RileyCornelius/PD240W/3D_models/case/fit_pcb_isometric.png

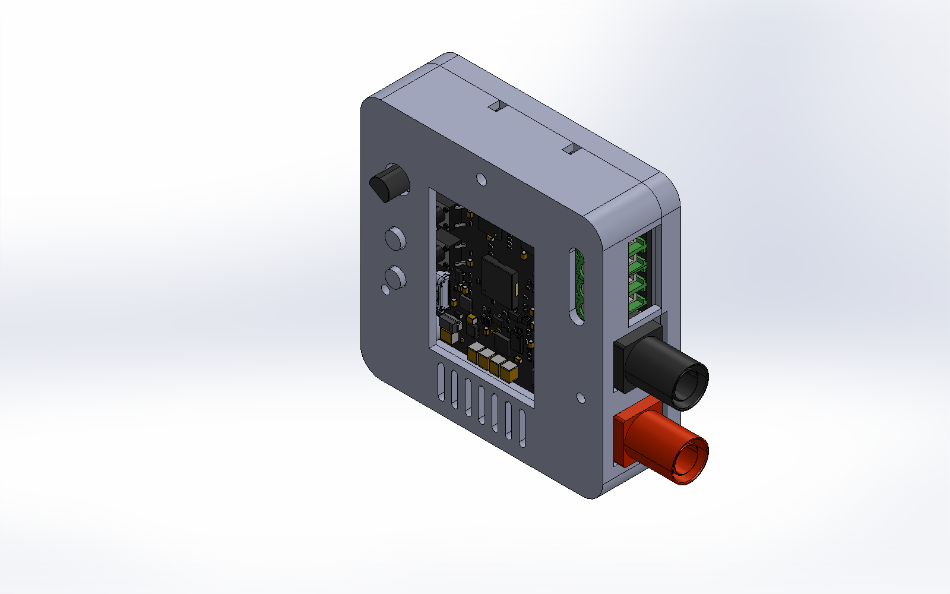
3D_models/case/fit_pcb_isometric.png
