RileyCornelius/PD240W/hardware/Images/PD240W_kicad-bottom.png

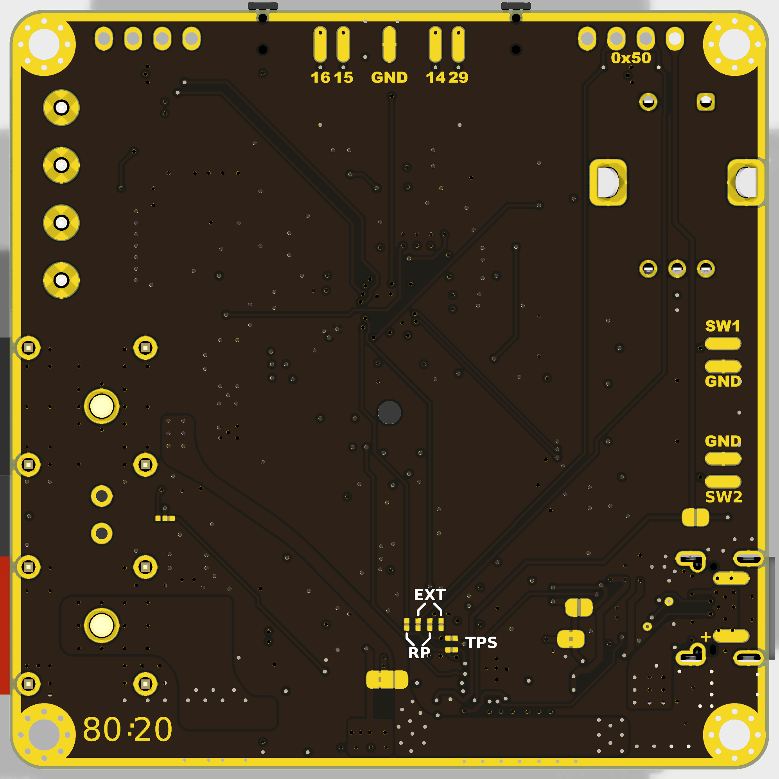
hardware/Images/PD240W_kicad-bottom.png
