RileyCornelius/PD240W/hardware/Images/PD240W_kicad-top.png

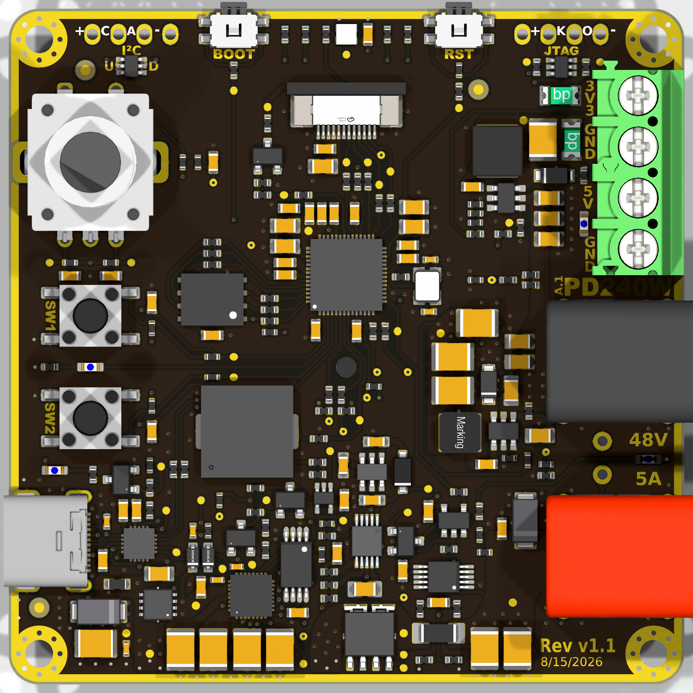
hardware/Images/PD240W_kicad-top.png
