RileyCornelius/PD240W/hardware/Manufacturing/Assembly/PD240W_kicad-bom.html

 | Bill of Materials
 | Schematic: PD240W_kicad Variant: RELEASED Revision: 1.1.0 Date: 2026-02-27 KiCad Version: 10.0.5-unknown-202607221313~667fa36054~ubuntu25.10.1 | Component Groups: 57 Component Count: 211 (per PCB) Fitted Components: 209 (per PCB) Number of PCBs: 1 Total Components: 209 (for 1 PCBs)
Row | Quantity Per PCB | References | Value | Datasheet | Footprint | Description | Manufacturer | MFR Part | Supplier Part Number
1 | 2 | C32 C33 | 15p COG 50V | https://jlcpcb.com/api/file/downloadByFileSystemAccessId/8579707286171729920 | capc_1005_06_n | Capacitor, 15pF, 5%, C0G, 50V, 1005, 0402 | FH (Guangdong Fenghua Advanced Tech)
2 | 2 | C11 C13 | 220p X7R 50V | https://jlcpcb.com/api/file/downloadByFileSystemAccessId/8588946226129604609 | capc_1005_06_l | Capacitor, 220pF, 10%, X7R, 50V, 1005, 0402 | Samsung Electro-Mechanics
3 | 3 | C1 C3 C7 | 10n X7R 100V | https://jlcpcb.com/api/file/downloadByFileSystemAccessId/8588949628376502272 | capc_1005_06_n | Capacitor, 10nF, 10%, X7R, 100V, 1005, 0402 | Yageo
4 | 32 | C4 C6 C8 C10 C16 C20 C21 C23 C24 C25 C26 C27 C30 C31 C38 C39 C40 C41 C42 C43 C44 C45 C46 C47 C48 C49 C50 C51 C52 C54 C62 C63 | 100n X7R 100V | https://jlcpcb.com/api/file/downloadByFileSystemAccessId/8586178586332446721 | capc_1608_09_l | Capacitor, 100nF, 10%, X7R, 100V, 1608, 0603 | Samsung Electro-Mechanics
5 | 13 | C2 C34 C35 C36 C37 C53 C55 C56 C57 C58 C59 C60 C61 | 1u X7R 100V | https://jlcpcb.com/api/file/downloadByFileSystemAccessId/8590904853830971392 | capc_2012_14_n | Capacitor, 1uF, 10%, X7R, 100V, 2012, 0805 | Yageo
6 | 1 | C22 | 2.2u X7R 100V | https://jlcpcb.com/api/file/downloadByFileSystemAccessId/8590916664114966528 | capc_2012_14_m | Capacitor, 2.2nF, 10%, X7R, 100V, 2012, 0805 | Chinocera
7 | 3 | C17 C18 C19 | 3.3u X5R 25V | https://jlcpcb.com/api/file/downloadByFileSystemAccessId/8590902687791857664 | capc_1608_09_n | Capacitor, 3.3uF, 20%, X5R, 25V, 1608, 0603 | CCTC
8 | 1 | C5 | 4.7u | https://jlcpcb.com/api/file/downloadByFileSystemAccessId/8588955064752869376 | capc_3225_22_n | Capacitor, 4.7 uF, 10%, X7S, 100V, 3225, 1210 | Murata Electronics
9 | 9 | C9 C12 C14 C15 C28 C29 C65 C66 C67 | 10u X7R 63V | https://jlcpcb.com/api/file/downloadByFileSystemAccessId/8589835732941770752 | capc_3225_27_n | Capacitor, 10uF, 10%, X7R, 63V, 3225, 1210 | Murata Electronics
10 | 1 | C64 | 22u X7R 25V | https://jlcpcb.com/api/file/downloadByFileSystemAccessId/8589835732941770752 | capc_3225_27_n | Capacitor, 22uF, 10%, X7R, 25V, 1210 | Samsung Electro-Mechanics
11 | 4 | D4 D7 D10 D14 | APTD1608LQBC/D | https://jlcpcb.com/api/file/downloadByFileSystemAccessId/8589837755585884160 | kingbright_0603_blue | Standard LEDs - SMD Chip LED, Package= 0603, Color = Blue | Kingbright
12 | 1 | D6 | B0520LW-7-F | https://jlcpcb.com/api/file/downloadByFileSystemAccessId/8560080535511982080 | sod-123_270x155135_n | Schottky Diodes & Rectifiers 20V 410mW, SMD, SOD123 | Diodes Incorporated
13 | 2 | D2 D3 | BZT52C18SQ | https://jlcpcb.com/api/file/downloadByFileSystemAccessId/8590197770775654400 | sod-323_230p_170x125x100_n | Zener Diode 18V 200mW 5% Surface Mount SOD-323 | JSMSEMI
14 | 2 | D5 D9 | D3V3F4U6S-7 | https://jlcpcb.com/api/file/downloadByFileSystemAccessId/8589951277003141120 | sot363_sc88_65p_200x125x110_n | 4-Ch 3.3V Low Cap TVS Array 0.85pF 3.5A 350mW | Diodes Incorporated
15 | 2 | D12 D13 | MBR1H100SFT3G | https://jlcpcb.com/api/file/downloadByFileSystemAccessId/8588886768716288000 | sod-123fl_305p_260x160x90_n | Rectifier Diode, Schottky, 1 Phase, 1A, 100V | onsemi
16 | 1 | D11 | SK6812-EC20 | https://jlcpcb.com/api/file/downloadByFileSystemAccessId/8589835384537849856 | SK6812-EC20 | RGB LED with integrated controller | OPSCO Optoelectronics
17 | 2 | D1 D8 | SMAJ48A | https://jlcpcb.com/api/file/downloadByFileSystemAccessId/8564879166429958145 | do-214ac_440p_430x250x230_n_p | Diode, TVS, Single, Unidirectional, Vrwm max 48V, Vbr min 53.3V, Vcl max 77.4V, Irm 1uA, peak puls power 400W, C 80pF @50V, IEC61000-4-2 ESD, IEC61000-4-4 EFT, IEC61000-4-5 Surge, DO-214AC, 2.9x4.6x2.65mm, -55°C ~ 150°C | hongjiacheng
18 | 1 | DSP1 | HS20HS072RX | https://jlcpcb.com/api/file/downloadByFileSystemAccessId/8590902731202768896 | generic_display_518x362x2_10mm_standoff | 240x320 (2.4") TFT-LCD panel Integrated driver (ST7789T3) and FPC | HS
19 | 2 | F1 F2 | FSMD020-1206-R | https://jlcpcb.com/api/file/downloadByFileSystemAccessId/8588906240126279680 | ptc_1206_08_n | PTC, 30V, I_ hold 200mA, I_Trip 400mA, Imax 100A, 1206 | Fuzetec Tech
20 | 1 | FB1 | BLM18SN220TH1D | https://jlcpcb.com/api/file/downloadByFileSystemAccessId/8589838767348477952 | fer_1608_09_n | Ferrite Bead, 120Ohm@100MHz, 25%, DCR 25mOhm, 1608, 0603 | Murata Electronics
21 | 2 | J5 J6 | 1935776 | https://jlcpcb.com/api/file/downloadByFileSystemAccessId/8590286408062967808 | phoenix_1935776 | 2 Position Wire to Board Terminal Block Horizontal with Board 0.197" (5.00mm) Through Hole | Phoenix Contact
22 | 1 | J3 | 24.245.1 | https://jlcpcb.com/api/file/downloadByFileSystemAccessId/8590904437944623104 | fcr7350r | 4MM PANEL SKT S16N-PC RED | Changzhou Amass Elec
23 | 1 | J4 | 24.245.2 | https://jlcpcb.com/api/file/downloadByFileSystemAccessId/8590904438813249536 | fcr7350b | 4MM PANEL SKT S16N-PC BLACK | Changzhou Amass Elec
24 | 1 | J8 | AFC07-S12FCA-00 | https://jlcpcb.com/api/file/downloadByFileSystemAccessId/8588894283646029825 | AFC07-S12FCA-00 | 0.3mm 0.5mm 12P 2mm Bottom Contact Slide Lock Surface Mount, Right Angle SMD,P=0.5mm,Surface Mount，Right Angle FFC, FPC (Flat Flexible) Connector Assemblies ROHS | JUSHUO
25 | 1 | J1 | DX07S024JJ2R1300 | https://4donline.ihs.com/images/VipMasterIC/IC/JAEI/JAEI-S-A0001615074/JAEI-S-A0001615074-1.pdf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 | DX07S024JJ2R1300 | USB Connector USB 3.2 Gen 2 TypeC Receptacle Horizontal SMT Body, Height 3.14 mm, 24 Contacts | JAE Electronics
26 | 1 | L2 | 22uH 1A 0.29Ohm | https://jlcpcb.com/api/file/downloadByFileSystemAccessId/8588893270500261888 | SWPA4030S220MT | FIXED IND 22UH 1A 292 MOHM SMD | Sunlord
27 | 1 | L1 | 33uH 1.3A 244mOhm | https://jlc-prod-smt.oss-eu-central-1.aliyuncs.com/smtDataManualFile/8588934098886791168-C9390.pdf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 | L_APV_ANR5020 | FIXED IND 33UH 1.3A 244 MOHM SMD | SXN
28 | 1 | PZ1 | FUET-9018 | https://jlcpcb.com/api/file/downloadByFileSystemAccessId/8588904050284220416 | buzzer_9x9x2.1mm | -30℃~+70℃ 1V~25V 2.1mm 3V 4kHz 5mA 65dB 9mm 9mm Passive (Externally Driven) Piezoelectric SMD, 9x9mm Buzzers ROHS | FUET
29 | 1 | Q1 | AGM612AP | https://jlcpcb.com/api/file/downloadByFileSystemAccessId/8589950125352120320 | vsonp8_65p_330x330x80_mfg | MOSFET, n-channel, 60V, r_ds_on 11mOhm, 10A @Ta=25°C, 50A @Tc=25°C, Vgs_th 1.6V, SMD PDFN-8 pin, (3.3x3.3x0.8mm), -55°C ~ 155°C (Tj) | AGM-Semi
30 | 5 | Q2 Q3 Q4 Q6 Q7 | AO3404A | https://jlcpcb.com/api/file/downloadByFileSystemAccessId/8586177430906146816 | sot-23-3L_103p_300x130x110_n | MOSFET 30V 1.4W, SOT-23-3L | Alpha & Omega Semicon
31 | 1 | Q5 | SQJB90EP-T1_GE3 | https://jlcpcb.com/api/file/downloadByFileSystemAccessId/8588924689125150720 | PowerPAKSO-8_127p_513x615x120_n | Dual NMOS transistor, 6 pin package | Vishay Intertech
32 | 1 | R29 | 8m 1% | https://jlcpcb.com/api/file/downloadByFileSystemAccessId/8590227465076842496 | WSLP1206_n_current_sense_6m_to_50m | Resistor, 8m, 1%, 50ppm, 1W, 3216, 1206 | Milliohm
33 | 1 | R79 | 3.9R 1% | https://jlcpcb.com/api/file/downloadByFileSystemAccessId/8590208739052445696 | resc_1005_04_m | Resistor, 3.9R, 1%, 200ppm, 1/16W, 1005, 0402 | FOJAN
34 | 29 | R18 R28 R30 R31 R37 R38 R39 R40 R41 R42 R43 R44 R45 R46 R48 R49 R50 R51 R52 R56 R57 R58 R59 R60 R61 R62 R63 R65 R77 | 27R 1% | https://jlcpcb.com/api/file/downloadByFileSystemAccessId/8588899757724995584 | resc_1005_04_m | Resistor, 27R, 1%, 100ppm, 1/16W, 1005, 0402 | Yageo
35 | 3 | R21 R67 R71 | 330R 1% | https://jlcpcb.com/api/file/downloadByFileSystemAccessId/8579706017514917888 | resc_1005_04_m | Resistor, 330R, 1%, 100ppm, 1/16W, 1005, 0402 | UNI-ROYAL(Uniroyal Elec)
36 | 8 | R6 R36 R47 R53 R54 R55 R64 R90 | 1k 1% | https://jlcpcb.com/api/file/downloadByFileSystemAccessId/8579705924167974912 | resc_1005_04_m | Resistor, 1k, 1%, 100ppm, 1/16W, 1005, 0402 | UNI-ROYAL(Uniroyal Elec)
37 | 8 | R7 R8 R10 R11 R17 R26 R32 R83 | 4.7k 1% | https://jlcpcb.com/api/file/downloadByFileSystemAccessId/8579705919464263680 | resc_1005_04_m | Resistor, 4.7k, 1%, 100ppm, 1/16W, 1005, 0402 | UNI-ROYAL(Uniroyal Elec)
38 | 16 | R2 R9 R12 R16 R24 R35 R66 R69 R70 R72 R73 R76 R85 R86 R87 R89 | 10k 1% | https://jlcpcb.com/api/file/downloadByFileSystemAccessId/8556212101498380288 | resc_1005_04_n | Resistor, 10k, 1%, ±25ppm, 1/16W, 1005, 0402 | UNI-ROYAL(Uniroyal Elec)
39 | 9 | R1 R5 R33 R34 R68 R74 R75 R82 R88 | 33k 1% | https://jlcpcb.com/api/file/downloadByFileSystemAccessId/8671329089120387072 | resc_1005_04_n | Resistor, 33k, 1%, 100ppm, 1/16W, 1005, 0402 | Yageo
40 | 14 | R3 R4 R13 R14 R15 R19 R20 R22 R23 R25 R78 R80 R81 R84 | 100k 1% | https://jlcpcb.com/api/file/downloadByFileSystemAccessId/8579705919464263680 | resc_1005_04_m | Resistor, 100k, 1%, 100ppm, 1/16W, 1005, 0402 | UNI-ROYAL(Uniroyal Elec)
41 | 1 | R27 | 10k @25°C | https://jlcpcb.com/api/file/downloadByFileSystemAccessId/8588905414750572545 | resc_1005_04_m | NTC Thermistors 10k @25°C, B3950, 0.33mA max | Sunlord
42 | 2 | S1 S2 | EVQ-PUC02K | https://jlcpcb.com/api/file/downloadByFileSystemAccessId/8588918409580974080 | EVQPUC02K | Small-sized Side-operational SMD Light Touch Switches with straight terminals, with boss. | Panasonic
43 | 2 | S3 S5 | GT-TC120A-H120-L1 | https://jlcpcb.com/api/file/downloadByFileSystemAccessId/8588904166035374080 | GT-TC120A-H120-L1 | Tactile switch SMD, black round button 12mm. | G-Switch
44 | 1 | S4 | PEC11R-4215F-S0024 | https://jlcpcb.com/api/file/downloadByFileSystemAccessId/8588891509874049024 | PEC11R-4215F-S0024 | Rotary Encoders 15mm SHAFT w/SWITCH 24 detents, 24 PPR | Bourns
45 | 1 | U5 | 74LVC1G08SE-7 | https://jlcpcb.com/api/file/downloadByFileSystemAccessId/8588934949626130432 | sot353_65p_200x125x110_mo-203-aa_n | Single 2-input AND gate | Diodes Incorporated
46 | 1 | U3 | CAT24C512YI-GT3 | https://jlcpcb.com/api/file/downloadByFileSystemAccessId/8588881550012796928 | JEDEC_MO-153_AA | 512 Kb I2C CMOS Serial | Onsemi
47 | 1 | U7 | INA228AIDGSR | https://www.ti.com/lit/ds/symlink/ina228.pdf | vssop10_50p_300x300x110_mfg | INA240 High- and Low-Side, Bidirectional, Zero-Drift, Current-Sense Amplifier with | Texas Instruments
48 | 1 | U4 | LM2765 | https://www.ti.com/cn/lit/ds/symlink/lm2765.pdf?ts=1773109320900 | sot236_p95_290x160x110_n | Switched-Capacitor Voltage Converter, 40mA, input 1.8-5.5V, out =2xVIN, 50kHz, SOT-23, -40°C~+85°C | Texas Instruments
49 | 2 | U11 U12 | LMR16006XDDCR | https://www.ti.com/cn/lit/ds/symlink/lmr16006.pdf?ts=1773033603279 | sot6_p95_290x180x110_n | LMR16006 SIMPLE SWITCHER® 60 V 0.6 A Buck Regulators With High Efficiency ECO mode, 600mA, input 4-65V, out 4-65V, 700kHz, SOT-6, -40°C~+125°C | Texas Instruments
50 | 1 | U6 | LTC7004x | https://jlcpcb.com/api/file/downloadByFileSystemAccessId/8588908169414520832 | msop_10p_300x490x110_tp168x188_n | Fast 60V High Side NMOS Static Switch Driver. | Analog Devices
51 | 1 | U10 | RP2040 | https://pip-assets.raspberrypi.com/categories/814-rp2040/documents/RP-008371-DS-1-rp2040-datasheet.pdf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 | qfn56_40p_700x700x90_tp_320x320_mfg | ARM® Cortex-M0+ - Microcontroller IC 32-Bit Dual-Core 133MHz External Program Memory 56-QFN (7x7) | Raspberry Pi
52 | 1 | U8 | SN74LVC1G17DBVR | https://www.ti.com/lit/ds/symlink/sn74lvc1g17.pdf?ts=1773125655769 | sot25_95p_300x280x145_jedec_mo-178-aa_n | SN74LVC1G17 Single Schmitt-Trigger Buffer | Texas Instruments
53 | 1 | U1 | TPD4S480RUKR | https://www.ti.com/lit/ds/symlink/tpd4s480.pdf?ts=1773161250726 | wqfn20_40p_300x300x80_tp_170x170_n | USB Type-C™ 48V EPR port protector with short-to-VBUS overvoltage and IEC ESD protection 20-WQFN -40 to 125 | Texas Instrument
54 | 1 | U2 | TPS26750SRSMR | https://www.ti.com/lit/ds/symlink/tps26750.pdf | qfn32_40p_400x400x100_tp_280x280_mfg | TPS26750 USB Type-C® and USB PD Controller With Integrated Power Switches | Texas Instruments
55 | 1 | U9 | W25Q128JVPIQ | https://jlcpcb.com/api/file/downloadByFileSystemAccessId/8588881960005472256 | wson8_127p_600x500x80_tp_435x340_n | 3V 128M-BIT SERIAL FLASH MEMORY WITH DUAL/QUAD SPI | Winbond Electronics
56 | 1 | Y1 | ABM8-272-T3 | https://jlcpcb.com/api/file/downloadByFileSystemAccessId/8559470777180311552 | osccc_320x205x80_abm8 | Crystal 12MHz 10pF 30ppm -40C +85C | Abracon LLC
Row | Quantity Per PCB | References | Value | Datasheet | Footprint | Description | Manufacturer | MFR Part | Supplier Part Number
1 | 2 | J2 J7 | 61300411121 | https://www.we-online.com/components/products/datasheet/61300411121.pdf | we_61300411121 | Pin header, 2.54mm pitch, 4 Position, 1 Row, 8.64mm Height, Male | WÜRTH ELEKTRONIK
Color reference for columns:
KiCad Fields (default)
Generated Fields
User Fields
Empty Fields
