RileyCornelius/PD240W/hardware/production/bom.csv

Designator | Footprint | Quantity | Value | LCSC Part #
C1, C3, C7 | capc_1005_06_n | 3 | 10n X7R 100V | C527014
C10, C16, C20, C21, C23, C24, C25, C26, C27, C30, C31, C38, C39, C4, C40, C41, C42, C43, C44, C45, C46, C47, C48, C49, C50, C51, C52, C54, C6, C62, C63, C8 | capc_1608_09_l | 32 | 100n X7R 100V | C15725
C11, C13 | capc_1005_06_l | 2 | 220p X7R 50V | C296710
C12, C14, C15, C28, C29, C65, C66, C67, C9 | capc_3225_27_n | 9 | 10u X7R 63V | C437568
C17, C18, C19 | capc_1608_09_n | 3 | 3.3u X5R 25V | C5360803
C2, C34, C35, C36, C37, C53, C55, C56, C57, C58, C59, C60, C61 | capc_2012_14_n | 13 | 1u X7R 100V | C5370002
C22 | capc_2012_14_m | 1 | 2.2u X7R 100V | C22367838
C32, C33 | capc_1005_06_n | 2 | 15p COG 50V | C1548
C5 | capc_3225_22_n | 1 | 4.7u | C913445
C64 | capc_3225_27_n | 1 | 22u X7R 25V | C309062
D1, D8 | do-214ac_440p_430x250x230_n_p | 2 | SMAJ48A | C41376401
D10, D14, D4, D7 | kingbright_0603_blue | 4 | APTD1608LQBC/D | C5344742
D11 | SK6812-EC20 | 1 | SK6812-EC20 | C2909058
D12, D13 | sod-123fl_305p_260x160x90_n | 2 | MBR1H100SFT3G | C235757
D2, D3 | sod-323_230p_170x125x100_n | 2 | BZT52C18SQ | C2857090
D5, D9 | sot363_sc88_65p_200x125x110_n | 2 | D3V3F4U6S-7 | C1869321
D6 | sod-123_270x155135_n | 1 | B0520LW-7-F | C155367
DSP1 | generic_display_518x362x2_10mm_standoff | 1 | HS20HS072RX | C5329582
F1, F2 | ptc_1206_08_n | 2 | FSMD020-1206-R | C220145
FB1 | fer_1608_09_n | 1 | BLM18SN220TH1D | C710392
J1 | DX07S024JJ2R1300 | 1 | DX07S024JJ2R1300 | C2977282
J3 | fcr7350r | 1 | 24.245.1 | C7437326
J4 | fcr7350b | 1 | 24.245.2 | C7437327
J5, J6 | phoenix_1935776 | 2 | 1935776 | C3817389
J8 | AFC07-S12FCA-00 | 1 | AFC07-S12FCA-00 | C262559
L1 | L_APV_ANR5020 | 1 | 33uH 1.3A 244mOhm | C9390
L2 | SWPA4030S220MT | 1 | 22uH 1A 0.29Ohm | C83472
PZ1 | buzzer_9x9x2.1mm | 1 | FUET-9018 | C391035
Q1 | vsonp8_65p_330x330x80_mfg | 1 | AGM612AP | C5349119
Q2, Q3, Q4, Q6, Q7 | sot-23-3L_103p_300x130x110_n | 5 | AO3404A | C30010
Q5 | PowerPAKSO-8_127p_513x615x120_n | 1 | SQJB90EP-T1_GE3 | C727731
R1, R33, R34, R5, R68, R74, R75, R82, R88 | resc_1005_04_n | 9 | 33k 1% | C138003
R10, R11, R17, R26, R32, R7, R8, R83 | resc_1005_04_m | 8 | 4.7k 1% | C25900
R12, R16, R2, R24, R35, R66, R69, R70, R72, R73, R76, R85, R86, R87, R89, R9 | resc_1005_04_n | 16 | 10k 1% | C25744
R13, R14, R15, R19, R20, R22, R23, R25, R3, R4, R78, R80, R81, R84 | resc_1005_04_m | 14 | 100k 1% | C25741
R18, R28, R30, R31, R37, R38, R39, R40, R41, R42, R43, R44, R45, R46, R48, R49, R50, R51, R52, R56, R57, R58, R59, R60, R61, R62, R63, R65, R77 | resc_1005_04_m | 29 | 27R 1% | C138021
R21, R67, R71 | resc_1005_04_m | 3 | 330R 1% | C25104
R27 | resc_1005_04_m | 1 | 10k @25°C | C95939
R29 | WSLP1206_n_current_sense_6m_to_50m | 1 | 8m 1% | C2988654
R36, R47, R53, R54, R55, R6, R64, R90 | resc_1005_04_m | 8 | 1k 1% | C11702
R79 | resc_1005_04_m | 1 | 3.9R 1% | C2933095
S1, S2 | EVQPUC02K | 2 | EVQ-PUC02K | C2936858
S3, S5 | GT-TC120A-H120-L1 | 2 | GT-TC120A-H120-L1 | C2762973
S4 | PEC11R-4215F-S0024 | 1 | PEC11R-4215F-S0024 | C143790
U1 | wqfn20_40p_300x300x80_tp_170x170_n | 1 | TPD4S480RUKR | C43131250
U10 | qfn56_40p_700x700x90_tp_320x320_mfg | 1 | RP2040 | C2040
U11, U12 | sot6_p95_290x180x110_n | 2 | LMR16006XDDCR | C87080
U2 | qfn32_40p_400x400x100_tp_280x280_mfg | 1 | TPS26750SRSMR | C42166327
U3 | JEDEC_MO-153_AA | 1 | CAT24C512YI-GT3 | C56096
U4 | sot236_p95_290x160x110_n | 1 | LM2765 | C140270
U5 | sot353_65p_200x125x110_mo-203-aa_n | 1 | 74LVC1G08SE-7 | C460522
U6 | msop_10p_300x490x110_tp168x188_n | 1 | LTC7004x | C690105
U7 | vssop10_50p_300x300x110_mfg | 1 | INA228AIDGSR | C5214669
U8 | sot25_95p_300x280x145_jedec_mo-178-aa_n | 1 | SN74LVC1G17DBVR | C7836
U9 | wson8_127p_600x500x80_tp_435x340_n | 1 | W25Q128JVPIQ | C2441427
Y1 | osccc_320x205x80_abm8 | 1 | ABM8-272-T3 | C20625731
