RileyCornelius/PD240W/PCB_files/production/PD240W_BOM_costed.xlsx

Sheet: Summary
PD240W - BOM cost summary
Yellow cells are inputs. Change a build size and every price on the BOM tab re-looks-up its volume tier.
Build sizes (boards)
Build A | 1
Build B | 10
Build C | 100
Board content
Unique line items (distinct LCSC parts) | 56
Total placements per board | 209
Basic-library parts | 6
Preferred-library parts | 1
Extended-library parts (extra JLC setup fee each) | 49
Component cost
Build size (boards) | Total BOM cost | Cost per board
1 | $58.80 | $58.80
10 | $522.61 | $52.26
100 | $4489.81 | $44.90
Supply risk
Parts out of stock at JLC | 1
Parts short of the 10-board need | 1
Parts short of the 100-board need | 2
Excluded from these figures: PCB fabrication, assembly, stencil, setup and extended-part fees, shipping, duty.
Price source: JLCPCB/LCSC parts API, retrieved 2026-08-23. Quantities: KiCad export PCB_files/production/bom.csv (rev 1.1.0).

Sheet: BOM
PD240W - PCB Bill of Materials (JLCPCB / LCSC pricing)
Prices in USD from LCSC/JLCPCB volume tiers. Unit price is looked up from the Price Tiers tab against the total quantity that build size requires. Source: JLCPCB parts API, retrieved 2026-08-23.
# | Designators | Qty/Bd | Value (KiCad) | Footprint | LCSC # | Manufacturer Part No. | Manufacturer | Package | JLC Library | JLC Stock | Description | Unit $ @ 1 bd | Ext $ @ 1 bd | Unit $ @ 10 bd | Ext $ @ 10 bd | Unit $ @ 100 bd | Ext $ @ 100 bd | Stock Status | LCSC Link
1 | C1, C3, C7 | 3 | 10n X7R 100V | capc_1005_06_n | C527014 | CC0402KRX7R0BB103 | YAGEO | 0402 | Extended | 338390 | Cap 10nF 100V X7R ±10% | $0.0129 | $0.04 | $0.0129 | $0.39 | $0.0129 | $3.87 | OK | LCSC (https://www.lcsc.com/product-detail/multilayer-ceramic-capacitors-mlcc-smd-smt_yageo-cc0402krx7r0bb103_C527014.html)
2 | C2, C34, C35, C36, C37, C53, C55, C56, C57, C58, C59, C60, C61 | 13 | 1u X7R 100V | capc_2012_14_n | C5370002 | CC0805KKX7R0BB105 | YAGEO | 0805 | Extended | 436703 | Cap 1uF 100V X7R ±10% | $0.1064 | $1.38 | $0.0941 | $12.23 | $0.0877 | $114.01 | OK | LCSC (https://www.lcsc.com/product-detail/multilayer-ceramic-capacitors-mlcc-smd-smt_yageo-cc0805kkx7r0bb105_C5370002.html)
3 | C5 | 1 | 4.7u | capc_3225_22_n | C913445 | GCM32DC72A475KE02L | Murata Electronics | 1210 | Extended | 53357 | Cap 4.7uF 100V X7S ±10% | $0.9111 | $0.91 | $0.8056 | $8.06 | $0.7032 | $70.32 | OK | LCSC (https://www.lcsc.com/product-detail/multilayer-ceramic-capacitors-mlcc-smd-smt_murata-electronics-gcm32dc72a475ke02l_C913445.html)
4 | C4, C6, C8, C10, C16, C20, C21, C23, C24, C25, C26, C27, C30, C31, C38, C39, C40, C41, C42, C43, C44, C45, C46, C47, C48, C49, C50, C51, C52, C54, C62, C63 | 32 | 100n X7R 100V | capc_1608_09_l | C15725 | CL10B104KC8NNNC | Samsung Electro-Mechanics | 0603 | Extended | 1233663 | Cap 100nF 100V X7R ±10% | $0.0157 | $0.50 | $0.0157 | $5.02 | $0.0104 | $33.28 | OK | LCSC (https://www.lcsc.com/product-detail/multilayer-ceramic-capacitors-mlcc-smd-smt_samsung-electro-mechanics-cl10b104kc8nnnc_C15725.html)
5 | C11, C13 | 2 | 220p X7R 50V | capc_1005_06_l | C296710 | CL05B221KB5NNNC | Samsung Electro-Mechanics | 0402 | Extended | 119508 | Cap 220pF 50V X7R ±10% | $0.0056 | $0.01 | $0.0056 | $0.11 | $0.0056 | $1.12 | OK | LCSC (https://www.lcsc.com/product-detail/multilayer-ceramic-capacitors-mlcc-smd-smt_samsung-electro-mechanics-cl05b221kb5nnnc_C296710.html)
6 | C9, C12, C14, C15, C28, C29, C65, C66, C67 | 9 | 10u X7R 63V | capc_3225_27_n | C437568 | GRM32ER71J106KA12L | Murata Electronics | 1210 | Extended | 29931 | Cap 10uF 63V X7R ±10% | $0.9046 | $8.14 | $0.7406 | $66.65 | $0.6805 | $612.45 | OK | LCSC (https://www.lcsc.com/product-detail/multilayer-ceramic-capacitors-mlcc-smd-smt_murata-electronics-grm32er71j106ka12l_C437568.html)
7 | C17, C18, C19 | 3 | 3.3u X5R 25V | capc_1608_09_n | C5360803 | TCC0603X5R335M250CT | CCTC | 0603 | Extended | 101843 | Cap 3.3uF 25V X5R ±20% | $0.0270 | $0.08 | $0.0270 | $0.81 | $0.0215 | $6.45 | OK | LCSC (https://www.lcsc.com/product-detail/multilayer-ceramic-capacitors-mlcc-smd-smt_cctc-tcc0603x5r335m250ct_C5360803.html)
8 | C22 | 1 | 2.2u X7R 100V | capc_2012_14_m | C22367838 | HHV0805R7225K101NSLJ | Chinocera | 0805 | Extended | 103869 | Cap 2.2uF 100V X7R ±10% | $0.3557 | $0.36 | $0.2745 | $2.75 | $0.1998 | $19.98 | OK | LCSC (https://www.lcsc.com/product-detail/multilayer-ceramic-capacitors-mlcc-smd-smt_chinocera-hhv0805r7225k101nslj_C22367838.html)
9 | C32, C33 | 2 | 15p COG 50V | capc_1005_06_n | C1548 | 0402CG150J500NT | FH (Guangdong Fenghua) | 0402 | Basic | 2022686 | Cap 15pF 50V C0G ±5% | $0.0047 | $0.01 | $0.0047 | $0.09 | $0.0047 | $0.94 | OK | LCSC (https://www.lcsc.com/product-detail/multilayer-ceramic-capacitors-mlcc-smd-smt_fh-guangdong-fenghua-advanced-tech-0402cg150j500nt_C1548.html)
10 | C64 | 1 | 22u X7R 25V | capc_3225_27_n | C309062 | CL32B226KAJNNNE | Samsung Electro-Mechanics | 1210 | Extended | 349290 | Cap 22uF 25V X7R ±10% | $0.3703 | $0.37 | $0.2979 | $2.98 | $0.2311 | $23.11 | OK | LCSC (https://www.lcsc.com/product-detail/multilayer-ceramic-capacitors-mlcc-smd-smt_samsung-electro-mechanics-cl32b226kajnnne_C309062.html)
11 | D1, D8 | 2 | SMAJ48A | do-214ac_440p_430x250x230_n_p | C41376401 | SMAJ48A | hongjiacheng | DO-214AC (SMA) | Preferred | 34117 | TVS diode 48V 400W unidirectional | $0.0372 | $0.07 | $0.0372 | $0.74 | $0.0294 | $5.88 | OK | LCSC (https://www.lcsc.com/product-detail/esd-and-surge-protection-tvs-esd_hongjiacheng-smaj48a_C41376401.html)
12 | D2, D3 | 2 | BZT52C18SQ | sod-323_230p_170x125x100_n | C2857090 | BZT52C18SQ | JSMSEMI | SOD-323 | Extended | 174 | Zener diode 18V 200mW | $0.0192 | $0.04 | $0.0192 | $0.38 | $0.0192 | $3.84 | Tight - under 100-board need | LCSC (https://www.lcsc.com/product-detail/zener-diodes_jsmsemi-bzt52c18sq_C2857090.html)
13 | D5, D9 | 2 | D3V3F4U6S-7 | sot363_sc88_65p_200x125x110_n | C1869321 | D3V3F4U6S-7 | Diodes Incorporated | SOT-363 | Extended | 88 | ESD array 4-ch 3.3V 0.85pF | $0.1988 | $0.40 | $0.1988 | $3.98 | $0.1922 | $38.44 | Tight - under 100-board need | LCSC (https://www.lcsc.com/product-detail/esd-and-surge-protection-tvs-esd_diodes-incorporated-d3v3f4u6s-7_C1869321.html)
14 | D6 | 1 | B0520LW-7-F | sod-123_270x155135_n | C155367 | B0520LW-7-F | Diodes Incorporated | SOD-123 | Extended | 67460 | Schottky diode 20V 500mA | $0.1272 | $0.13 | $0.1272 | $1.27 | $0.1030 | $10.30 | OK | LCSC (https://www.lcsc.com/product-detail/schottky-diodes_diodes-incorporated-b0520lw-7-f_C155367.html)
15 | D4, D7, D10, D14 | 4 | APTD1608LQBC/D | kingbright_0603_blue | C5344742 | APTD1608LQBC/D | Kingbright | 0603 | Extended | 1917 | LED blue 465nm 20mcd | $0.3013 | $1.21 | $0.3013 | $12.05 | $0.2045 | $81.80 | OK | LCSC (https://www.lcsc.com/product-detail/led-indication-discrete_kingbright-aptd1608lqbc-d_C5344742.html)
16 | D11 | 1 | SK6812-EC20 | SK6812-EC20 | C2909058 | SK6812-EC20 | OPSCO Optoelectronics | SMD 2x2mm | Extended | 10625 | RGB LED with built-in controller | $0.1102 | $0.11 | $0.1102 | $1.10 | $0.0882 | $8.82 | OK | LCSC (https://www.lcsc.com/product-detail/rgb-leds-built-in-ic_opsco-optoelectronics-sk6812-ec20_C2909058.html)
17 | D12, D13 | 2 | MBR1H100SFT3G | sod-123fl_305p_260x160x90_n | C235757 | MBR1H100SFT3G | onsemi | SOD-123FL | Extended | 13097 | Schottky diode 100V 1A | $0.2565 | $0.51 | $0.2565 | $5.13 | $0.1865 | $37.30 | OK | LCSC (https://www.lcsc.com/product-detail/schottky-diodes_onsemi-mbr1h100sft3g_C235757.html)
18 | DSP1 | 1 | HS20HS072RX | generic_display_518x362x2_10mm_standoff | C5329582 | HS20HS072RX | HS | LCD module | Extended | 3005 | LCD 2.0in 320x240 ST7789 SPI | $3.5891 | $3.59 | $3.0532 | $30.53 | $2.4133 | $241.33 | OK | LCSC (https://www.lcsc.com/product-detail/lcd-screen_hs-hs20hs072rx_C5329582.html)
19 | F1, F2 | 2 | FSMD020-1206-R | ptc_1206_08_n | C220145 | FSMD020-1206-R | Fuzetec Tech | 1206 | Extended | 32902 | PTC resettable fuse 200mA 30V | $0.0687 | $0.14 | $0.0687 | $1.37 | $0.0553 | $11.06 | OK | LCSC (https://www.lcsc.com/product-detail/resettable-fuses_fuzetec-tech-fsmd020-1206-r_C220145.html)
20 | FB1 | 1 | BLM18SN220TH1D | fer_1608_09_n | C710392 | BLM18SN220TH1D | Murata Electronics | 0603 | Extended | 1016 | Ferrite bead 22R@100MHz 8A | $0.2130 | $0.21 | $0.2130 | $2.13 | $0.1828 | $18.28 | OK | LCSC (https://www.lcsc.com/product-detail/ferrite-beads_murata-electronics-blm18sn220th1d_C710392.html)
21 | J1 | 1 | DX07S024JJ2R1300 | DX07S024JJ2R1300 | C2977282 | DX07S024JJ2R1300 | JAE Electronics | SMD | Extended | 3128 | USB Type-C receptacle 24P 48V | $0.7227 | $0.72 | $0.7227 | $7.23 | $0.7227 | $72.27 | OK | LCSC (https://www.lcsc.com/product-detail/usb-connectors_jae-electronics-dx07s024jj2r1300_C2977282.html)
22 | J3 | 1 | 24.245.1 | fcr7350r | C7437326 | 24.245.1 | Changzhou Amass Elec | Through hole | Extended | 8050 | 4mm banana socket red 24A | $1.2830 | $1.28 | $1.2132 | $12.13 | $1.2132 | $121.32 | OK | LCSC (https://www.lcsc.com/product-detail/banana-connectors-alligator-clips_changzhou-amass-elec-24-245-1_C7437326.html)
23 | J4 | 1 | 24.245.2 | fcr7350b | C7437327 | 24.245.2 | Changzhou Amass Elec | Through hole | Extended | 10675 | 4mm banana socket black 24A | $1.2083 | $1.21 | $1.1385 | $11.38 | $1.1385 | $113.85 | OK | LCSC (https://www.lcsc.com/product-detail/banana-connectors-alligator-clips_changzhou-amass-elec-24-245-2_C7437327.html)
24 | J5, J6 | 2 | 1935776 | phoenix_1935776 | C3817389 | 1935776 | Phoenix Contact | THT P=5mm | Extended | 513 | Screw terminal block 2P 5mm 20A | $0.5814 | $1.16 | $0.4726 | $9.45 | $0.4190 | $83.80 | OK | LCSC (https://www.lcsc.com/product-detail/screw-terminal-blocks_phoenix-contact-1935776_C3817389.html)
25 | J8 | 1 | AFC07-S12FCA-00 | AFC07-S12FCA-00 | C262559 | AFC07-S12FCA-00 | JUSHUO | SMD P=0.5mm | Extended | 53351 | FPC connector 12P 0.5mm | $0.0960 | $0.10 | $0.0960 | $0.96 | $0.0751 | $7.51 | OK | LCSC (https://www.lcsc.com/product-detail/ffc-fpc-flat-flexible-connector-assemblies_jushuo-afc07-s12fca-00_C262559.html)
26 | L1 | 1 | 33uH 1.3A 244mOhm | L_APV_ANR5020 | C9390 | SMNR5040-330MT | SXN (Shun Xiang Nuo) | SMD 5x5mm | Extended | 4719 | Power inductor 33uH 1.1A 244mR | $0.0848 | $0.08 | $0.0848 | $0.85 | $0.0670 | $6.70 | OK | LCSC (https://www.lcsc.com/product-detail/power-inductors_sxn-shun-xiang-nuo-elec-smnr5040-330mt_C9390.html)
27 | L2 | 1 | 22uH 1A 0.29Ohm | SWPA4030S220MT | C83472 | SWPA4030S220MT | Sunlord | SMD 4x4mm | Extended | 82473 | Power inductor 22uH 1A 292mR | $0.0613 | $0.06 | $0.0613 | $0.61 | $0.0494 | $4.94 | OK | LCSC (https://www.lcsc.com/product-detail/power-inductors_sunlord-swpa4030s220mt_C83472.html)
28 | PZ1 | 1 | FUET-9018 | buzzer_9x9x2.1mm | C391035 | FUET-9018 | FUET | SMD 9x9mm | Extended | 1105 | Piezo buzzer passive 4kHz 65dB | $0.5620 | $0.56 | $0.4531 | $4.53 | $0.3443 | $34.43 | OK | LCSC (https://www.lcsc.com/product-detail/buzzers_fuet-fuet-9018_C391035.html)
29 | Q1 | 1 | AGM612AP | vsonp8_65p_330x330x80_mfg | C5349119 | AGM612AP | AGM-Semi | PDFN-8 (3.3x3.3) | Extended | 4953 | MOSFET N-ch 60V 50A 11mR | $0.2488 | $0.25 | $0.2488 | $2.49 | $0.1998 | $19.98 | OK | LCSC (https://www.lcsc.com/product-detail/mosfets_agm-semi-agm612ap_C5349119.html)
30 | Q2, Q3, Q4, Q6, Q7 | 5 | AO3404A | sot-23-3L_103p_300x130x110_n | C30010 | AO3404A | Alpha & Omega Semicon | SOT-23 | Extended | 33923 | MOSFET N-ch 30V 5.8A | $0.1061 | $0.53 | $0.0827 | $4.13 | $0.0622 | $31.10 | OK | LCSC (https://www.lcsc.com/product-detail/mosfets_alpha-omega-semicon-ao3404a_C30010.html)
31 | Q5 | 1 | SQJB90EP-T1_GE3 | PowerPAKSO-8_127p_513x615x120_n | C727731 | SQJB90EP-T1_GE3 | Vishay Intertech | PowerPAK SO-8L | Extended | 224 | MOSFET dual N-ch 80V 30A | $1.5835 | $1.58 | $1.2960 | $12.96 | $0.9582 | $95.82 | OK | LCSC (https://www.lcsc.com/product-detail/mosfets_vishay%20intertech_sqjb90ep-t1_ge3_C727731.html)
32 | R1, R5, R33, R34, R68, R74, R75, R82, R88 | 9 | 33k 1% | resc_1005_04_n | C138003 | RC0402FR-0733KL | YAGEO | 0402 | Extended | 986006 | Resistor 33k 1% 62.5mW | $0.0040 | $0.04 | $0.0040 | $0.36 | $0.0040 | $3.60 | OK | LCSC (https://www.lcsc.com/product-detail/chip-resistor-surface-mount_yageo-rc0402fr-0733kl_C138003.html)
33 | R7, R8, R10, R11, R17, R26, R32, R83 | 8 | 4.7k 1% | resc_1005_04_m | C25900 | 0402WGF4701TCE | UNI-ROYAL | 0402 | Basic | 21948814 | Resistor 4.7k 1% 62.5mW | $0.0049 | $0.04 | $0.0049 | $0.39 | $0.0049 | $3.92 | OK | LCSC (https://www.lcsc.com/product-detail/chip-resistor-surface-mount_uni-royal-uniroyal-elec-0402wgf4701tce_C25900.html)
34 | R2, R9, R12, R16, R24, R35, R66, R69, R70, R72, R73, R76, R85, R86, R87, R89 | 16 | 10k 1% | resc_1005_04_n | C25744 | 0402WGF1002TCE | UNI-ROYAL | 0402 | Basic | 22320410 | Resistor 10k 1% 62.5mW | $0.0019 | $0.03 | $0.0019 | $0.30 | $0.0017 | $2.72 | OK | LCSC (https://www.lcsc.com/product-detail/chip-resistor-surface-mount_uni-royal-uniroyal-elec-0402wgf1002tce_C25744.html)
35 | R3, R4, R13, R14, R15, R19, R20, R22, R23, R25, R78, R80, R81, R84 | 14 | 100k 1% | resc_1005_04_m | C25741 | 0402WGF1003TCE | UNI-ROYAL | 0402 | Basic | 14732071 | Resistor 100k 1% 62.5mW | $0.0053 | $0.07 | $0.0053 | $0.74 | $0.0048 | $6.72 | OK | LCSC (https://www.lcsc.com/product-detail/chip-resistor-surface-mount_uni-royal-uniroyal-elec-0402wgf1003tce_C25741.html)
36 | R18, R28, R30, R31, R37, R38, R39, R40, R41, R42, R43, R44, R45, R46, R48, R49, R50, R51, R52, R56, R57, R58, R59, R60, R61, R62, R63, R65, R77 | 29 | 27R 1% | resc_1005_04_m | C138021 | RC0402FR-0727RL | YAGEO | 0402 | Extended | 172532 | Resistor 27R 1% 62.5mW | $0.0040 | $0.12 | $0.0040 | $1.16 | $0.0033 | $9.57 | OK | LCSC (https://www.lcsc.com/product-detail/chip-resistor-surface-mount_yageo-rc0402fr-0727rl_C138021.html)
37 | R21, R67, R71 | 3 | 330R 1% | resc_1005_04_m | C25104 | 0402WGF3300TCE | UNI-ROYAL | 0402 | Basic | 1809095 | Resistor 330R 1% 62.5mW | $0.0072 | $0.02 | $0.0072 | $0.22 | $0.0072 | $2.16 | OK | LCSC (https://www.lcsc.com/product-detail/chip-resistor-surface-mount_uni-royal-uniroyal-elec-0402wgf3300tce_C25104.html)
38 | R27 | 1 | 10k @25°C | resc_1005_04_m | C95939 | SDNT1005X103F3950FTF | Sunlord | 0402 | Extended | 105900 | NTC thermistor 10k B3950 1% | $0.0166 | $0.02 | $0.0166 | $0.17 | $0.0166 | $1.66 | OK | LCSC (https://www.lcsc.com/product-detail/ntc-thermistors_sunlord-sdnt1005x103f3950ftf_C95939.html)
39 | R29 | 1 | 8m 1% | WSLP1206_n_current_sense_6m_to_50m | C2988654 | HoLLR1206-1W-8mR-1% | Milliohm | 1206 | Extended | 8317 | Current sense resistor 8mR 1W 1% | $0.0546 | $0.05 | $0.0546 | $0.55 | $0.0462 | $4.62 | OK | LCSC (https://www.lcsc.com/product-detail/current-sense-resistors-shunt-resistors_milliohm-hollr1206-1w-8mr-1_C2988654.html)
40 | R6, R36, R47, R53, R54, R55, R64, R90 | 8 | 1k 1% | resc_1005_04_m | C11702 | 0402WGF1001TCE | UNI-ROYAL | 0402 | Basic | 15407931 | Resistor 1k 1% 62.5mW | $0.0067 | $0.05 | $0.0067 | $0.54 | $0.0067 | $5.36 | OK | LCSC (https://www.lcsc.com/product-detail/chip-resistor-surface-mount_uni-royal-uniroyal-elec-0402wgf1001tce_C11702.html)
41 | R79 | 1 | 3.9R 1% | resc_1005_04_m | C2933095 | FRC0402F3R90TS | FOJAN | 0402 | Extended | 12122 | Resistor 3.9R 1% 62.5mW | $0.0020 | $0.002 | $0.0020 | $0.02 | $0.0020 | $0.20 | OK | LCSC (https://www.lcsc.com/product-detail/chip-resistor-surface-mount_fojan-frc0402f3r90ts_C2933095.html)
42 | S1, S2 | 2 | EVQ-PUC02K | EVQPUC02K | C79174 | EVQPUC02K | Panasonic | SMD 4.7x4.5mm | Extended | 16744 | Tactile switch side-actuated SPST | $0.1750 | $0.35 | $0.1750 | $3.50 | $0.1222 | $24.44 | OK | LCSC (https://www.lcsc.com/product-detail/tactile-switches_panasonic-evqpuc02k_C79174.html)
43 | S3, S5 | 2 | GT-TC120A-H120-L1 | GT-TC120A-H120-L1 | C2762973 | GT-TC120A-H120-L1 | G-Switch | SMD-4P 6.2x6.2mm | Extended | 872 | Tactile switch 12mm IPX7 SPST | $0.1711 | $0.34 | $0.1711 | $3.42 | $0.1193 | $23.86 | OK | LCSC (https://www.lcsc.com/product-detail/tactile-switches_g-switch-gt-tc120a-h120-l1_C2762973.html)
44 | S4 | 1 | PEC11R-4215F-S0024 | PEC11R-4215F-S0024 | C143790 | PEC11R-4215F-S0024 | BOURNS | Through hole | Extended | 6847 | Rotary encoder 24 detent with switch | $2.3516 | $2.35 | $1.9813 | $19.81 | $1.5136 | $151.36 | OK | LCSC (https://www.lcsc.com/product-detail/rotary-encoders_bourns-pec11r-4215f-s0024_C143790.html)
45 | U1 | 1 | TPD4S480RUKR | wqfn20_40p_300x300x80_tp_170x170_n | C43131250 | TPD4S480RUKR | Texas Instruments | QFN-20 (3x3) | Extended | 2986 | USB Type-C 48V port protector | $1.6322 | $1.63 | $1.4519 | $14.52 | $1.2067 | $120.67 | OK | LCSC (https://www.lcsc.com/products/C43131250.html)
46 | U2 | 1 | TPS26750SRSMR | qfn32_40p_400x400x100_tp_280x280_mfg | C42166327 | TPS26750SRSMR | Texas Instruments | VQFN-32-EP (4x4) | Extended | 215 | USB Type-C PD controller | $3.2269 | $3.23 | $2.8680 | $28.68 | $2.4393 | $243.93 | OK | LCSC (https://www.lcsc.com/products/C42166327.html)
47 | U3 | 1 | CAT24C512YI-GT3 | JEDEC_MO-153_AA | C56096 | CAT24C512YI-GT3 | onsemi | TSSOP-8 | Extended | 5142 | EEPROM 512kbit I2C | $0.8121 | $0.81 | $0.6756 | $6.76 | $0.5392 | $53.92 | OK | LCSC (https://www.lcsc.com/product-detail/eeprom_onsemi-cat24c512yi-gt3_C56096.html)
48 | U4 | 1 | LM2765 | sot236_p95_290x160x110_n | C140270 | LM2765M6X/NOPB | Texas Instruments | SOT-23-6 | Extended | 595 | Charge pump voltage doubler 20mA | $1.1515 | $1.15 | $0.9566 | $9.57 | $0.7276 | $72.76 | OK | LCSC (https://www.lcsc.com/product-detail/charge-pumps_texas-instruments-lm2765m6x-nopb_C140270.html)
49 | U5 | 1 | 74LVC1G08SE-7 | sot353_65p_200x125x110_mo-203-aa_n | C460522 | 74LVC1G08SE-7 | Diodes Incorporated | SOT-353 | Extended | 3296 | Single 2-input AND gate | $0.0928 | $0.09 | $0.0928 | $0.93 | $0.0730 | $7.30 | OK | LCSC (https://www.lcsc.com/product-detail/logic-gates_diodes-incorporated-74lvc1g08se-7_C460522.html)
50 | U6 | 1 | LTC7004x | msop_10p_300x490x110_tp168x188_n | C690105 | LTC7004EMSE#PBF | Analog Devices | MSOP-10-EP | Extended | 0 | High side NMOS gate driver 60V | $7.7579 | $7.76 | $7.5858 | $75.86 | $7.3568 | $735.68 | OUT OF STOCK | LCSC (https://www.lcsc.com/product-detail/gate-drivers_analog-devices-ltc7004emse-pbf_C690105.html)
51 | U7 | 1 | INA228AIDGSR | vssop10_50p_300x300x110_mfg | C2887910 | INA228AIDGSR | Texas Instruments | VSSOP-10 | Extended | 4 | Current sense amp 85V 20-bit | $8.7551 | $8.76 | $7.5793 | $75.79 | $6.2622 | $626.22 | Low - under 10-board need | LCSC (https://www.lcsc.com/product-detail/current-sense-amplifiers_texas-instruments-ina228aidgsr_C2887910.html)
52 | U8 | 1 | SN74LVC1G17DBVR | sot25_95p_300x280x145_jedec_mo-178-aa_n | C7836 | SN74LVC1G17DBVR | Texas Instruments | SOT-23-5 | Extended | 7553 | Schmitt trigger buffer | $0.1888 | $0.19 | $0.1888 | $1.89 | $0.1495 | $14.95 | OK | LCSC (https://www.lcsc.com/product-detail/buffers-drivers-receivers-transceivers_texas-instruments-sn74lvc1g17dbvr_C7836.html)
53 | U9 | 1 | W25Q128JVPIQ | wson8_127p_600x500x80_tp_435x340_n | C190862 | W25Q128JVPIQ | Winbond Elec | WSON-8-EP (5x6) | Extended | 4958 | NOR flash 128Mbit SPI | $3.3634 | $3.36 | $2.9931 | $29.93 | $2.5530 | $255.30 | OK | LCSC (https://www.lcsc.com/product-detail/nor-flash_winbond-elec-w25q128jvpiq_C190862.html)
54 | U10 | 1 | RP2040 | qfn56_40p_700x700x90_tp_320x320_mfg | C2040 | RP2040 | Raspberry Pi | LQFN-56 (7x7) | Extended | 62318 | MCU dual Cortex-M0+ 133MHz | $0.9923 | $0.99 | $0.9062 | $9.06 | $0.7633 | $76.33 | OK | LCSC (https://www.lcsc.com/product-detail/microcontrollers-mcu-mpu-soc_raspberry-pi-rp2040_C2040.html)
55 | U11, U12 | 2 | LMR16006XDDCR | sot6_p95_290x180x110_n | C87080 | LMR16006XDDCR | Texas Instruments | SOT-6 | Extended | 1320 | Buck regulator 60V 600mA | $0.6448 | $1.29 | $0.5490 | $10.98 | $0.4255 | $85.10 | OK | LCSC (https://www.lcsc.com/product-detail/dc-dc-converters_texas-instruments-lmr16006xddcr_C87080.html)
56 | Y1 | 1 | ABM8-272-T3 | osccc_320x205x80_abm8 | C20625731 | ABM8-272-T3 | Abracon LLC | SMD3225-4P | Extended | 9590 | Crystal 12MHz 10pF 30ppm | $0.2955 | $0.30 | $0.2955 | $2.96 | $0.2316 | $23.16 | OK | LCSC (https://www.lcsc.com/product-detail/crystals_abracon-llc-abm8-272-t3_C20625731.html)
 | TOTAL | 209 |  |  |  |  |  |  |  |  |  |  | $58.80 |  | $522.61 |  | $4489.81
 | Notes
 | • Component data and prices come from the JLCPCB/LCSC parts API, retrieved 2026-08-23. Prices change; re-check before you order.
 | • Designators, quantities, values and footprints come from PCB_files/production/bom.csv (KiCad fabrication toolkit export, rev 1.1.0).
 | • Unit price is an INDEX/MATCH lookup into the Price Tiers tab against Qty/Bd x build size. Change the build sizes on the Summary tab and the prices follow.
 | • Prices are component cost only. PCB fabrication, assembly labour, stencil, setup fees, extended-part fees, shipping and duty are NOT included.
 | • C690105 (LTC7004EMSE#PBF) and C2887910 (INA228AIDGSR) have a minimum order quantity of 2 at LCSC.
 | • Stock Status compares live JLC stock against the quantity each build size needs.
 | • Not purchased, so not listed: 68 test points, 11 solder jumpers, 5 mounting holes, 3 fiducials, 1 net tie and connectors J2 and J7 (unpopulated). 209 placements out of 299 designators.

Sheet: Price Tiers
PD240W - LCSC volume price tiers (source for BOM unit prices)
Break quantities and unit prices as published by JLCPCB/LCSC on 2026-08-23. Short tier lists are padded by repeating the last tier so lookups stay valid. Row N here matches row N on the BOM tab.
LCSC # | Break 1 | Break 2 | Break 3 | Break 4 | Break 5 | Break 6 | Price 1 | Price 2 | Price 3 | Price 4 | Price 5 | Price 6 | Min Order
C527014 | 1 | 500 | 1500 | 10000 | 20000 | 50000 | 0.0129 | 0.0111 | 0.0101 | 0.0093 | 0.0088 | 0.0085 | 1
C5370002 | 1 | 100 | 300 | 3000 | 6000 | 9000 | 0.1064 | 0.0941 | 0.0877 | 0.0824 | 0.0806 | 0.0795 | 1
C913445 | 1 | 10 | 30 | 100 | 500 | 1000 | 0.9111 | 0.8056 | 0.7601 | 0.7032 | 0.6448 | 0.6285 | 1
C15725 | 1 | 500 | 1500 | 4000 | 24000 | 48000 | 0.0157 | 0.0120 | 0.0104 | 0.0091 | 0.0086 | 0.0083 | 1
C296710 | 1 | 500 | 1500 | 5000 | 25000 | 25000 | 0.0056 | 0.0048 | 0.0043 | 0.0041 | 0.0038 | 0.0038 | 1
C437568 | 1 | 10 | 30 | 100 | 500 | 1000 | 0.9046 | 0.7942 | 0.7406 | 0.6935 | 0.6805 | 0.6724 | 1
C5360803 | 1 | 200 | 600 | 4000 | 8000 | 20000 | 0.0270 | 0.0215 | 0.0186 | 0.0166 | 0.0151 | 0.0142 | 1
C22367838 | 1 | 10 | 30 | 100 | 500 | 1000 | 0.3557 | 0.2745 | 0.2339 | 0.1998 | 0.1901 | 0.1836 | 1
C1548 | 1 | 1000 | 3000 | 10000 | 50000 | 50000 | 0.0047 | 0.0038 | 0.0033 | 0.0029 | 0.0026 | 0.0026 | 1
C309062 | 1 | 10 | 30 | 100 | 500 | 1000 | 0.3703 | 0.2979 | 0.2627 | 0.2311 | 0.2225 | 0.1824 | 1
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
C7836 | 1 | 50 | 150 | 500 | 3000 | 6000 | 0.1888 | 0.1495 | 0.1305 | 0.1134 | 0.1087 | 0.1058 | 1
C190862 | 1 | 10 | 30 | 100 | 500 | 1000 | 3.3634 | 2.9931 | 2.8047 | 2.5530 | 2.1908 | 2.1519 | 1
C2040 | 1 | 10 | 30 | 100 | 500 | 1000 | 0.9923 | 0.9062 | 0.8234 | 0.7633 | 0.7373 | 0.7244 | 1
C87080 | 1 | 10 | 30 | 100 | 500 | 1000 | 0.6448 | 0.5490 | 0.4824 | 0.4255 | 0.4077 | 0.3979 | 1
C20625731 | 1 | 50 | 150 | 500 | 3000 | 6000 | 0.2955 | 0.2316 | 0.2042 | 0.1701 | 0.1548 | 0.1457 | 1
