RileyCornelius/PD240W/3D_models/solidworks/STEP/casing_bottom.step

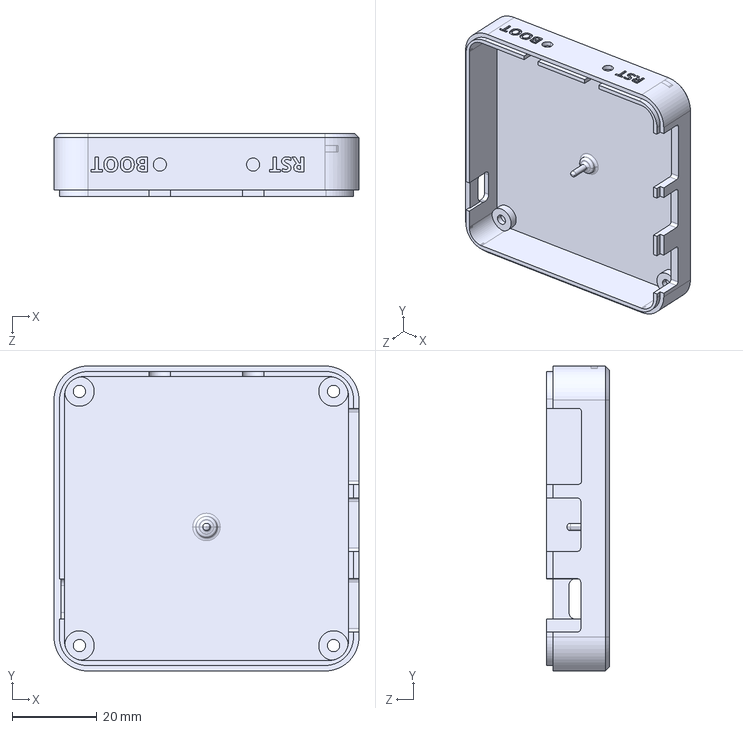
[picture p6: CAD file, 2026-10-28]
3D_models/solidworks/STEP/casing_bottom.step
72.0 x 72.0 x 14.9 mm
