RileyCornelius/PD240W/mechanical/solidworks/STEP/button.step

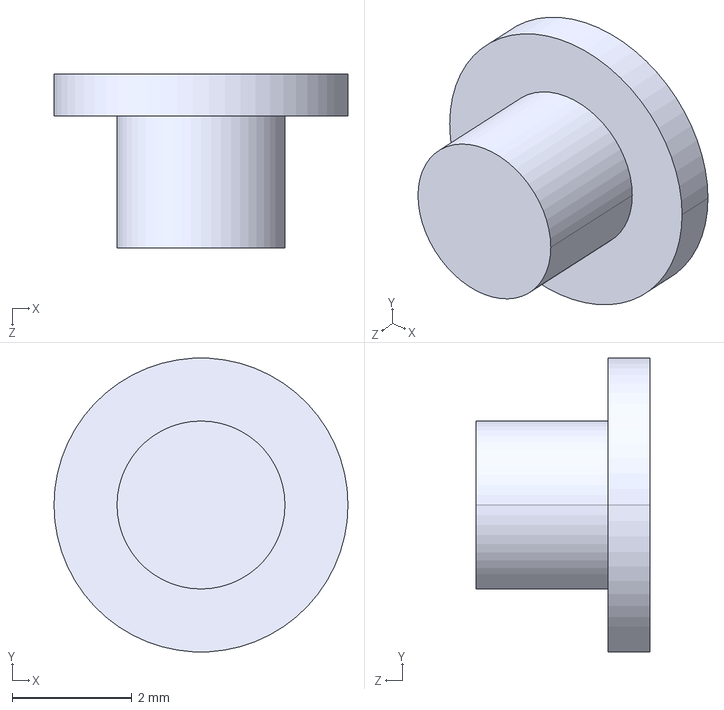
[picture p7: CAD file, 2026-10-28]
mechanical/solidworks/STEP/button.step
4.90 x 4.89 x 2.90 mm
