RileyCornelius/PD240W/3D_models/solidworks/STEP/PD240W_PCB.step

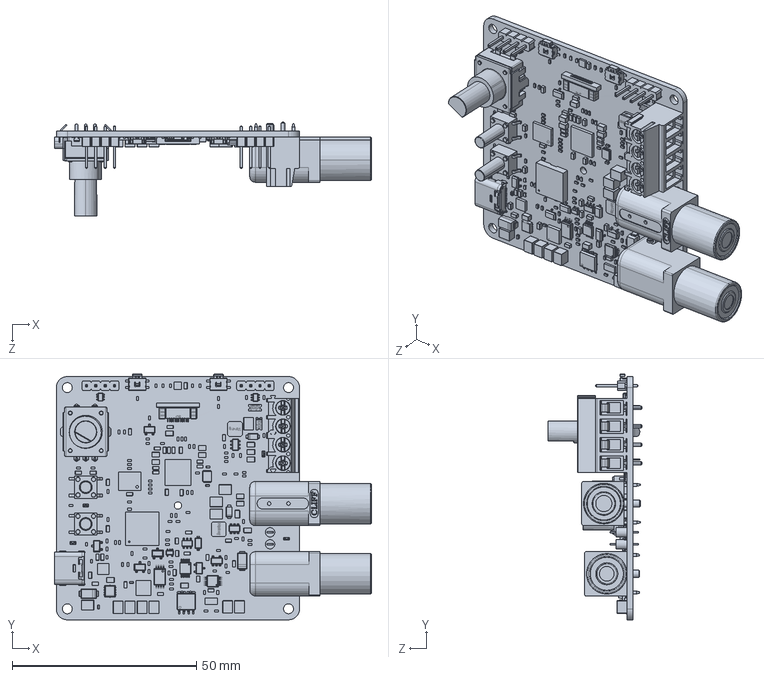
[picture p8: CAD file, 2026-10-28]
3D_models/solidworks/STEP/PD240W_PCB.step
86.0 x 66.7 x 25.6 mm
