RileyCornelius/PD240W/mechanical/solidworks/STEP/knob.step

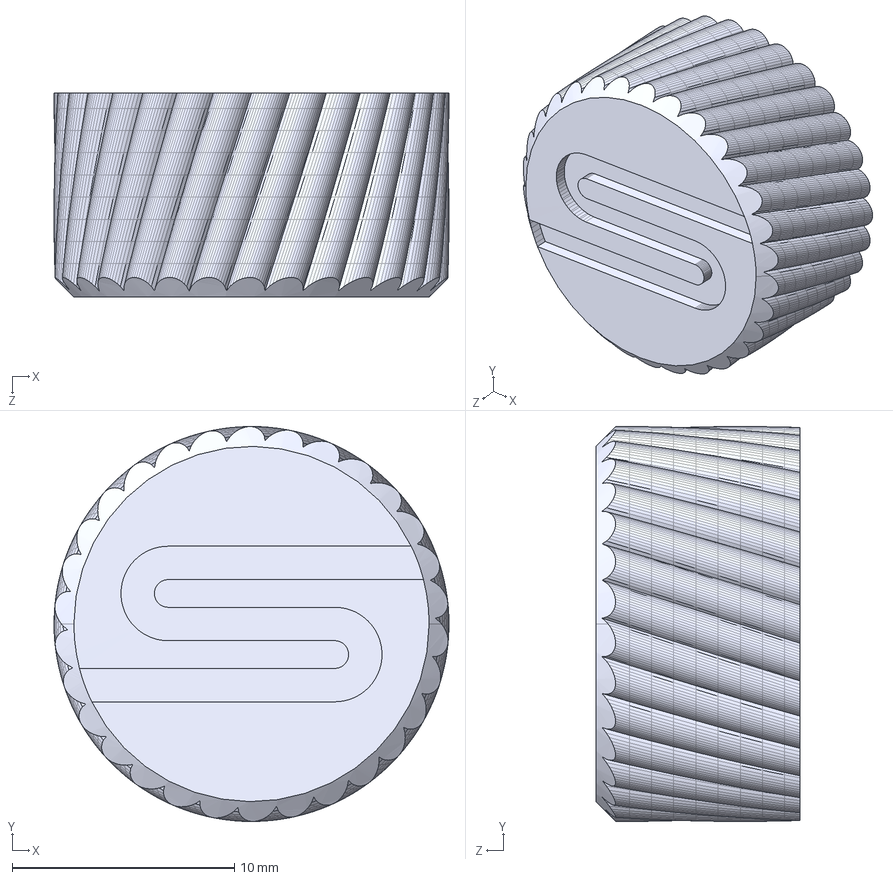
[picture p9: CAD file, 2026-10-28]
mechanical/solidworks/STEP/knob.step
17.8 x 17.8 x 9.21 mm
