RileyCornelius/PD240W/3D_models/case/PD240W_case_base.step

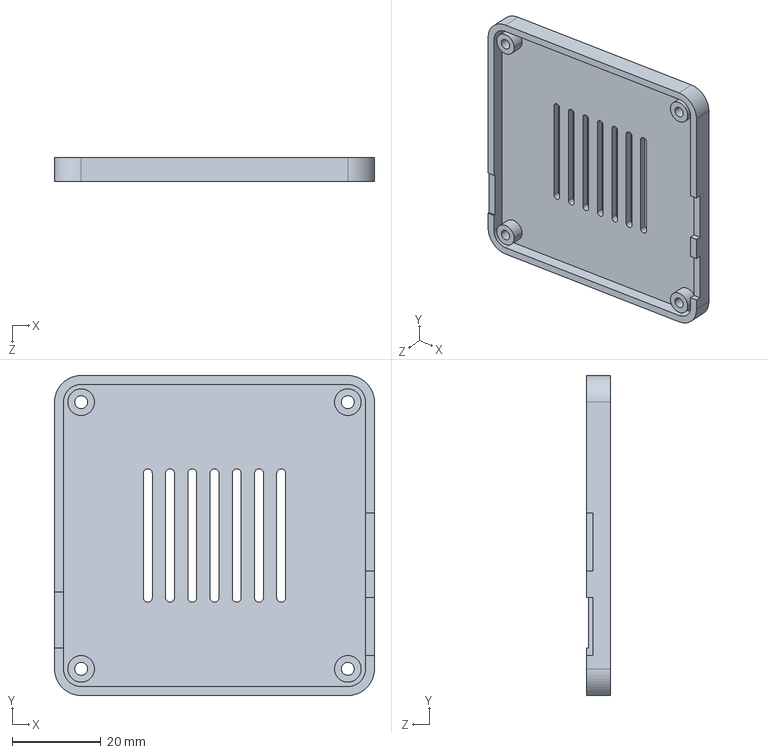
[picture p10: CAD file, 2026-10-27]
3D_models/case/PD240W_case_base.step
72.0 x 72.0 x 5.50 mm
