RileyCornelius/PD240W/3D_models/solidworks/STEP/lcd_support.step

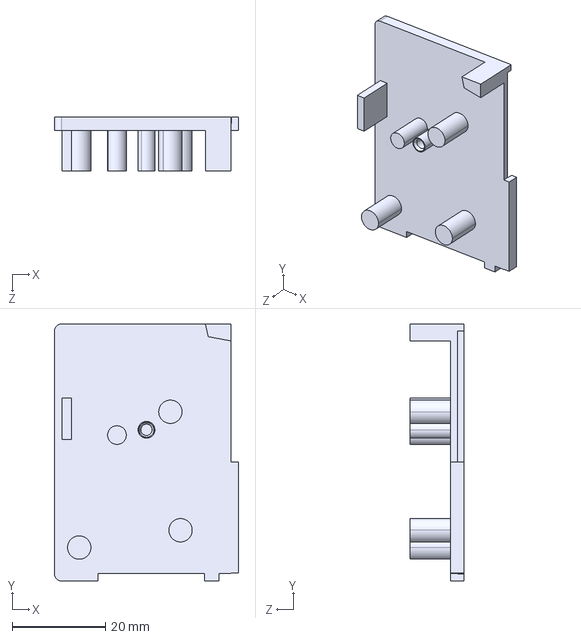
[picture p11: CAD file, 2026-10-28]
3D_models/solidworks/STEP/lcd_support.step
39.4 x 55.0 x 11.4 mm
