RileyCornelius/PD240W/mechanical/solidworks/STEP/casing_top.step

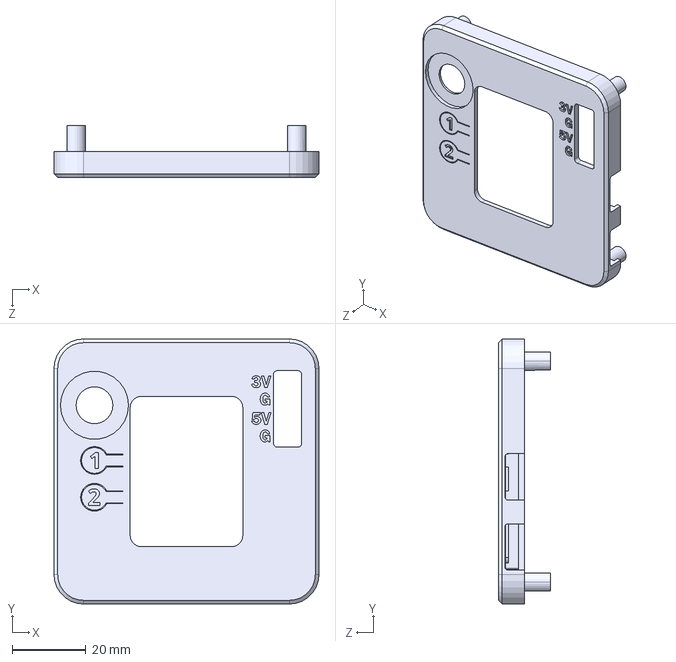
[picture p12: CAD file, 2026-10-28]
mechanical/solidworks/STEP/casing_top.step
72.0 x 72.0 x 14.2 mm
