RileyCornelius/PD240W/3D_models/case/PD240W_case_lid.step

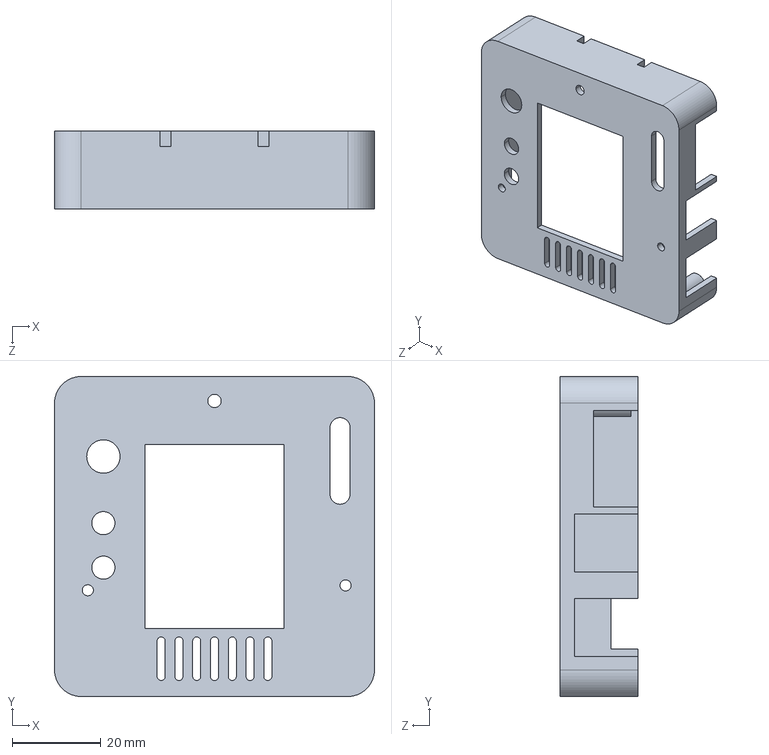
[picture p13: CAD file, 2026-10-27]
3D_models/case/PD240W_case_lid.step
72.0 x 72.0 x 17.6 mm
