RileyCornelius/PD240W/3D_models/solidworks/STEP/swd_cover.step

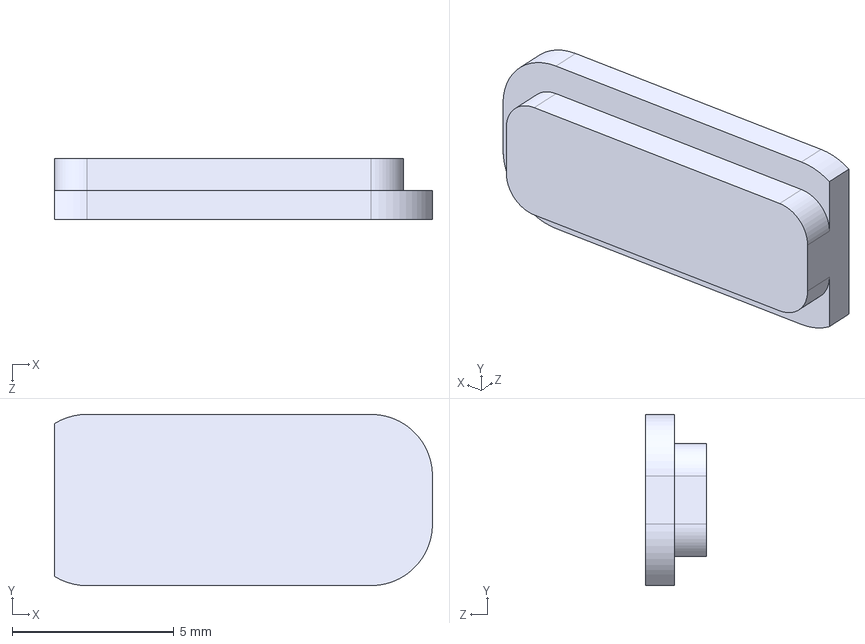
[picture p14: CAD file, 2026-10-28]
3D_models/solidworks/STEP/swd_cover.step
11.7 x 5.30 x 1.90 mm
