RileyCornelius/PD240W/3D_models/case/PD240W_PCB.SLDPRT

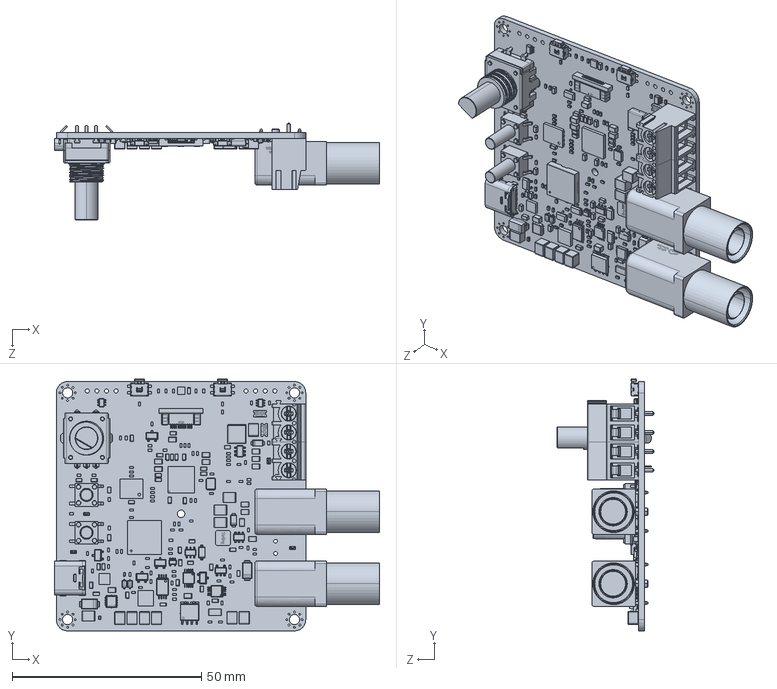
[picture p15: CAD file, 2026-10-27]
3D_models/case/PD240W_PCB.SLDPRT
86.0 x 66.7 x 25.6 mm
