RileyCornelius/PD240W/3D_models/solidworks/Assm_PD240W_Enclosure.SLDASM

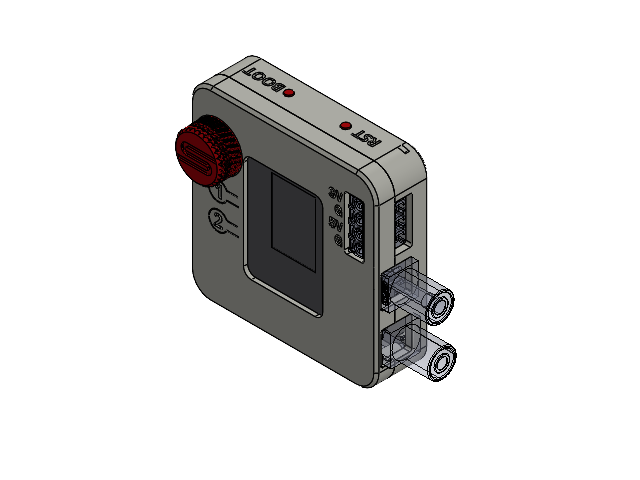
[picture p16: CAD file, 2026-10-28]
3D_models/solidworks/Assm_PD240W_Enclosure.SLDASM
casing_bottom
PD240W_PCB
lcd_support
casing_top
knob
button x 2
