RileyCornelius/PD240W/(list of files, cad)

Other CAD files:
3D_models/case/PD240W_case_assembly.step
3D_models/solidworks/button.SLDPRT
3D_models/case/PD240W_button_cap.SLDPRT
3D_models/case/PD240W_button_cap.STL
3D_models/case/PD240W_case_assembly.SLDASM
3D_models/case/PD240W_case_base.SLDPRT
3D_models/case/PD240W_case_base.STL
3D_models/case/PD240W_case_lid.SLDPRT
3D_models/case/PD240W_case_lid.STL
3D_models/solidworks/PD240W_PCB.SLDPRT
3D_models/solidworks/casing_bottom.SLDPRT
3D_models/solidworks/lcd_support.SLDPRT
3D_models/solidworks/swd_cover.SLDPRT
mechanical/solidworks/casing_top.SLDPRT
mechanical/solidworks/knob.SLDPRT
