RileyCornelius/PD240W/hardware/Manufacturing/Fabrication/PD240W_kicad-fabrication.pdf

# Top Fabrication (Scale 1:1)

# PD240W Fabrication Document

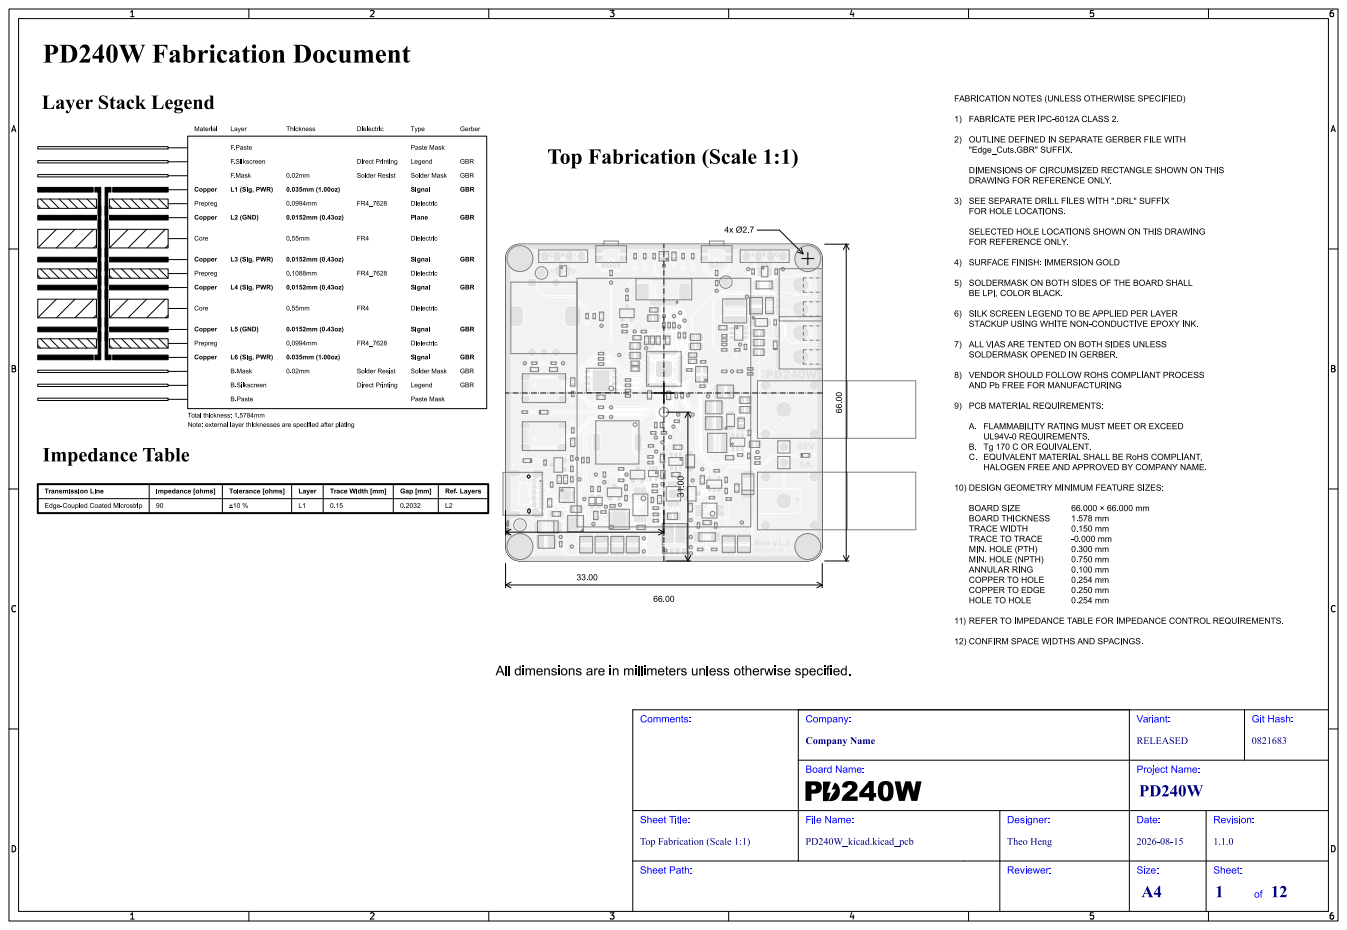
[picture p17: page 1]
Git Hash:; Comments:; Sheet Path:; Sheet Title:; File Name:; Company Name; Company:; RELEASED; Variant:; Board Name:; PD240W_kicad.kicad_pcb; Theo Heng; Designer:; Reviewer:; Project Name:; Date:; Revision:; Size:; Sheet:; 6 PCB EDGE

Top Fabrication (Scale 1:1)

# Bottom Fabrication (Scale 1:1)

# PD240W Fabrication Document

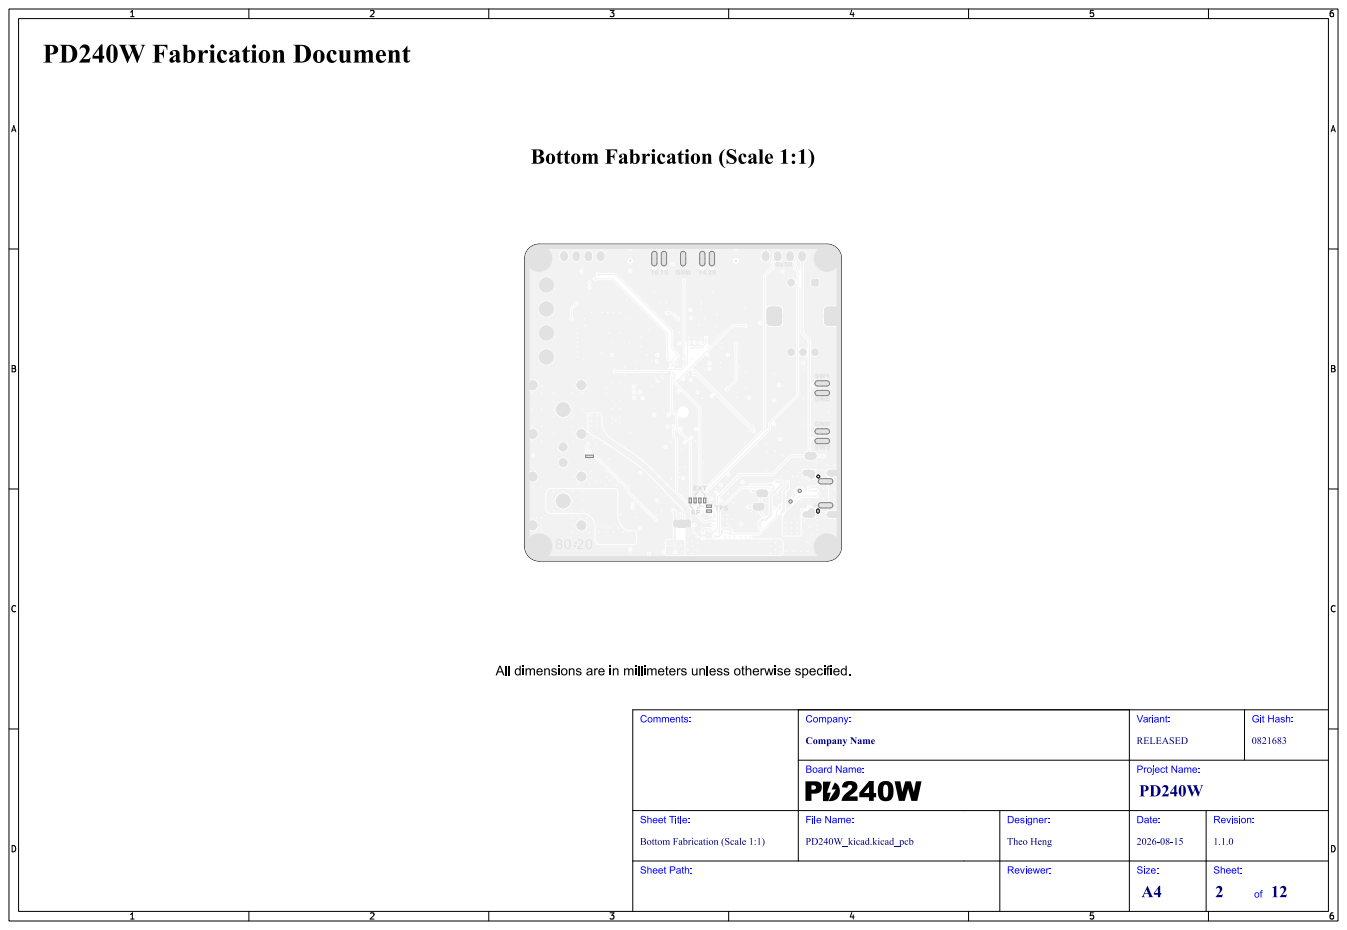
[picture p18: page 2]
Git; Hash:; Comments:; Sheet Path:; Sheet Title:; File Name:; Company Name; Company:; RELEASED; Variant:; Board Name:; PD240W_kicad.kicad_pcb; Theo Heng; Designer:; Reviewer:; Project Name:; Date:; Revision:; Size:; Sheet:

Bottom Fabrication (Scale 1:1)

# Drill Drawing L1 - L6 (Scale 1:1)

# PD240W Fabrication Document

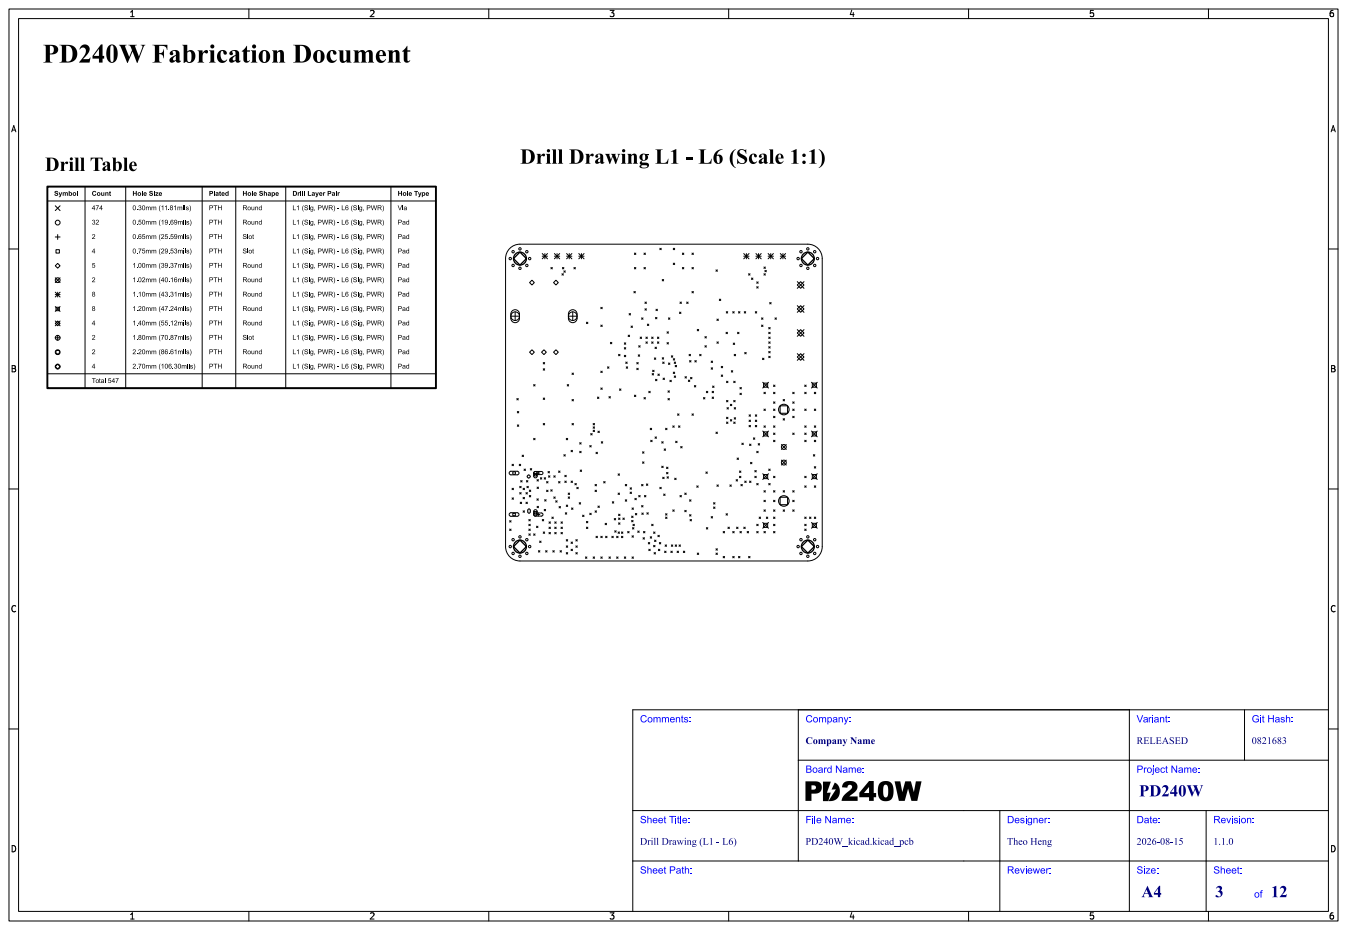
[picture p19: page 3]
Git; Hash:; Comments:; Drill Drawing (L1 - L6); Sheet Path:; Sheet Title:; File Name:; Company Name; Company:; RELEASED; Variant:; Board Name:; PD240W_kicad.kicad_pcb; Theo Heng; Designer:; Reviewer:; Project Name:; Date:; Revision:; Size:; Sheet:

# Drill Drawing L1 - L6 (Scale 1:1)

# PD240W Fabrication Document

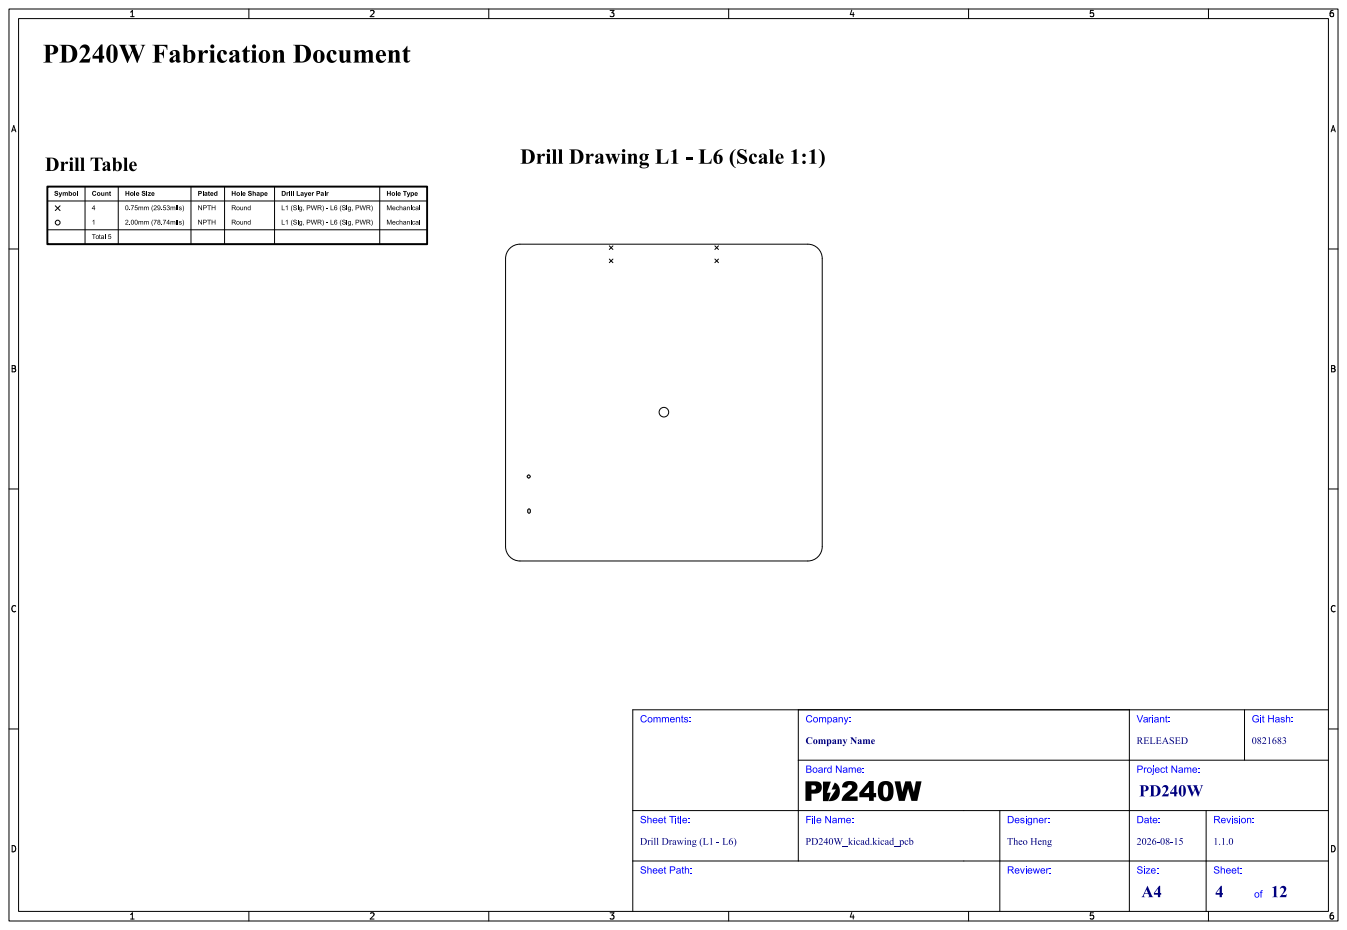
[picture p20: page 4]
Git; Hash:; Comments:; Drill Drawing (L1 - L6); Sheet Path:; Sheet Title:; File Name:; Company Name; Company:; RELEASED; Variant:; Board Name:; PD240W_kicad.kicad_pcb; Theo Heng; Designer:; Reviewer:; Project Name:; Date:; Revision:; Size:; Sheet:

# Top Test Points (Scale 1:1)

# PD240W Fabrication Document

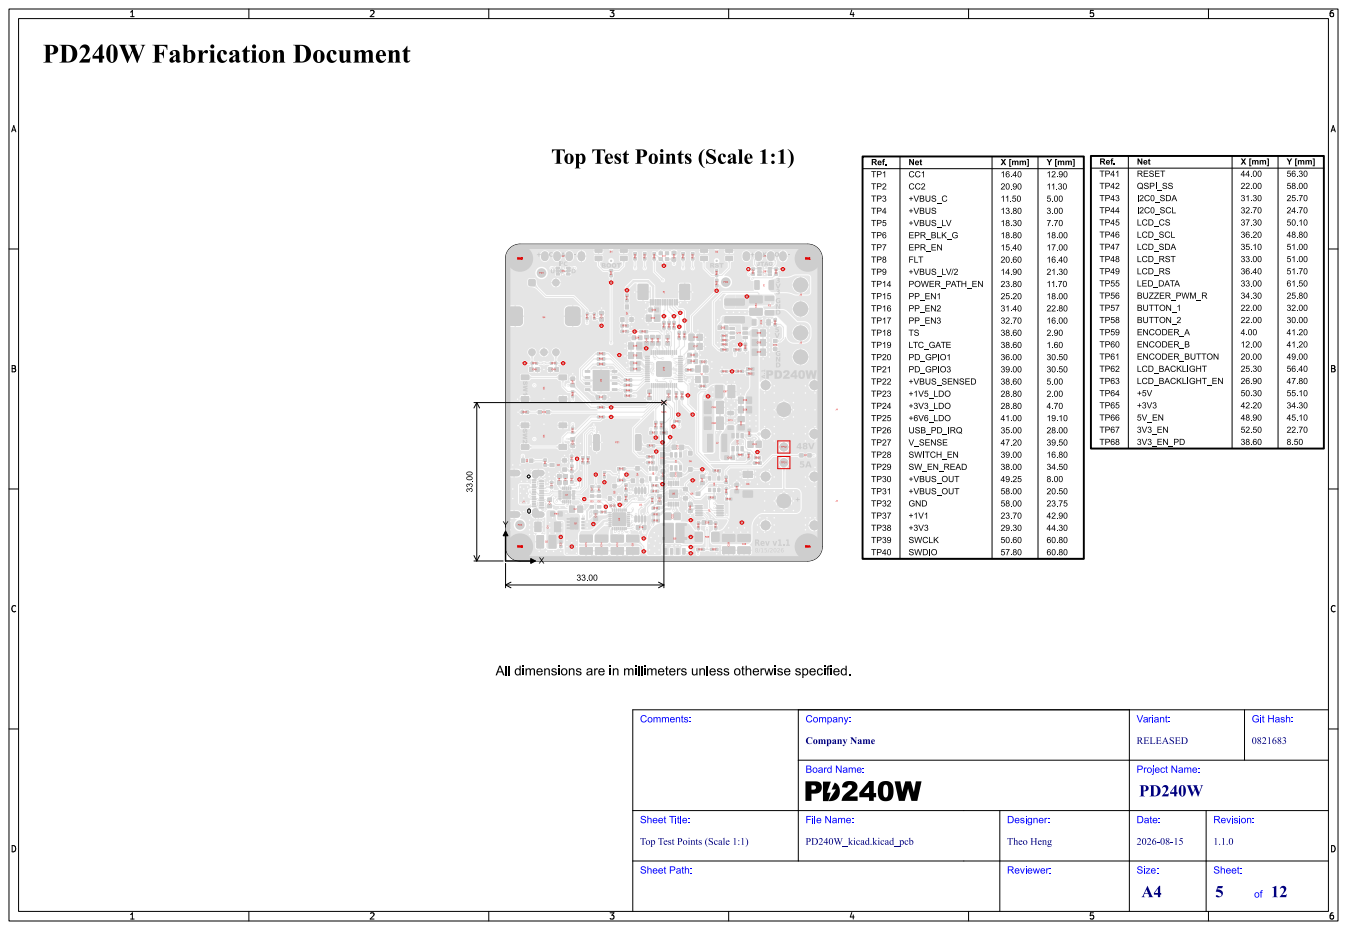
[picture p21: page 5]
Git Hash:; Comments:; Sheet Path:; Sheet Title:; File Name:; Company Name; Company:; RELEASED; Variant:; Board Name:; PD240W_kicad.kicad_pcb; Theo Heng; Designer:; Reviewer:; Project Name:; Date:; Revision:; Size:; Sheet:

Top Test Points (Scale 1:1)

# Bottom Test Points (Scale 1:1)

# PD240W Fabrication Document

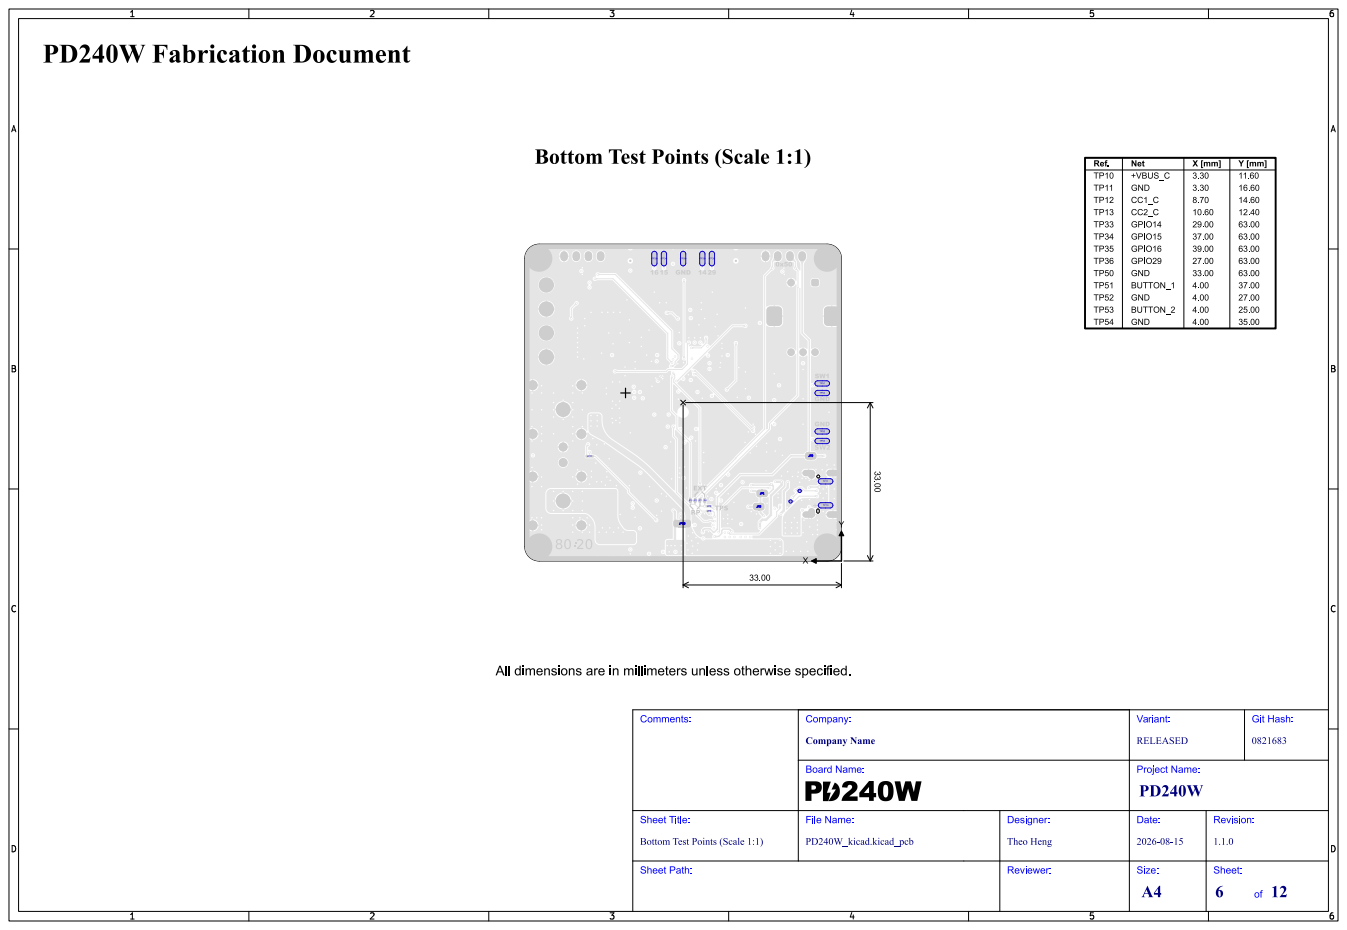
[picture p22: page 6]
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

Bottom Test Points (Scale 1:1)

# L1 (Sig, PWR) (Scale 1:1)

# PD240W Fabrication Document

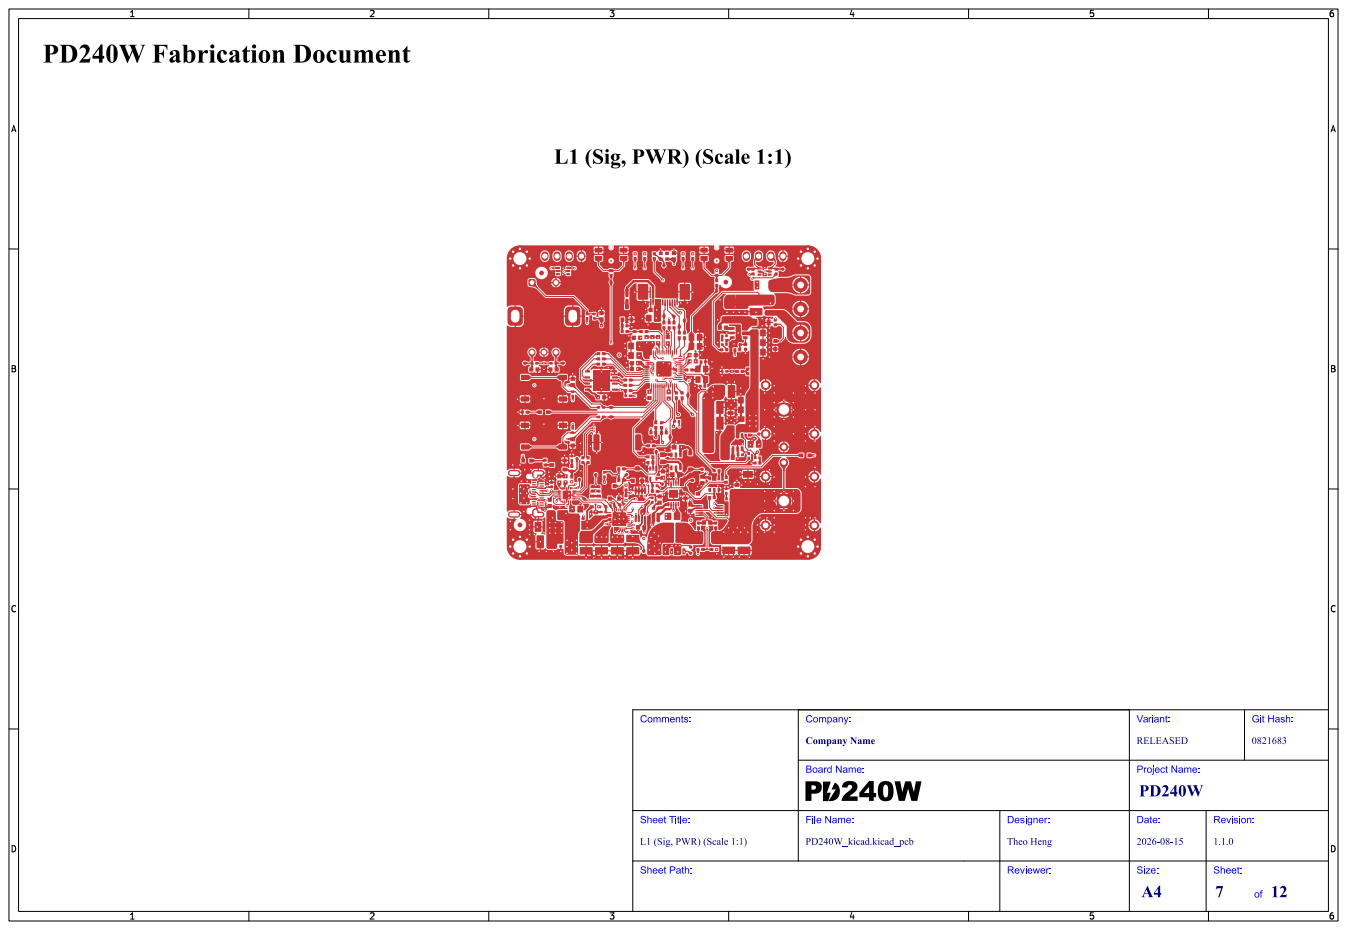
[picture p23: page 7]
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

L1 (Sig, PWR) (Scale 1:1)

# L2 (GND) (Scale 1:1)

# PD240W Fabrication Document

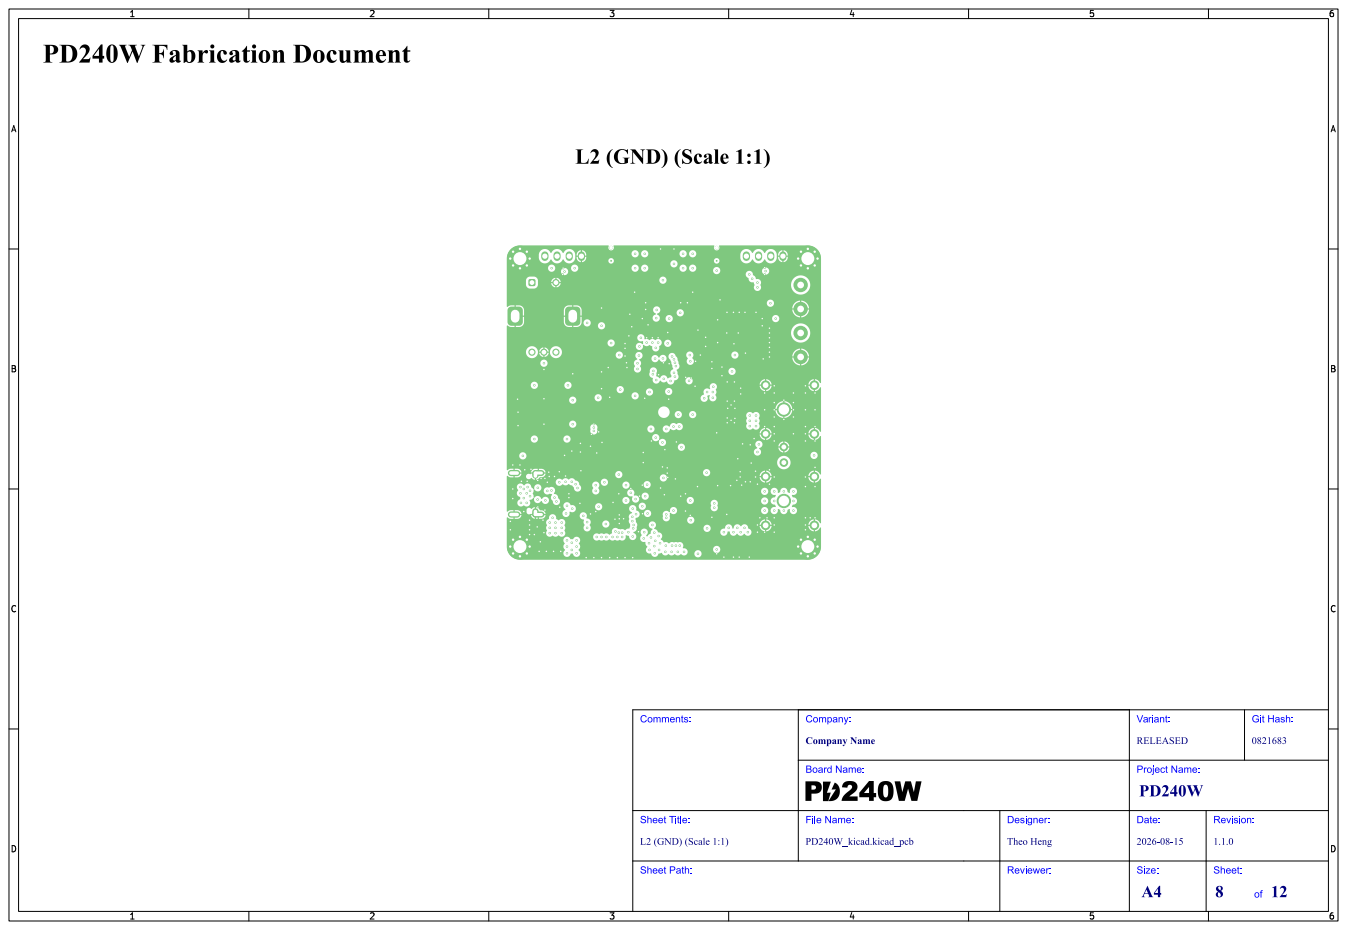
[picture p24: page 8]
Git; Hash:; Comments:; L2 (GND) (Scale 1:1); Sheet Path:; Sheet Title:; File Name:; Company Name; Company:; RELEASED; Variant:; Board Name:; PD240W_kicad.kicad_pcb; Theo Heng; Designer:; Reviewer:; Project Name:; Date:; Revision:; Size:; Sheet:

# L3 (Sig, PWR) (Scale 1:1)

# PD240W Fabrication Document

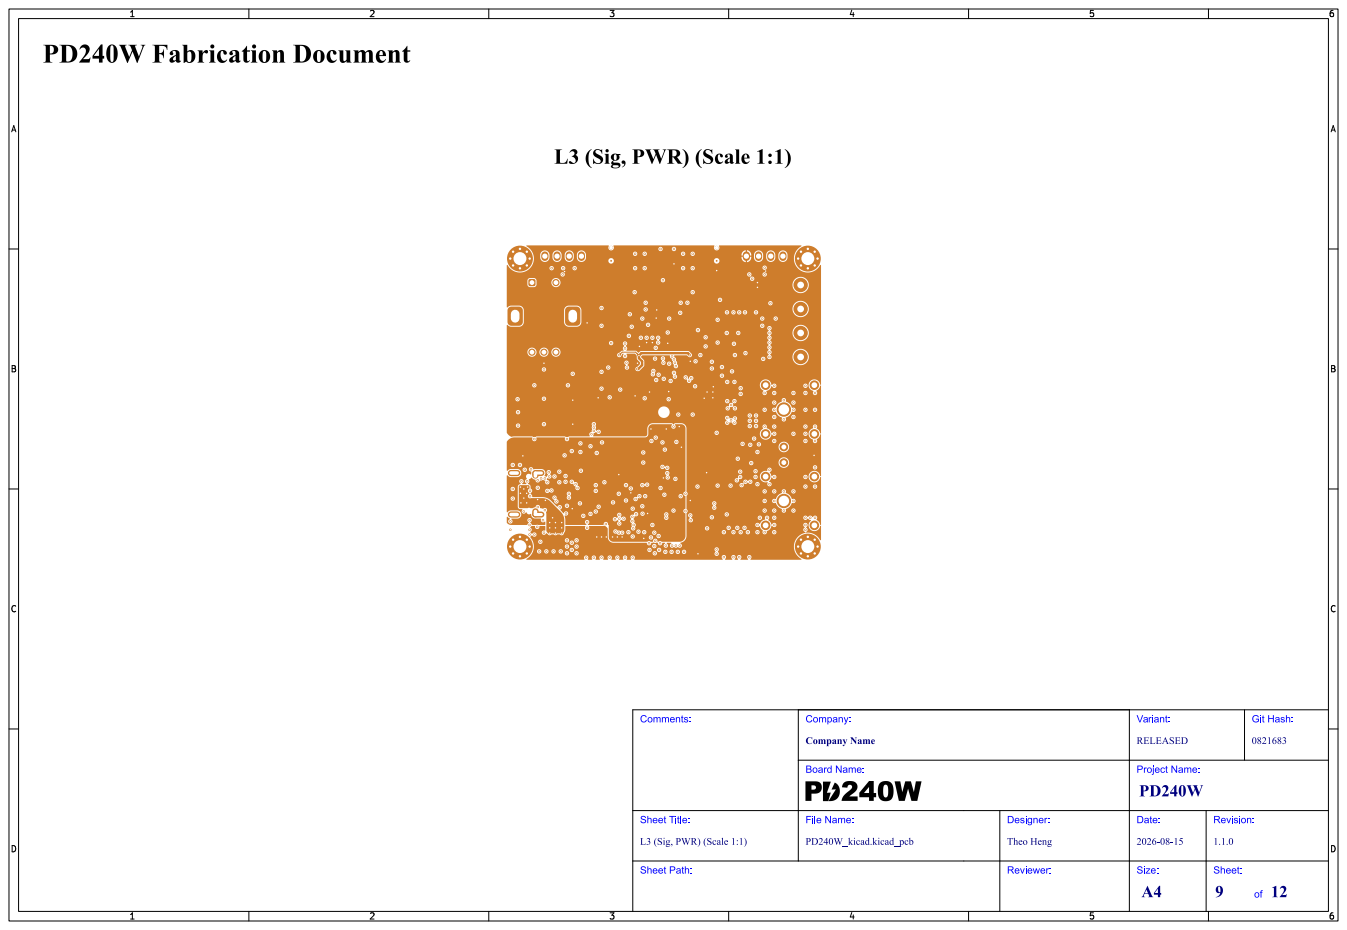
[picture p25: page 9]
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

L3 (Sig, PWR) (Scale 1:1)

# L4 (Sig, PWR) (Scale 1:1)

# PD240W Fabrication Document

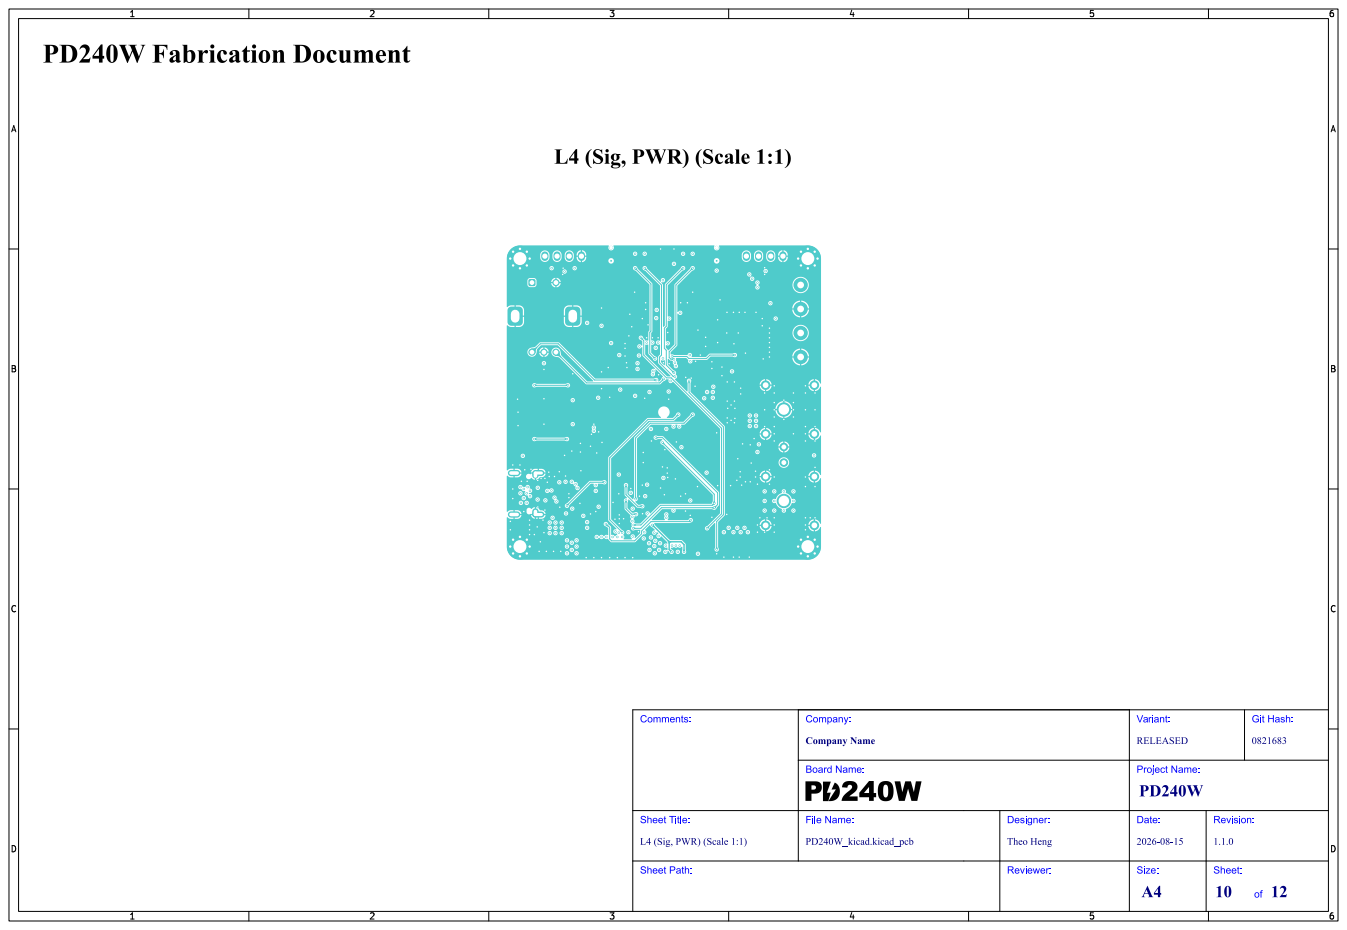
[picture p26: page 10]
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

L4 (Sig, PWR) (Scale 1:1)

# L5 (GND) (Scale 1:1)

# PD240W Fabrication Document

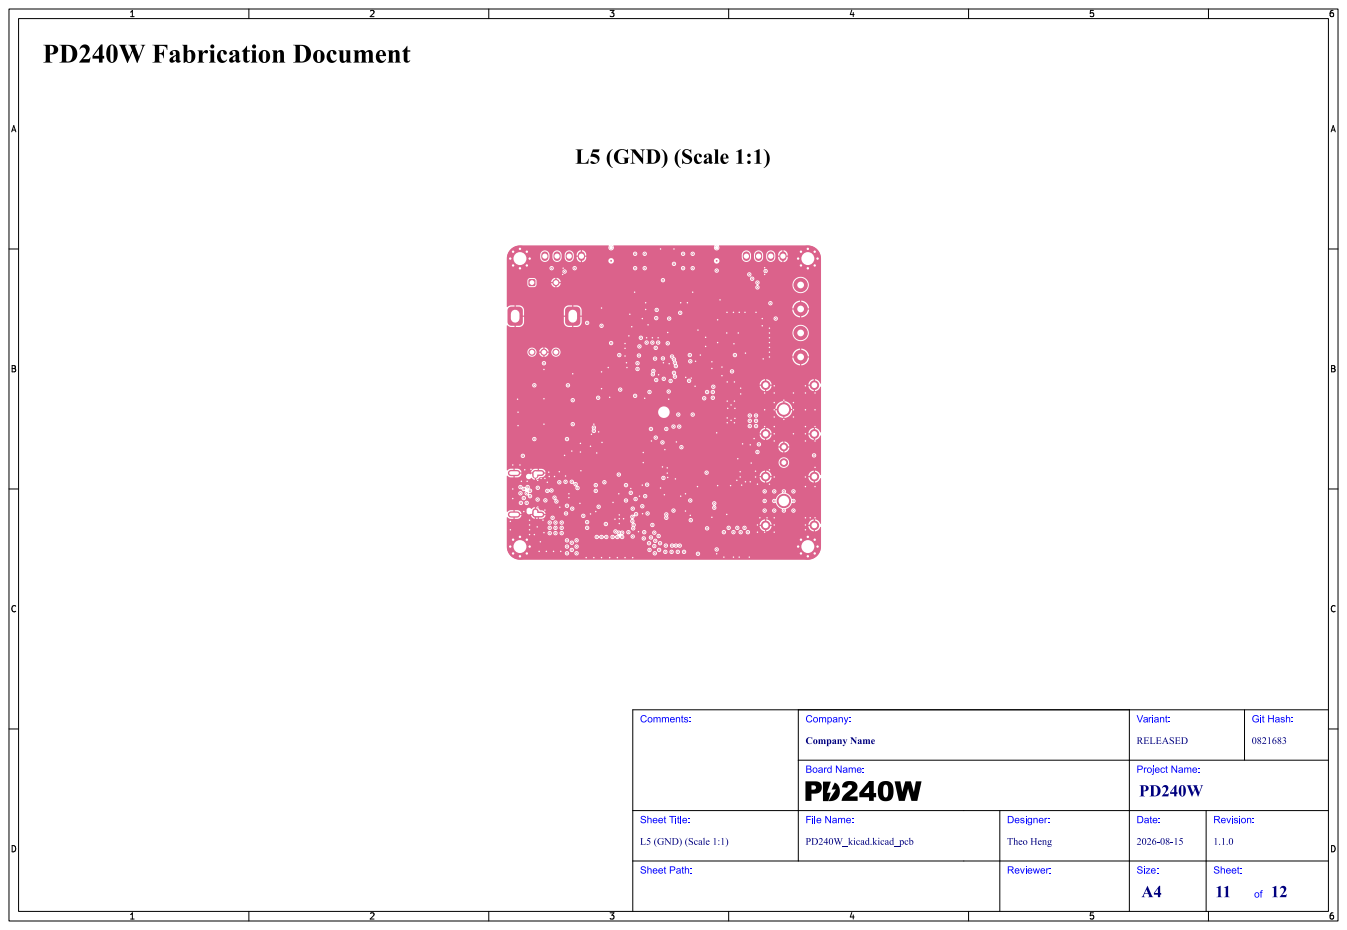
[picture p27: page 11]
Git; Hash:; Comments:; L5 (GND) (Scale 1:1); Sheet Path:; Sheet Title:; File Name:; Company Name; Company:; RELEASED; Variant:; Board Name:; PD240W_kicad.kicad_pcb; Theo Heng; Designer:; Reviewer:; Project Name:; Date:; Revision:; Size:; Sheet:

# L6 (Sig, PWR) (Scale 1:1)

# PD240W Fabrication Document

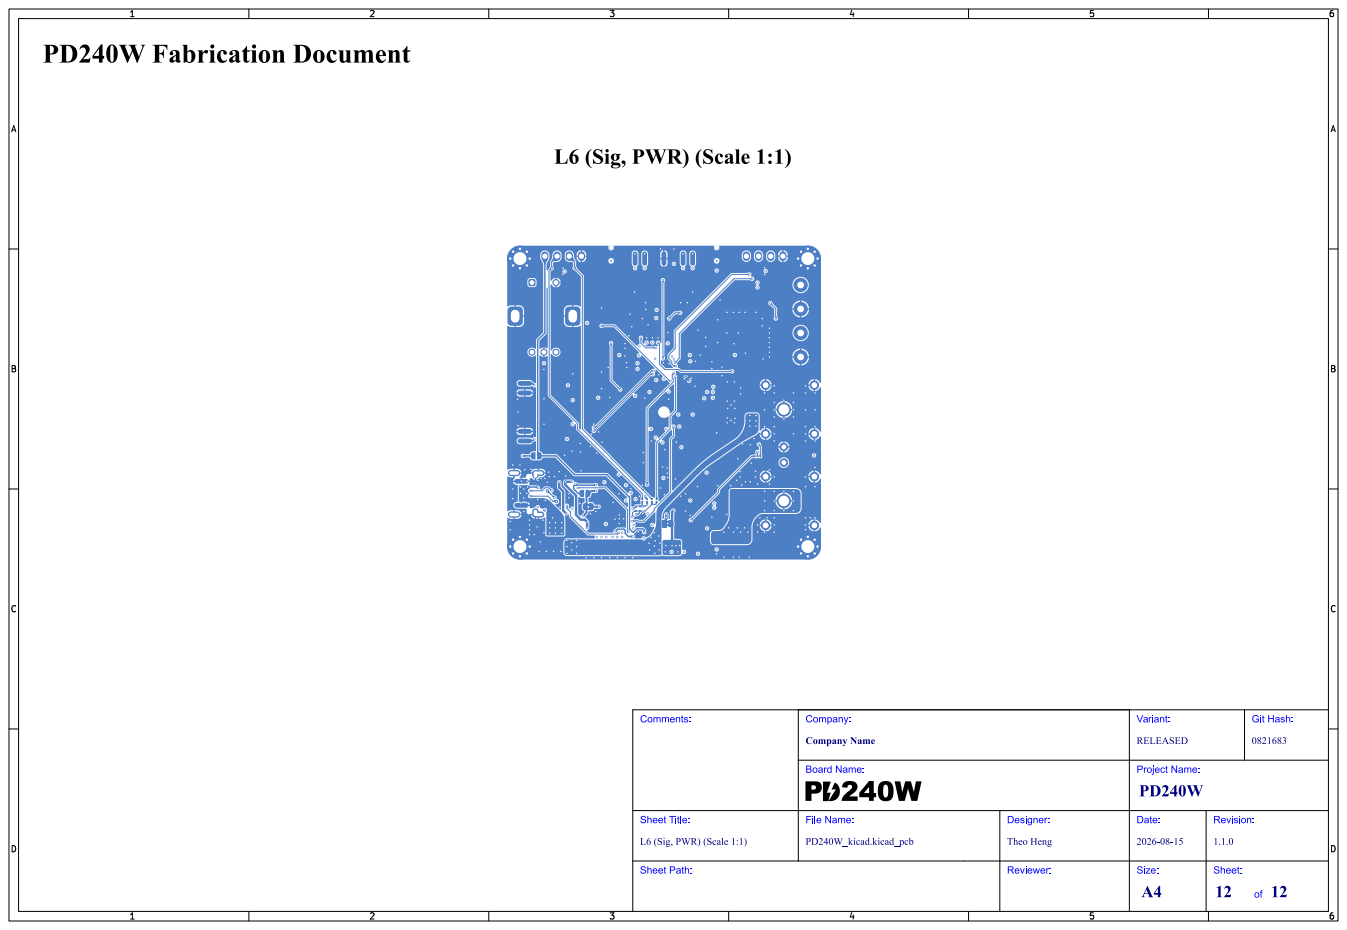
[picture p28: page 12]
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

L6 (Sig, PWR) (Scale 1:1)
