RileyCornelius/PD240W/hardware/Manufacturing/Fabrication/Drill Tables/PD240W_kicad-(L1-L6)_NPTH_drill_table.csv

Count | Hole Size | Plated | Hole Shape | Drill Layer Pair | Hole Type
4 | 0.75mm (29.53mils) | NPTH | Round | L1 (Sig, PWR) - L6 (Sig, PWR) | Mechanical
1 | 2.00mm (78.74mils) | NPTH | Round | L1 (Sig, PWR) - L6 (Sig, PWR) | Mechanical
Total 5
