RileyCornelius/PD240W/hardware/CHANGELOG.md

# Changelog

Hardware revisions of the PD240W board. KiBot reads this file to fill in the Revision History sheet.

## [1.1.0] - 2026-08-15

### Changed

-   Auxiliary buck regulator output changed from 17V to 5V: new feedback divider, 33µH inductor, 22µF 25V output capacitor
-   JLCPCB production files and footprint rotation offsets added

### Known Issues

-   USB D+/D- lines are still swapped and need the bodge described in the README

## [1.0.0] - 2026-03-15

### Added

-   Original release by Théo Heng (theohg/PD240W)
