RileyCornelius/PD240W/hardware/Schematic/PD240W-schematic_1.1.0.pdf

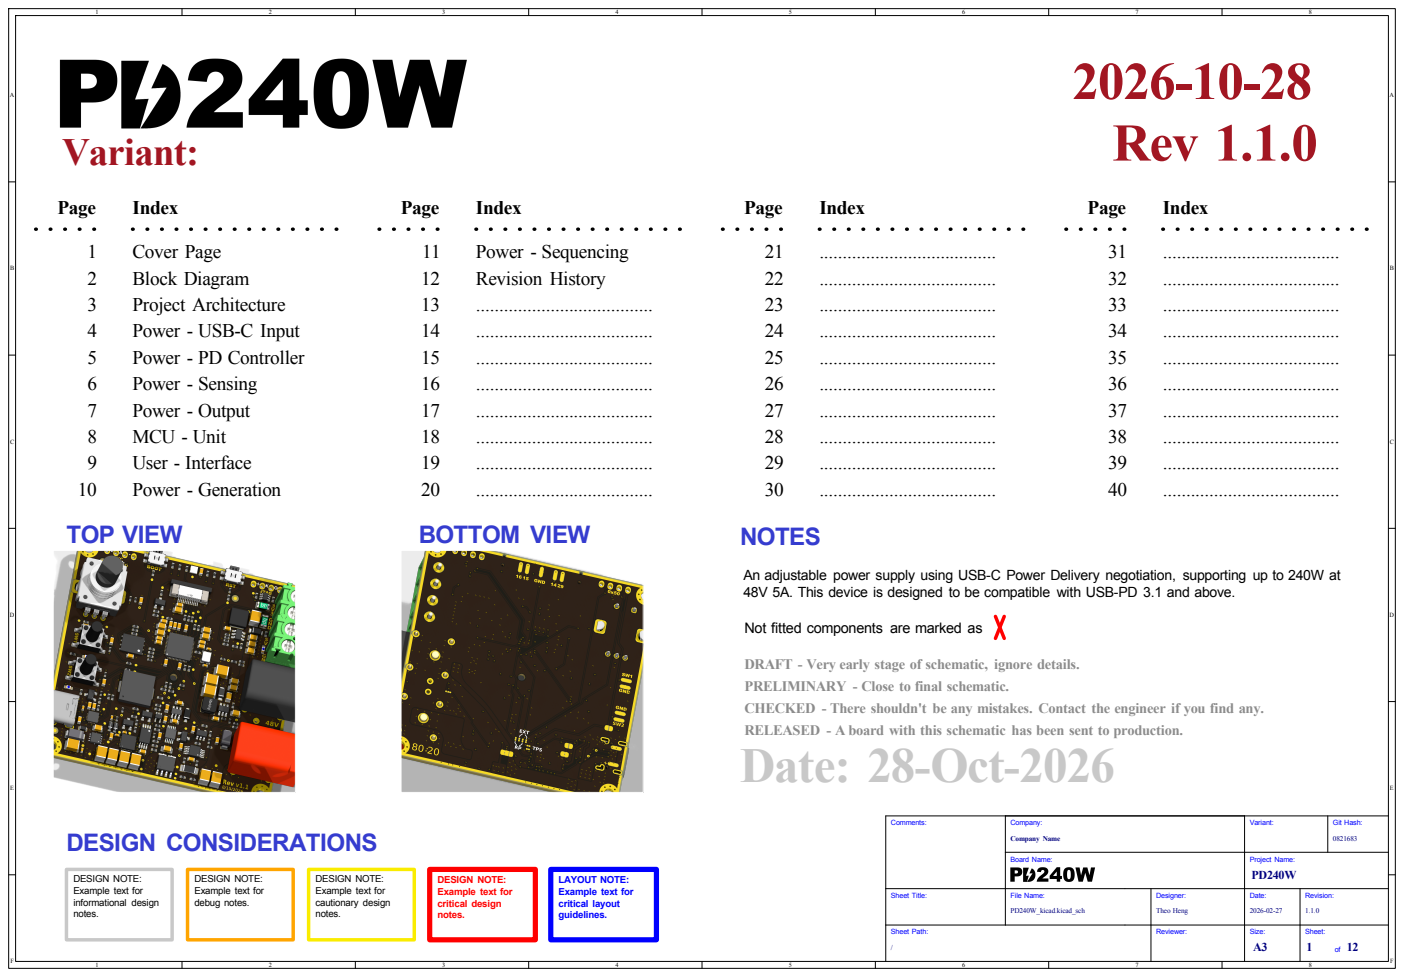
[picture p29: page 1]

...................................... CHECKED - There shouldn't be any mistakes. Contact the engineer if you find any.

48V 5A. This device is designed to be compatible with USB-PD 3.1 and above.

Not fitted components are marked as

DRAFT - Very early stage of schematic, ignore details.
PRELIMINARY - Close to final schematic.
Date: 28-Oct-2026

RELEASED - A board with this schematic has been sent to production.

Revision: 1.1.0 Date: Project Name: 2026-02-27 Reviewer: Designer:

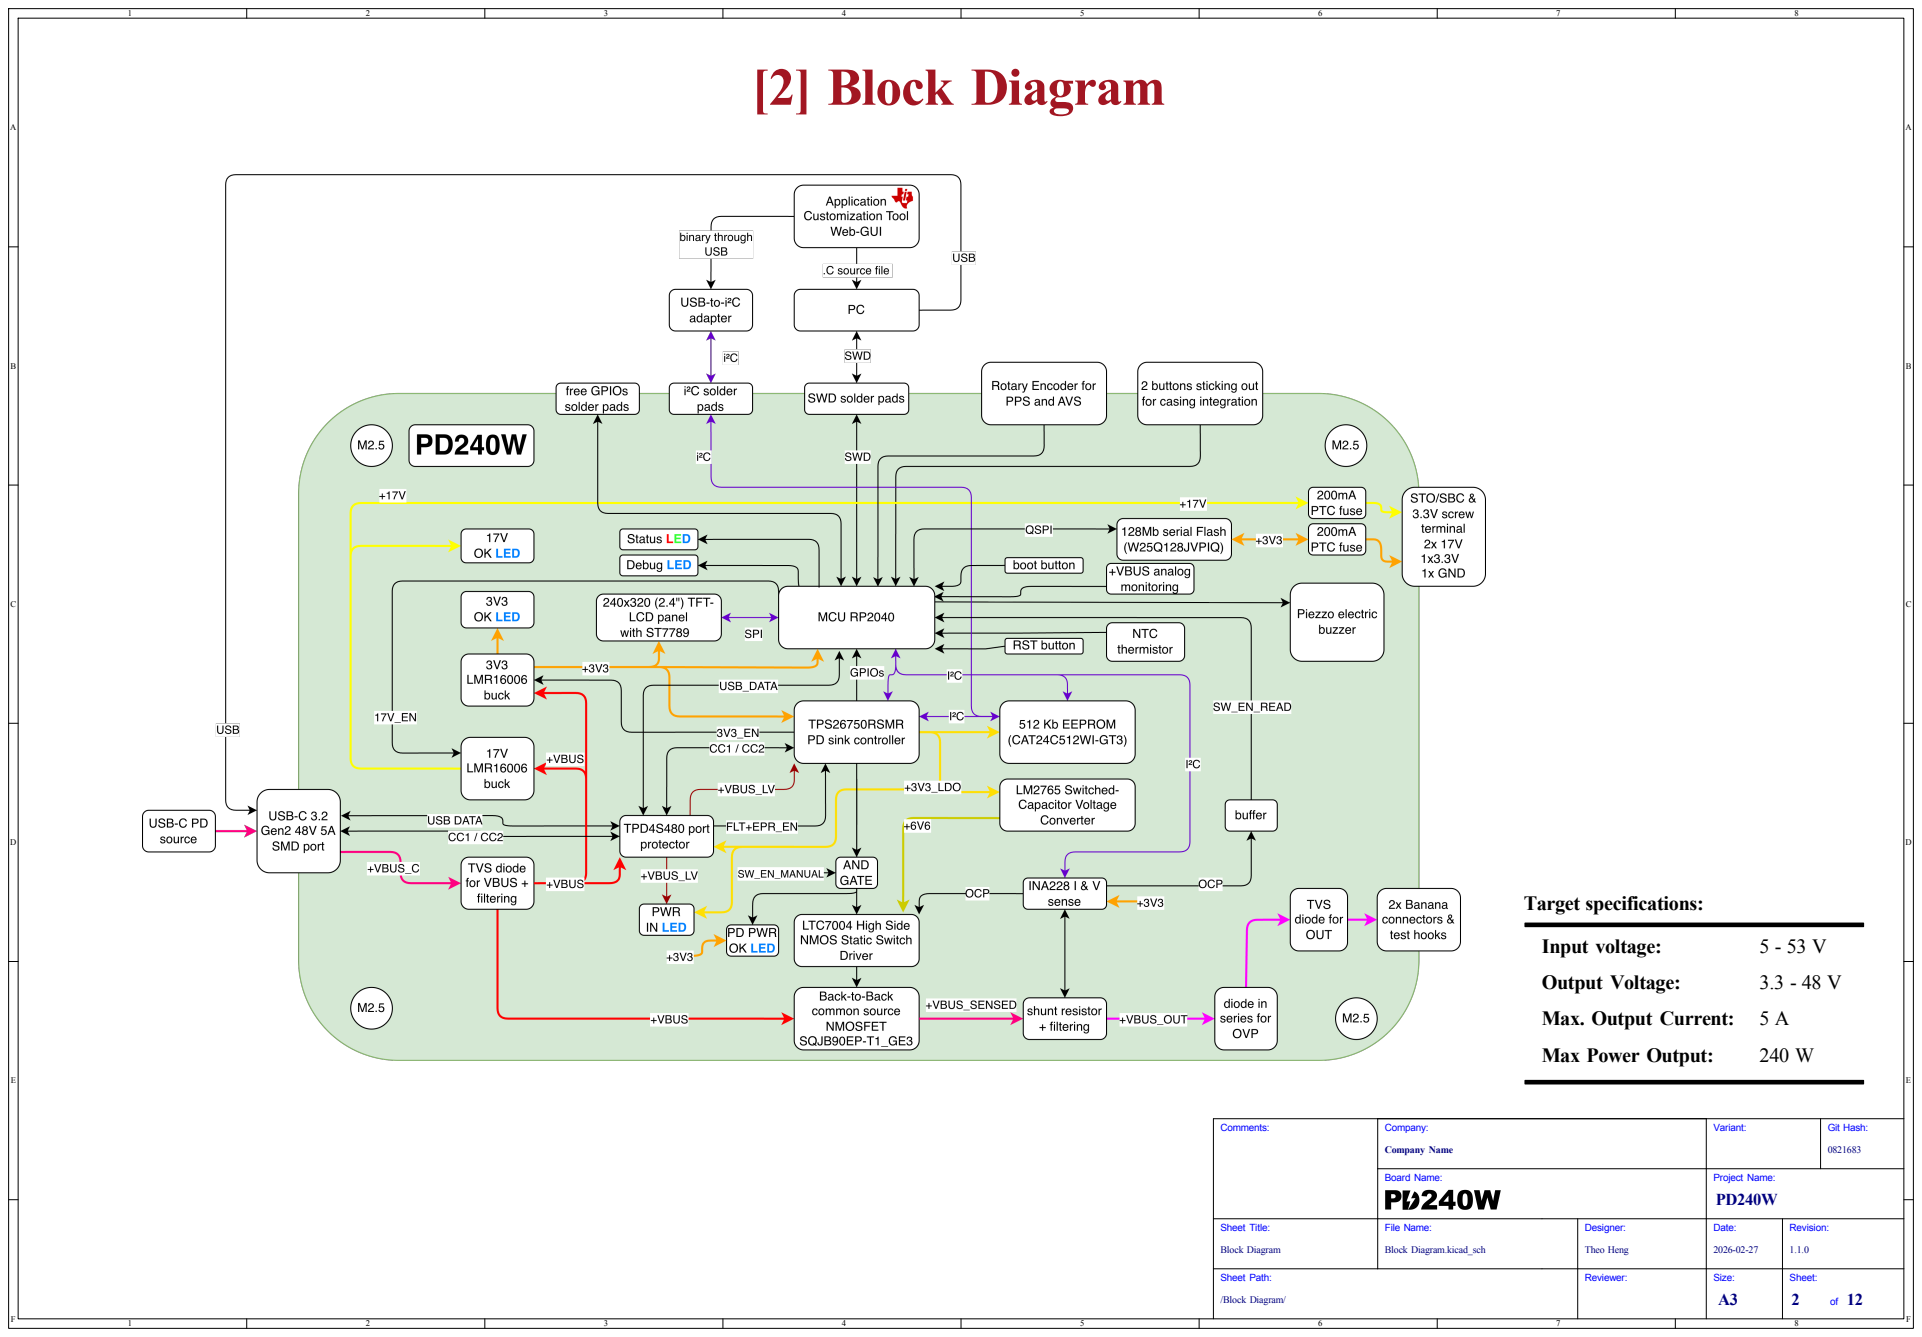
[picture p30: page 2]

/Block Diagram/ Sheet Path: Block Diagram

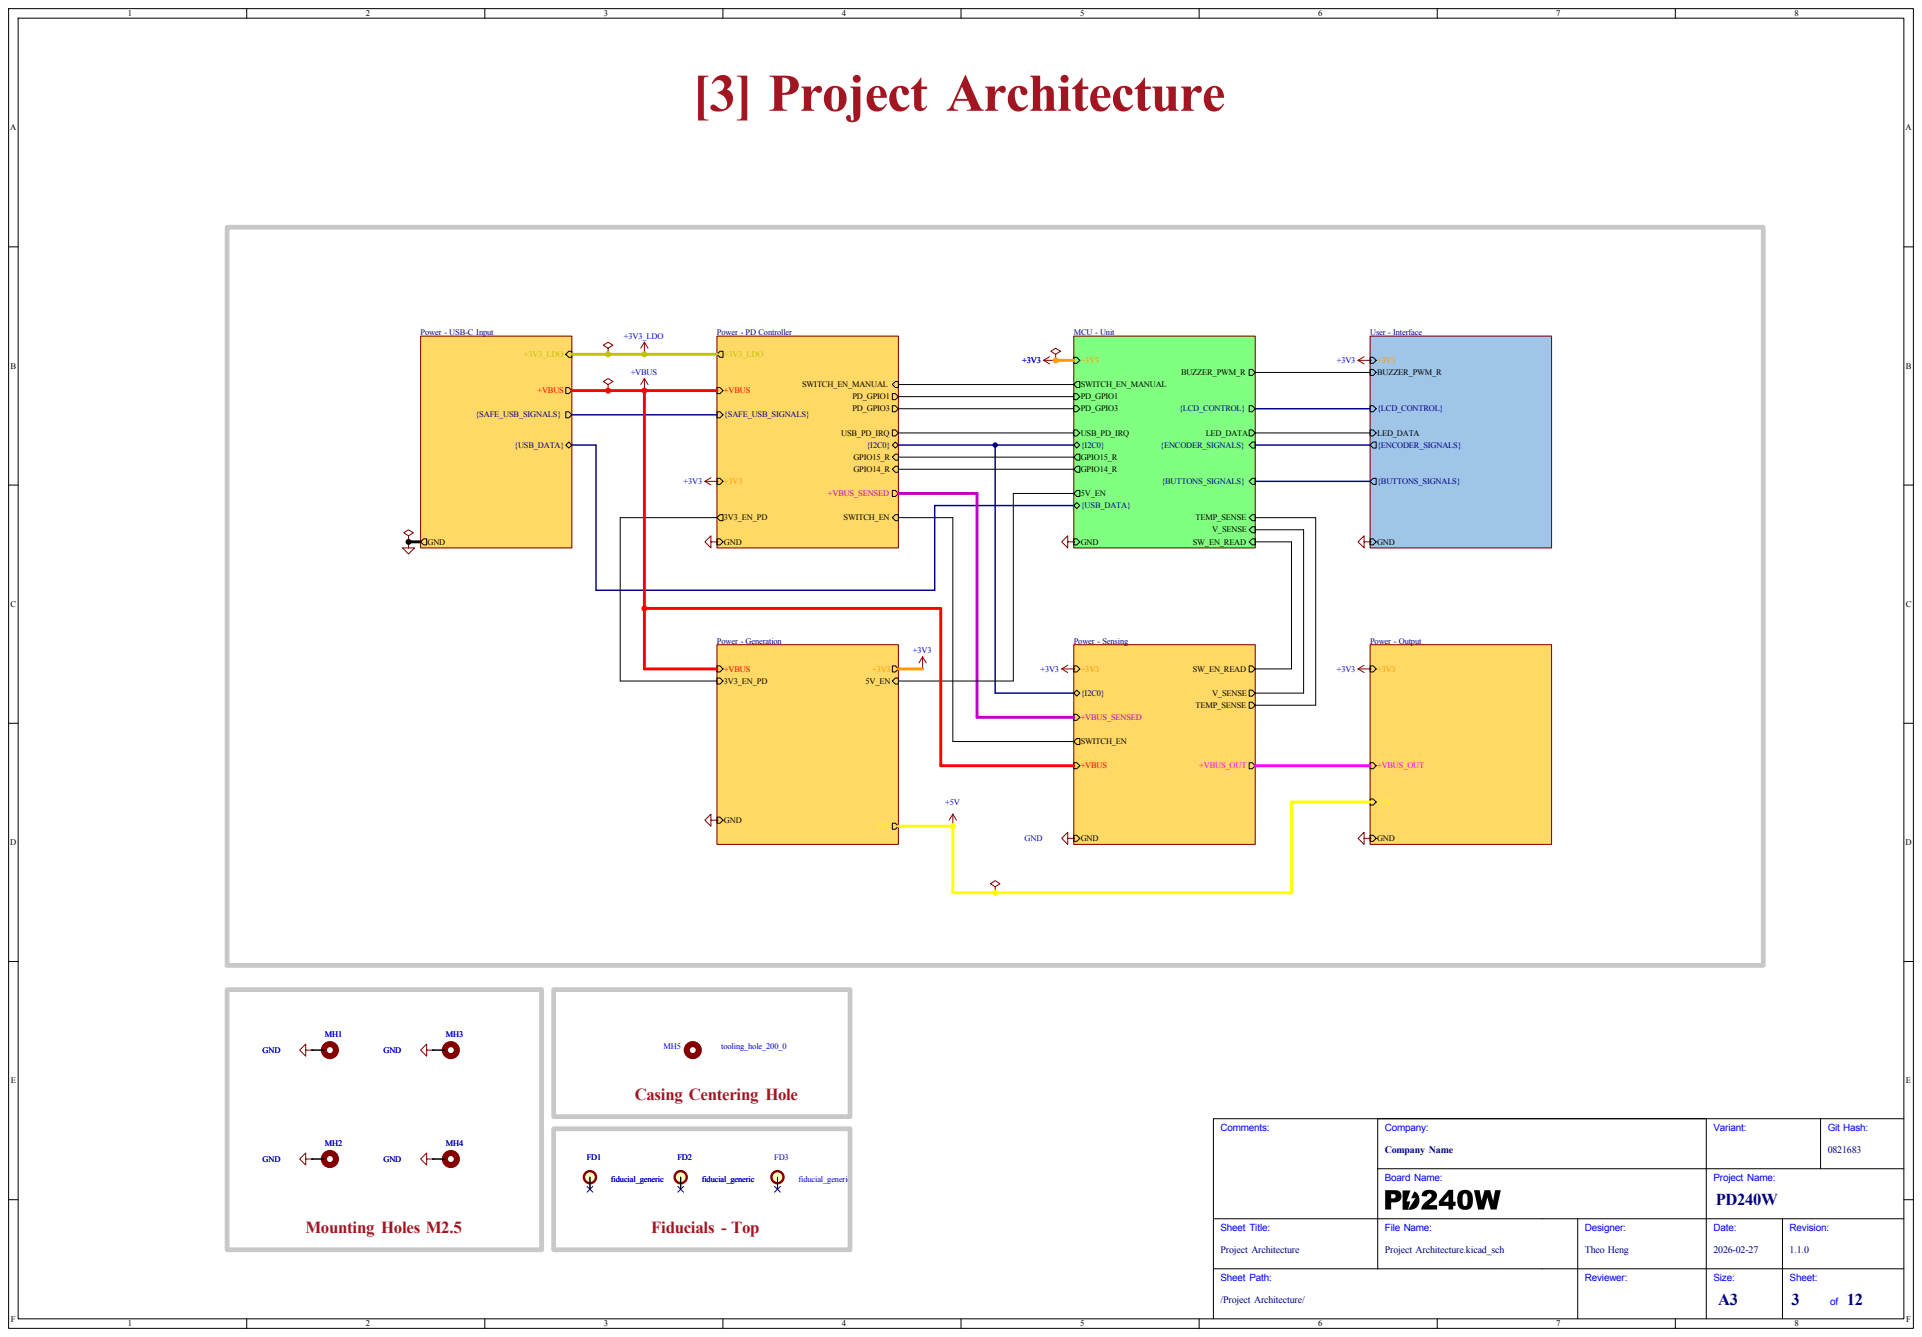
[picture p31: page 3]

Revision: 1.1.0 Date: Project Name: 2026-02-27 Reviewer: Designer:

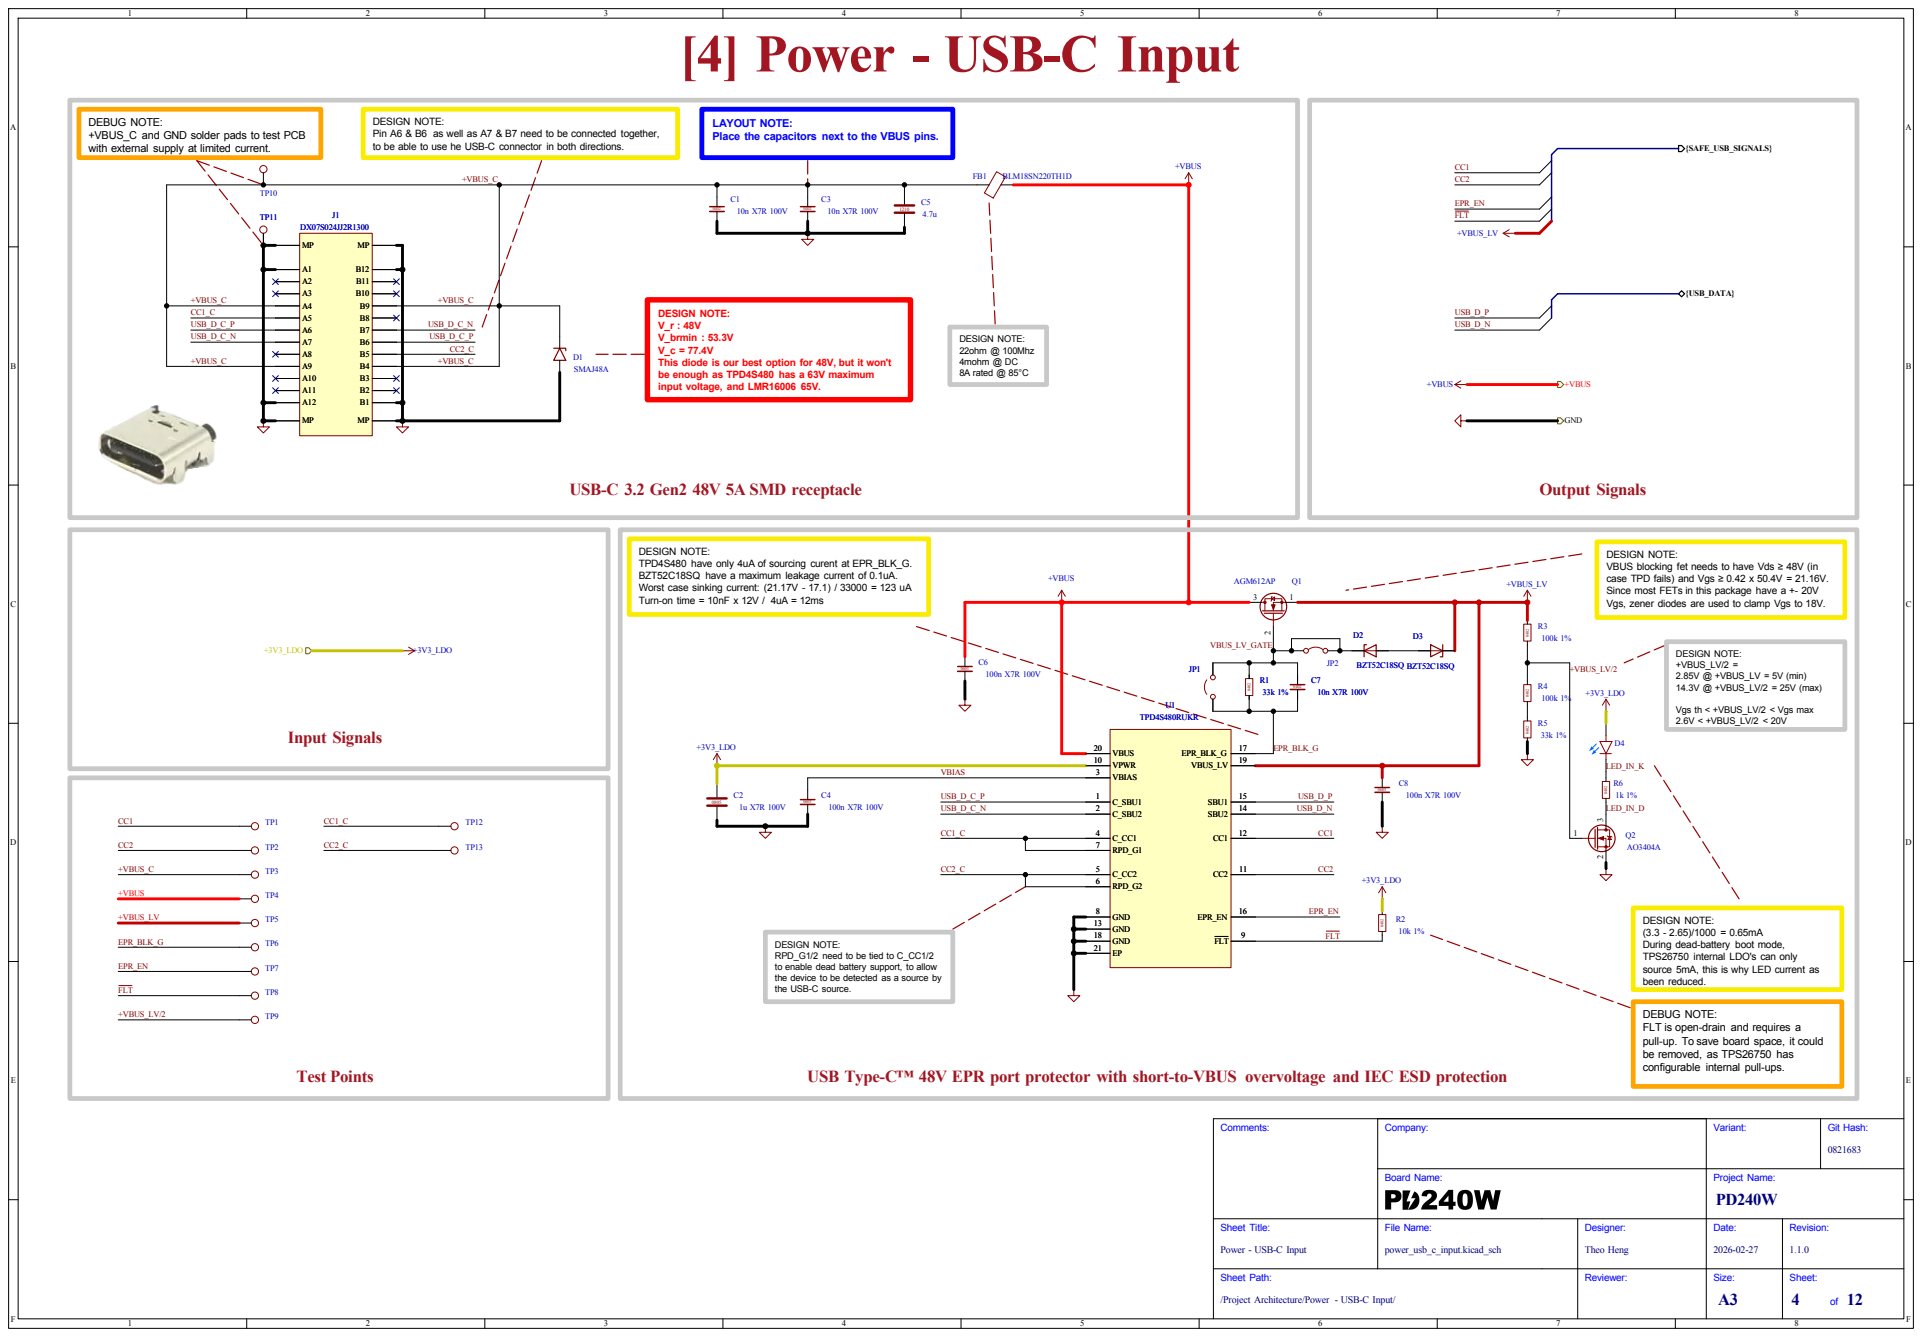
[picture p32: page 4]

DEBUG NOTE:
+VBUS_C and GND solder pads to test PCB
with external supply at limited current.

DESIGN NOTE: Pin A6 & B6 as well as A7 & B7 need to be connected together,

LAYOUT NOTE:
Place the capacitors next to the VBUS pins.

DESIGN NOTE:
V_brmin : 53.3V
This diode is our best option for 48V, but it won't be enough as TPD4S480 has a 63V maximum

TPD4S480 have only 4uA of sourcing curent at EPR_BLK_G.
BZT52C18SQ have a maximum leakage current of 0.1uA. Worst case sinking current: (21.17V - 17.1) / 33000 = 123 uA

VBUS blocking fet needs to have Vds ≥ 48V (in
case TPD fails) and Vgs ≥ 0.42 x 50.4V = 21.16V. Since most FETs in this package have a +- 20V

Turn-on time = 10nF x 12V / 4uA = 12ms DESIGN NOTE: RPD_G1/2 need to be tied to C_CC1/2

Vgs th < +VBUS_LV/2 < Vgs max 2.6V < +VBUS_LV/2 < 20V

(3.3 - 2.65)/1000 = 0.65mA During dead-battery boot mode,

to enable dead battery support, to allow
the device to be detected as a source by
the USB-C source.

TPS26750 internal LDO's can only
source 5mA, this is why LED current as been reduced.

FLT is open-drain and requires a
pull-up. To save board space, it could
be removed, as TPS26750 has
configurable internal pull-ups.

USB Type-C™ 48V EPR port protector with short-to-VBUS overvoltage and IEC ESD protection

Revision: 1.1.0 Date: Project Name: 2026-02-27 Reviewer: Designer:

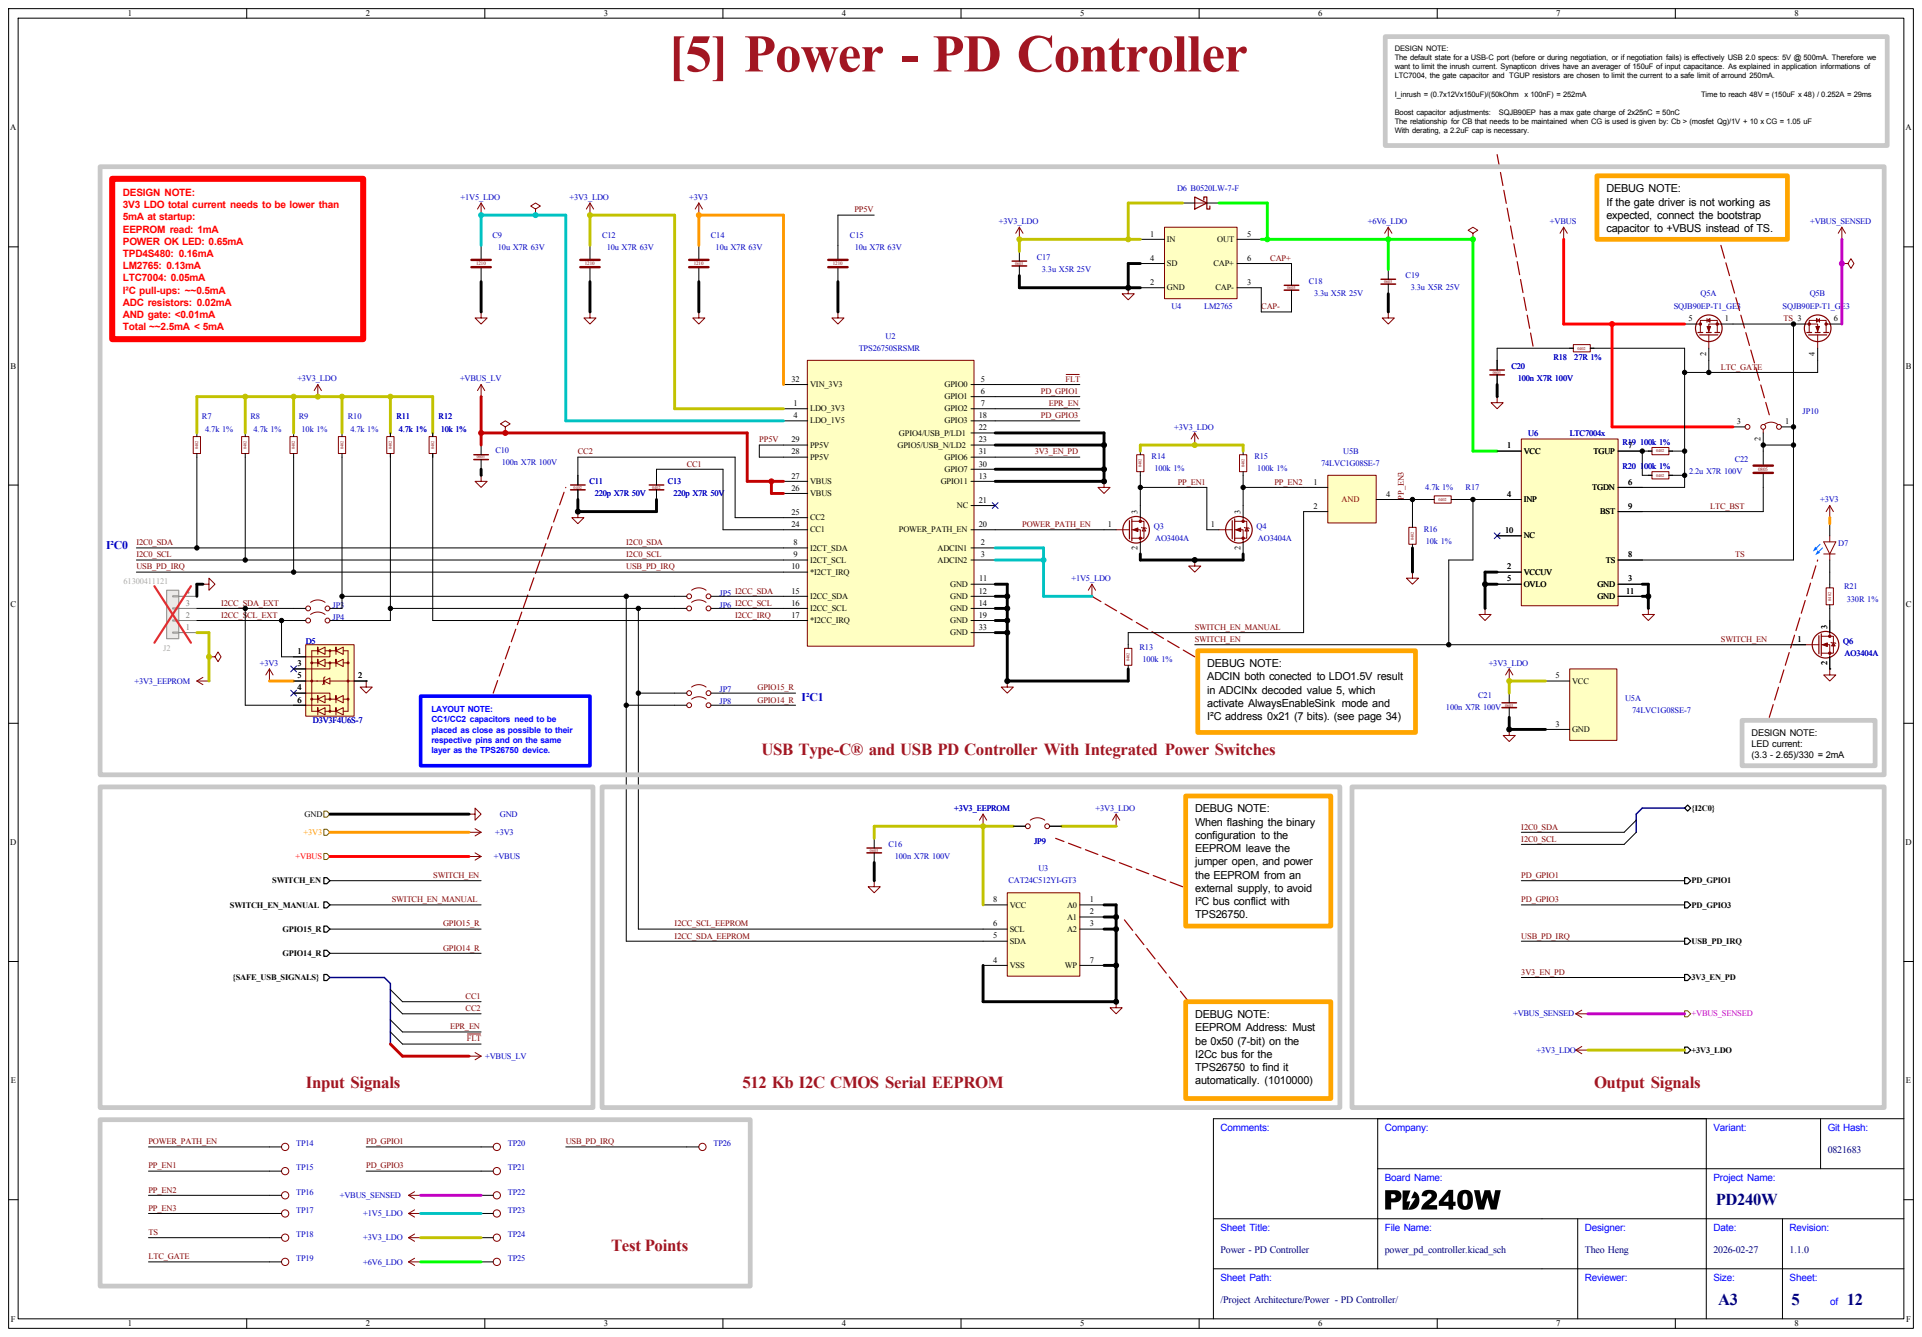
[picture p33: page 5]

The relationship for CB that needs to be maintained when CG is used is given by: Cb > (mosfet Qg)/1V + 10 x CG = 1.05 uF With derating, a 2.2uF cap is necessary. [5] Power - PD Controller

DESIGN NOTE: The default state for a USB-C port (before or during negotiation, or if negotiation fails) is effectively USB 2.0 specs: 5V @ 500mA. Therefore we want to limit the inrush current. Synapticon drives have an averager of 150uF of input capacitance. As explained in application informations of LTC7004, the gate capacitor and TGUP resistors are chosen to limit the current to a safe limit of arround 250mA.
capacitor to +VBUS instead of TS. DESIGN NOTE: LED current: (3.3 - 2.65)/330 = 2mA

DEBUG NOTE:
If the gate driver is not working as expected, connect the bootstrap

DESIGN NOTE: 3V3 LDO total current needs to be lower than

SWITCH_EN_MANUAL
SWITCH_EN
ADCIN both conected to LDO1.5V result
in ADCINx decoded value 5, which
activate AlwaysEnableSink mode and

I²C address 0x21 (7 bits). (see page 34) LAYOUT NOTE: CC1/CC2 capacitors need to be placed as close as possible to their

respective pins and on the same

USB Type-C® and USB PD Controller With Integrated Power Switches

When flashing the binary
configuration to the
EEPROM leave the
jumper open, and power
the EEPROM from an
external supply, to avoid
I²C bus conflict with
TPS26750.

EEPROM Address: Must
be 0x50 (7-bit) on the
I2Cc bus for the
TPS26750 to find it
automatically. (1010000)

Revision: 1.1.0 Date: Project Name: 2026-02-27 Reviewer: Designer:

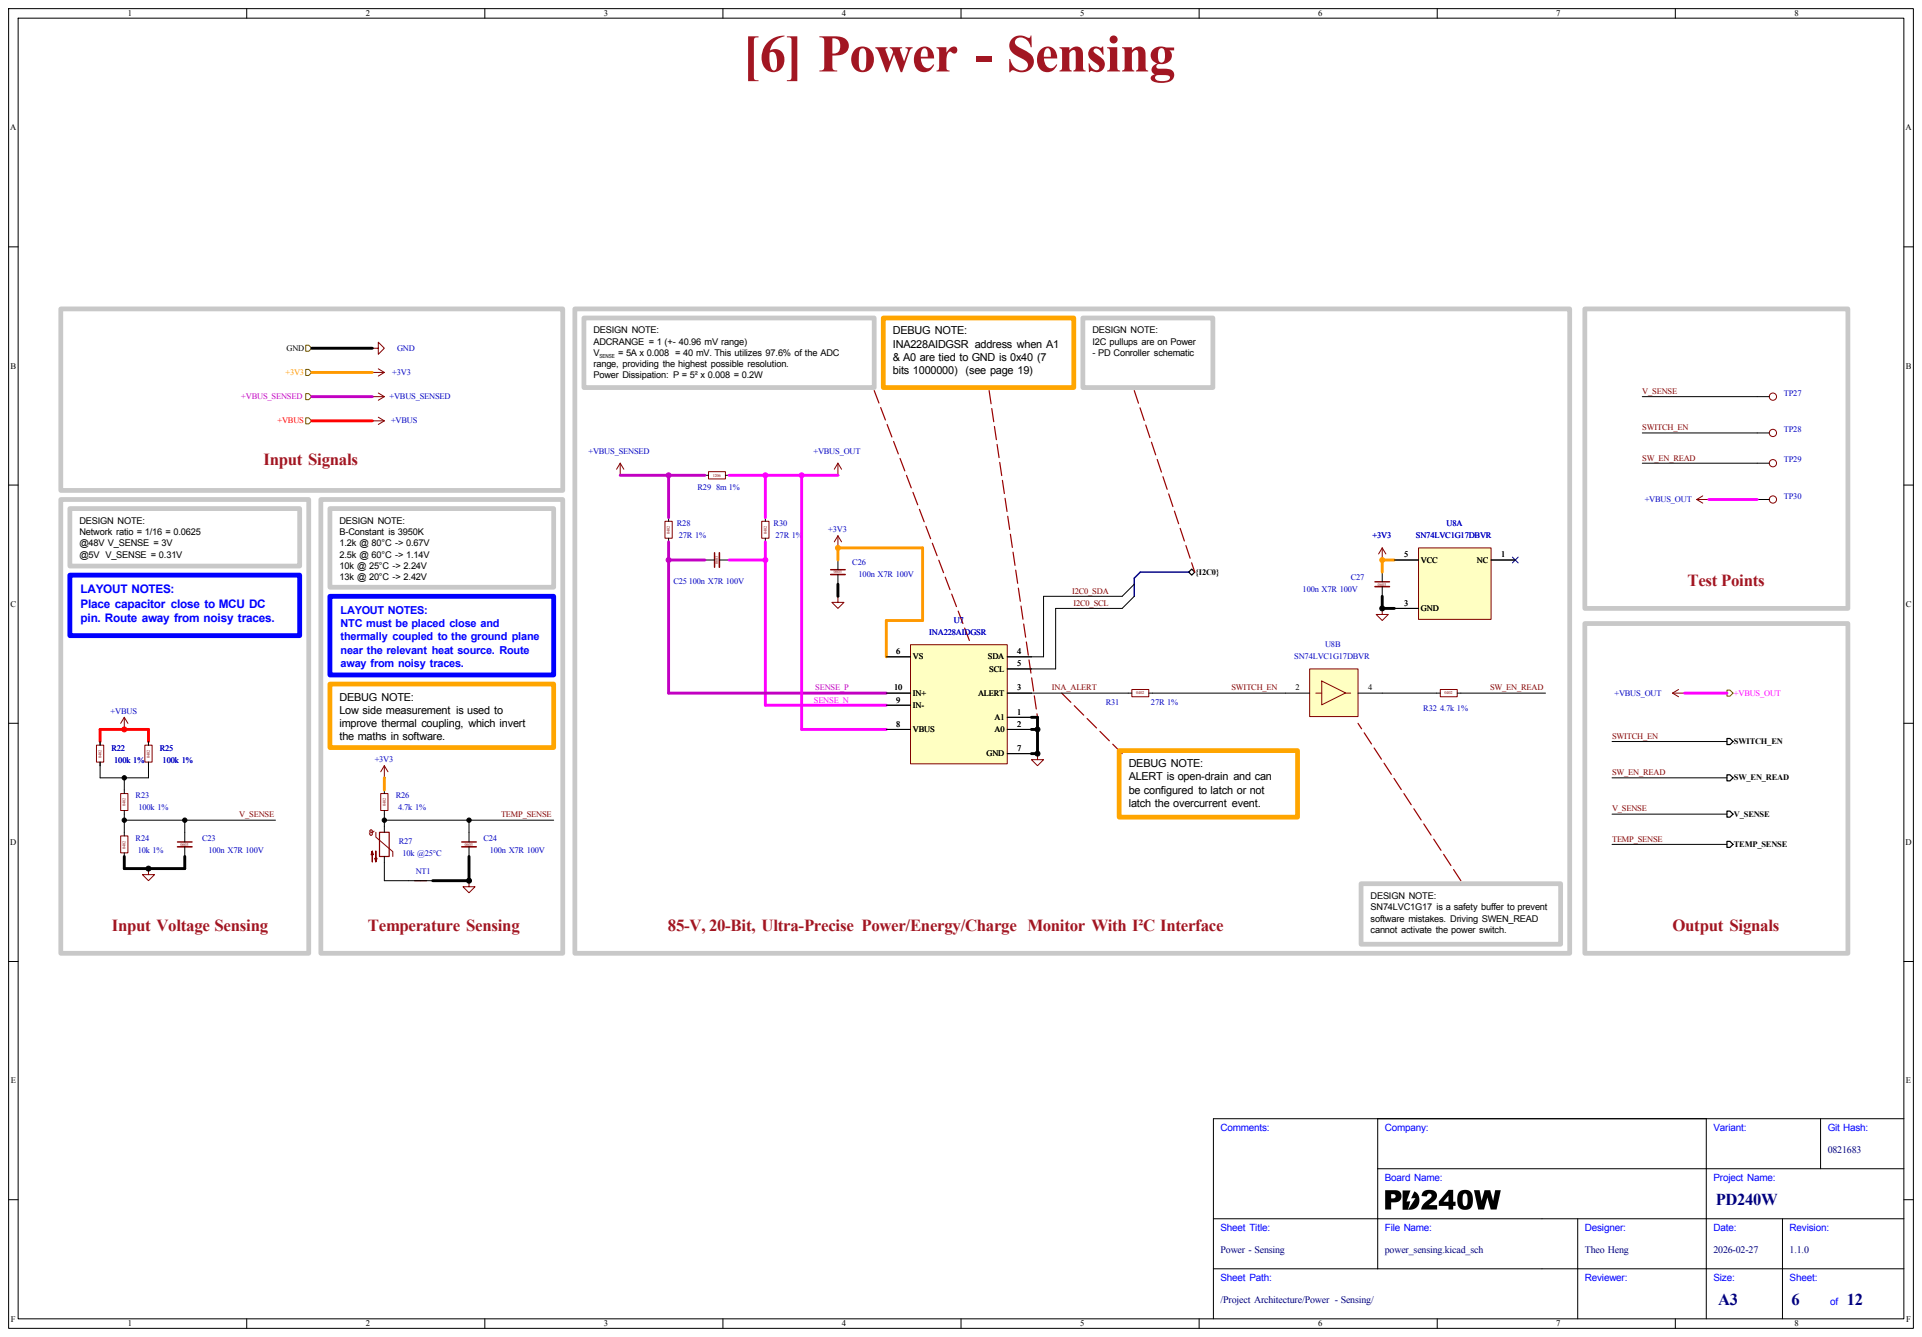
[picture p34: page 6]

- PD Conroller schematic [6] Power - Sensing

DESIGN NOTE: ADCRANGE = 1 (+- 40.96 mV range) VSENSE = 5A x 0.008 = 40 mV. This utilizes 97.6% of the ADC

DEBUG NOTE:
INA228AIDGSR address when A1
& A0 are tied to GND is 0x40 (7

I2C pullups are on Power

range, providing the highest possible resolution. Power Dissipation: P = 5² x 0.008 = 0.2W

TEMP_SENSE DESIGN NOTE: B-Constant is 3950K

13k @ 20°C -> 2.42V LAYOUT NOTES:
Place capacitor close to MCU DC

LAYOUT NOTES:
NTC must be placed close and
thermally coupled to the ground plane near the relevant heat source. Route

away from noisy traces.

cannot activate the power switch. DEBUG NOTE:
Low side measurement is used to
improve thermal coupling, which invert
the maths in software.

ALERT is open-drain and can
be configured to latch or not
latch the overcurrent event.

85-V, 20-Bit, Ultra-Precise Power/Energy/Charge Monitor With I²C Interface

Revision: 1.1.0 Date: Project Name: 2026-02-27 Reviewer: Designer:

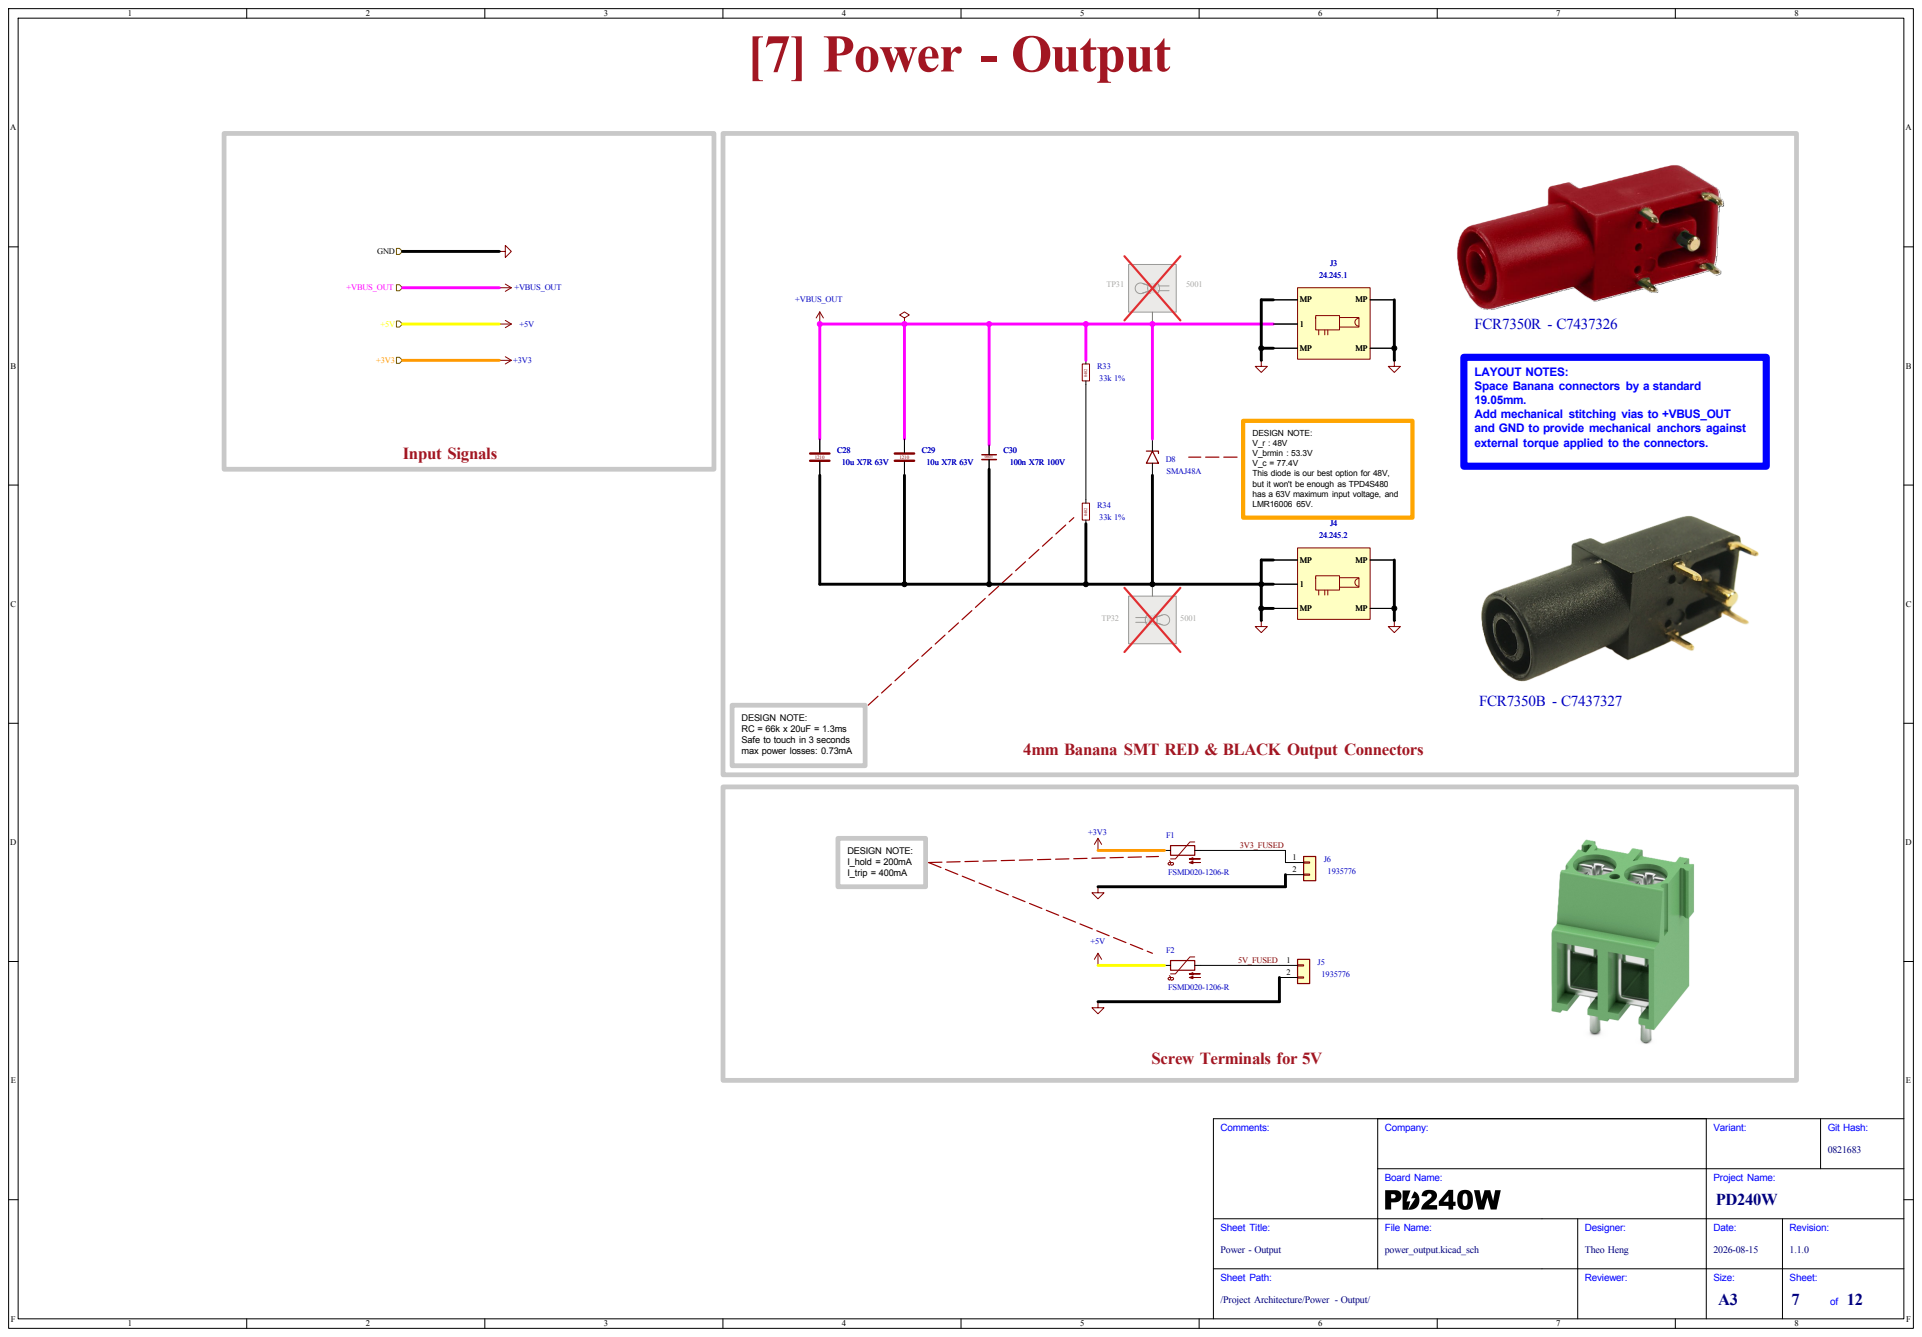
[picture p35: page 7]

Space Banana connectors by a standard
Add mechanical stitching vias to +VBUS_OUT
and GND to provide mechanical anchors against
external torque applied to the connectors.

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

has a 63V maximum input voltage, and

4mm Banana SMT RED & BLACK Output Connectors

Revision: 1.1.0 Date: Project Name: 2026-08-15 Reviewer: Designer:

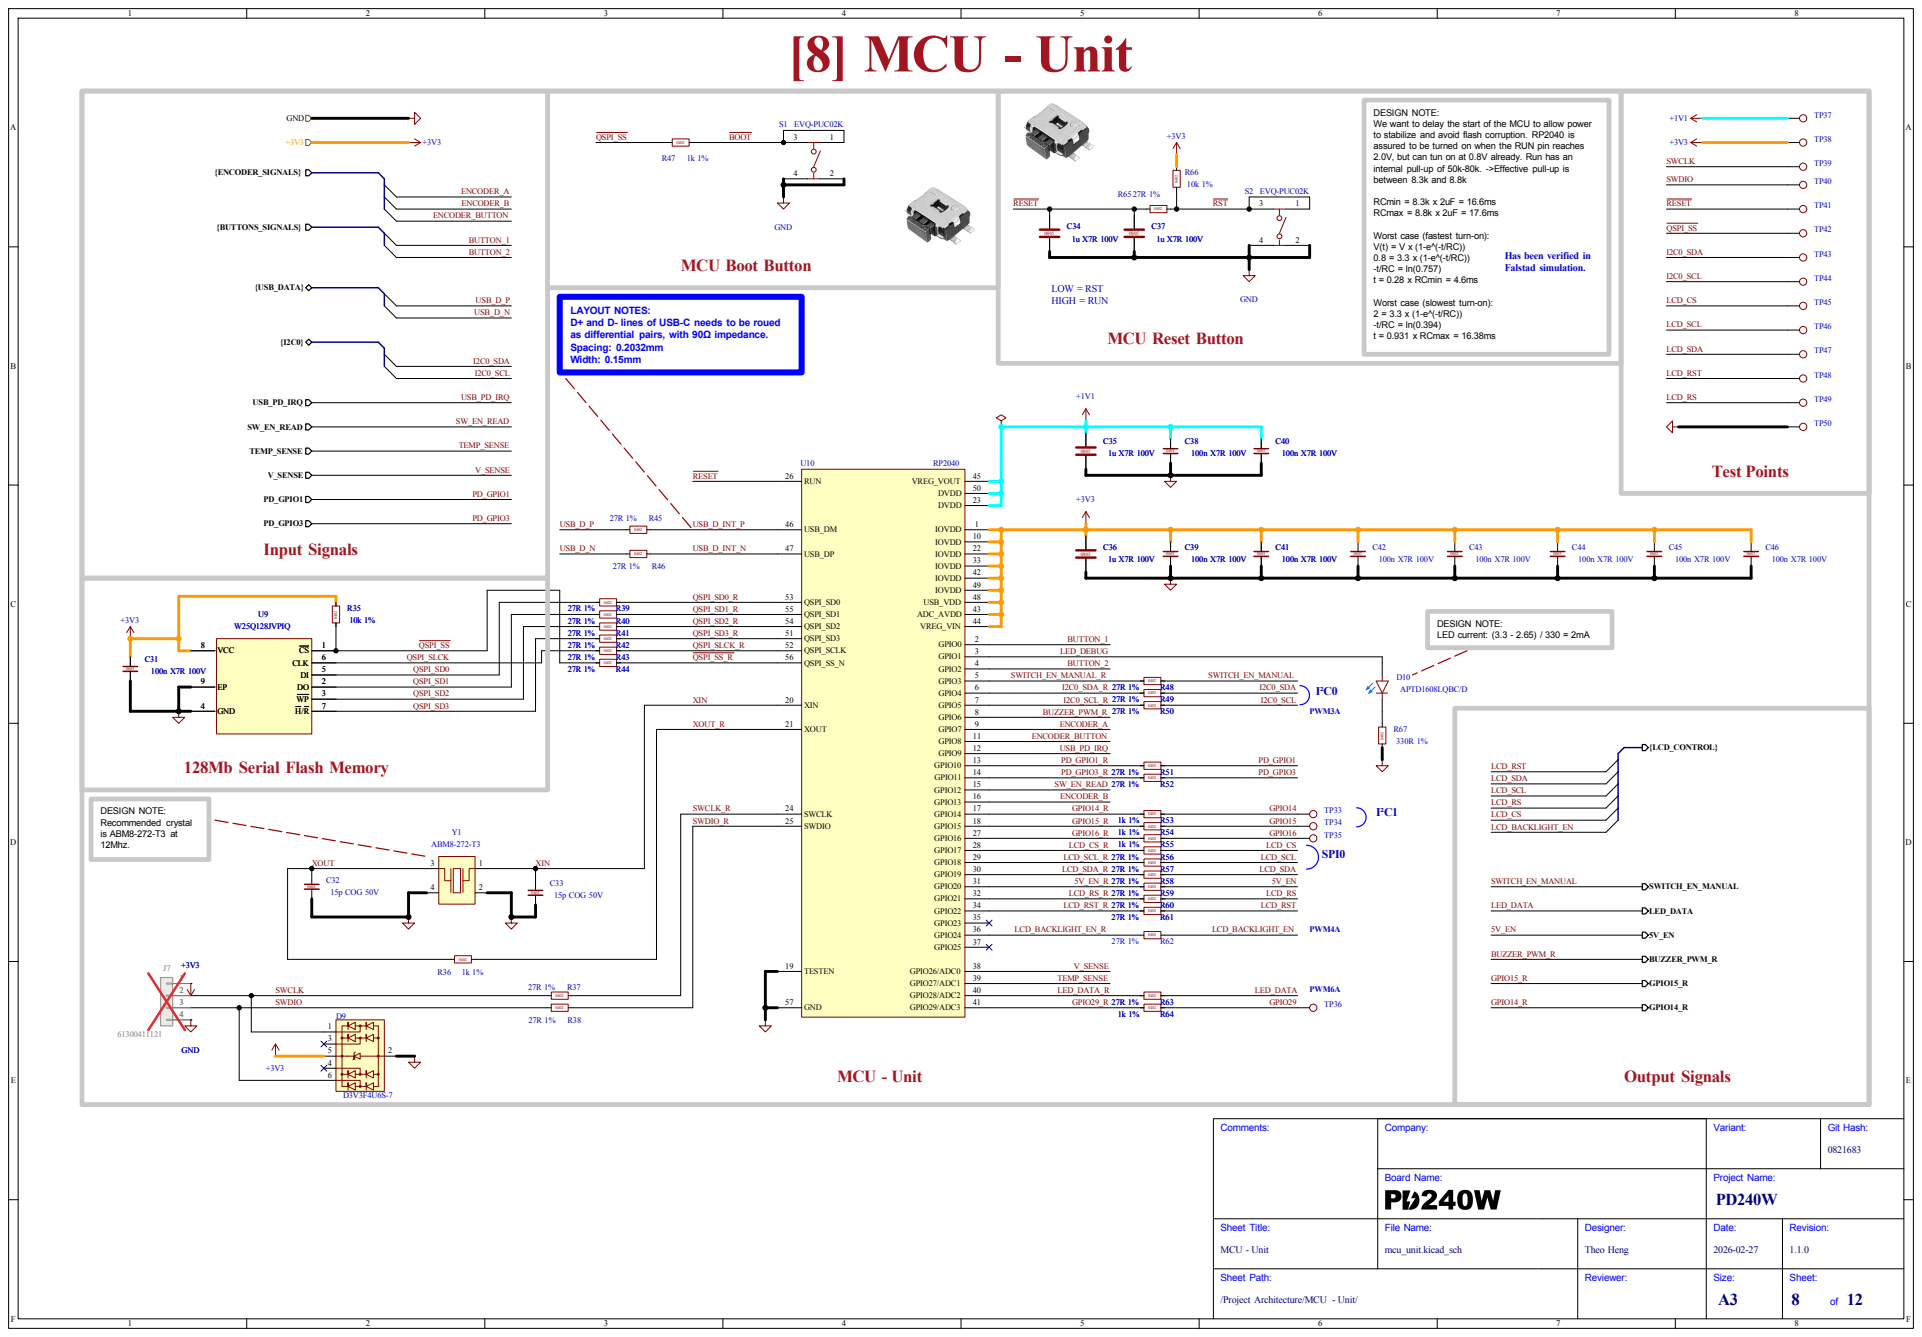
[picture p36: page 8]

Has been verified in Falstad simulation. [8] MCU - Unit

DESIGN NOTE: We want to delay the start of the MCU to allow power

to stabilize and avoid flash corruption. RP2040 is assured to be turned on when the RUN pin reaches 2.0V, but can tun on at 0.8V already. Run has an

internal pull-up of 50k-80k. ->Effective pull-up is between 8.3k and 8.8k RCmin = 8.3k x 2uF = 16.6ms RCmax = 8.8k x 2uF = 17.6ms Worst case (fastest turn-on):

t = 0.28 x RCmin = 4.6ms Worst case (slowest turn-on): 2 = 3.3 x (1-e^(-t/RC))

LOW = RST HIGH = RUN

LAYOUT NOTES: D+ and D- lines of USB-C needs to be roued

as differential pairs, with 90Ω impedance.
Spacing: 0.2032mm Width: 0.15mm

DESIGN NOTE: LED current: (3.3 - 2.65) / 330 = 2mA MCU Reset Button

t = 0.931 x RCmax = 16.38ms DESIGN NOTE: Recommended crystal

27R 1% R40 QSPI_SD2_R
27R 1% R41

Revision: 1.1.0 Date: Project Name: 2026-02-27 Reviewer: Designer:

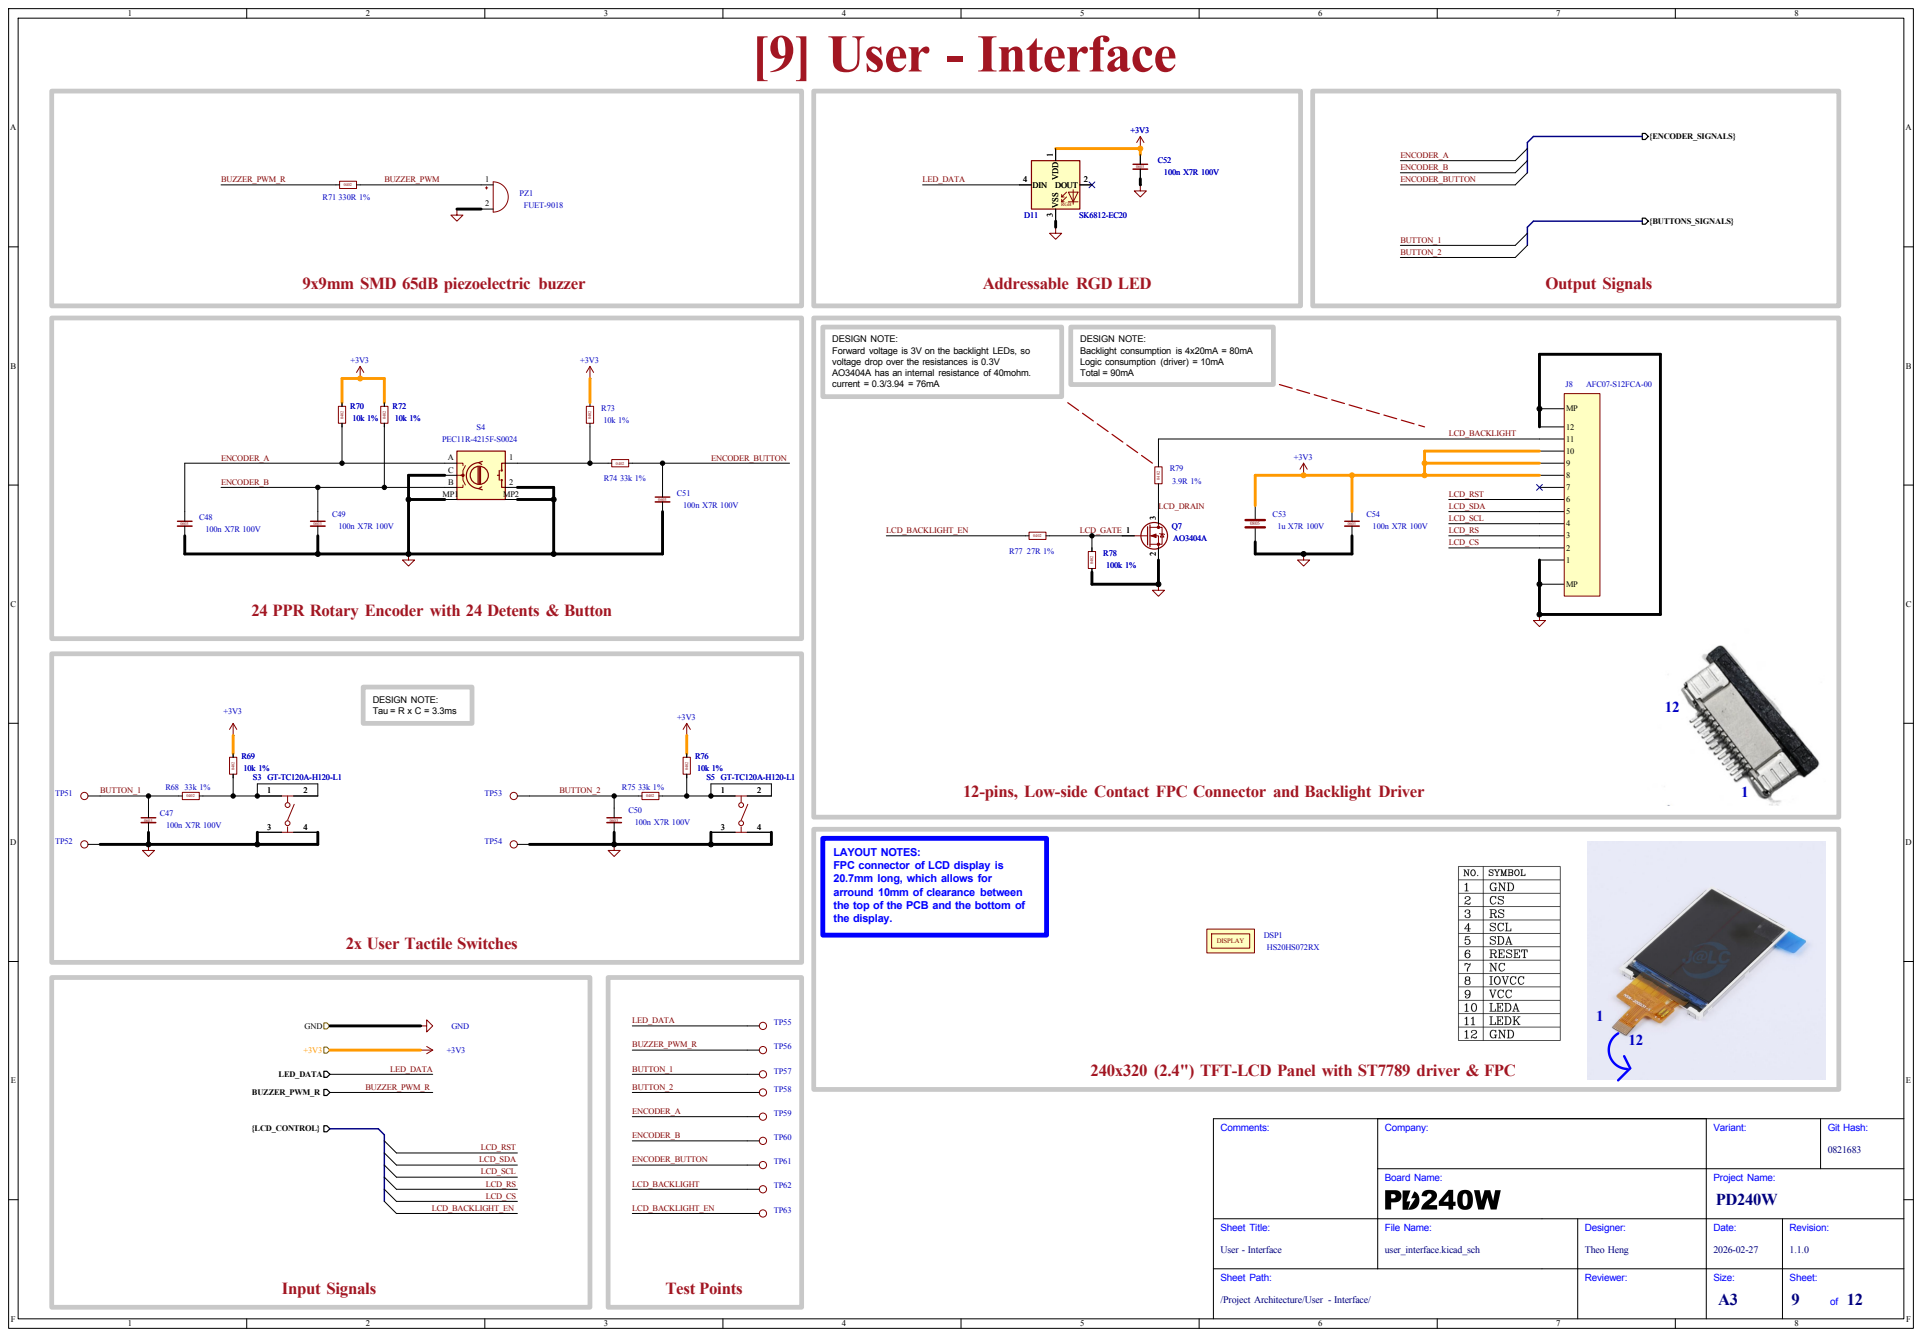
[picture p37: page 9]

DESIGN NOTE: Forward voltage is 3V on the backlight LEDs, so

voltage drop over the resistances is 0.3V

24 PPR Rotary Encoder with 24 Detents & Button

12-pins, Low-side Contact FPC Connector and Backlight Driver

LAYOUT NOTES:
FPC connector of LCD display is
20.7mm long, which allows for
arround 10mm of clearance between
the top of the PCB and the bottom of
the display.

240x320 (2.4") TFT-LCD Panel with ST7789 driver & FPC

Revision: 1.1.0 Date: Project Name: 2026-02-27 Reviewer: Designer:

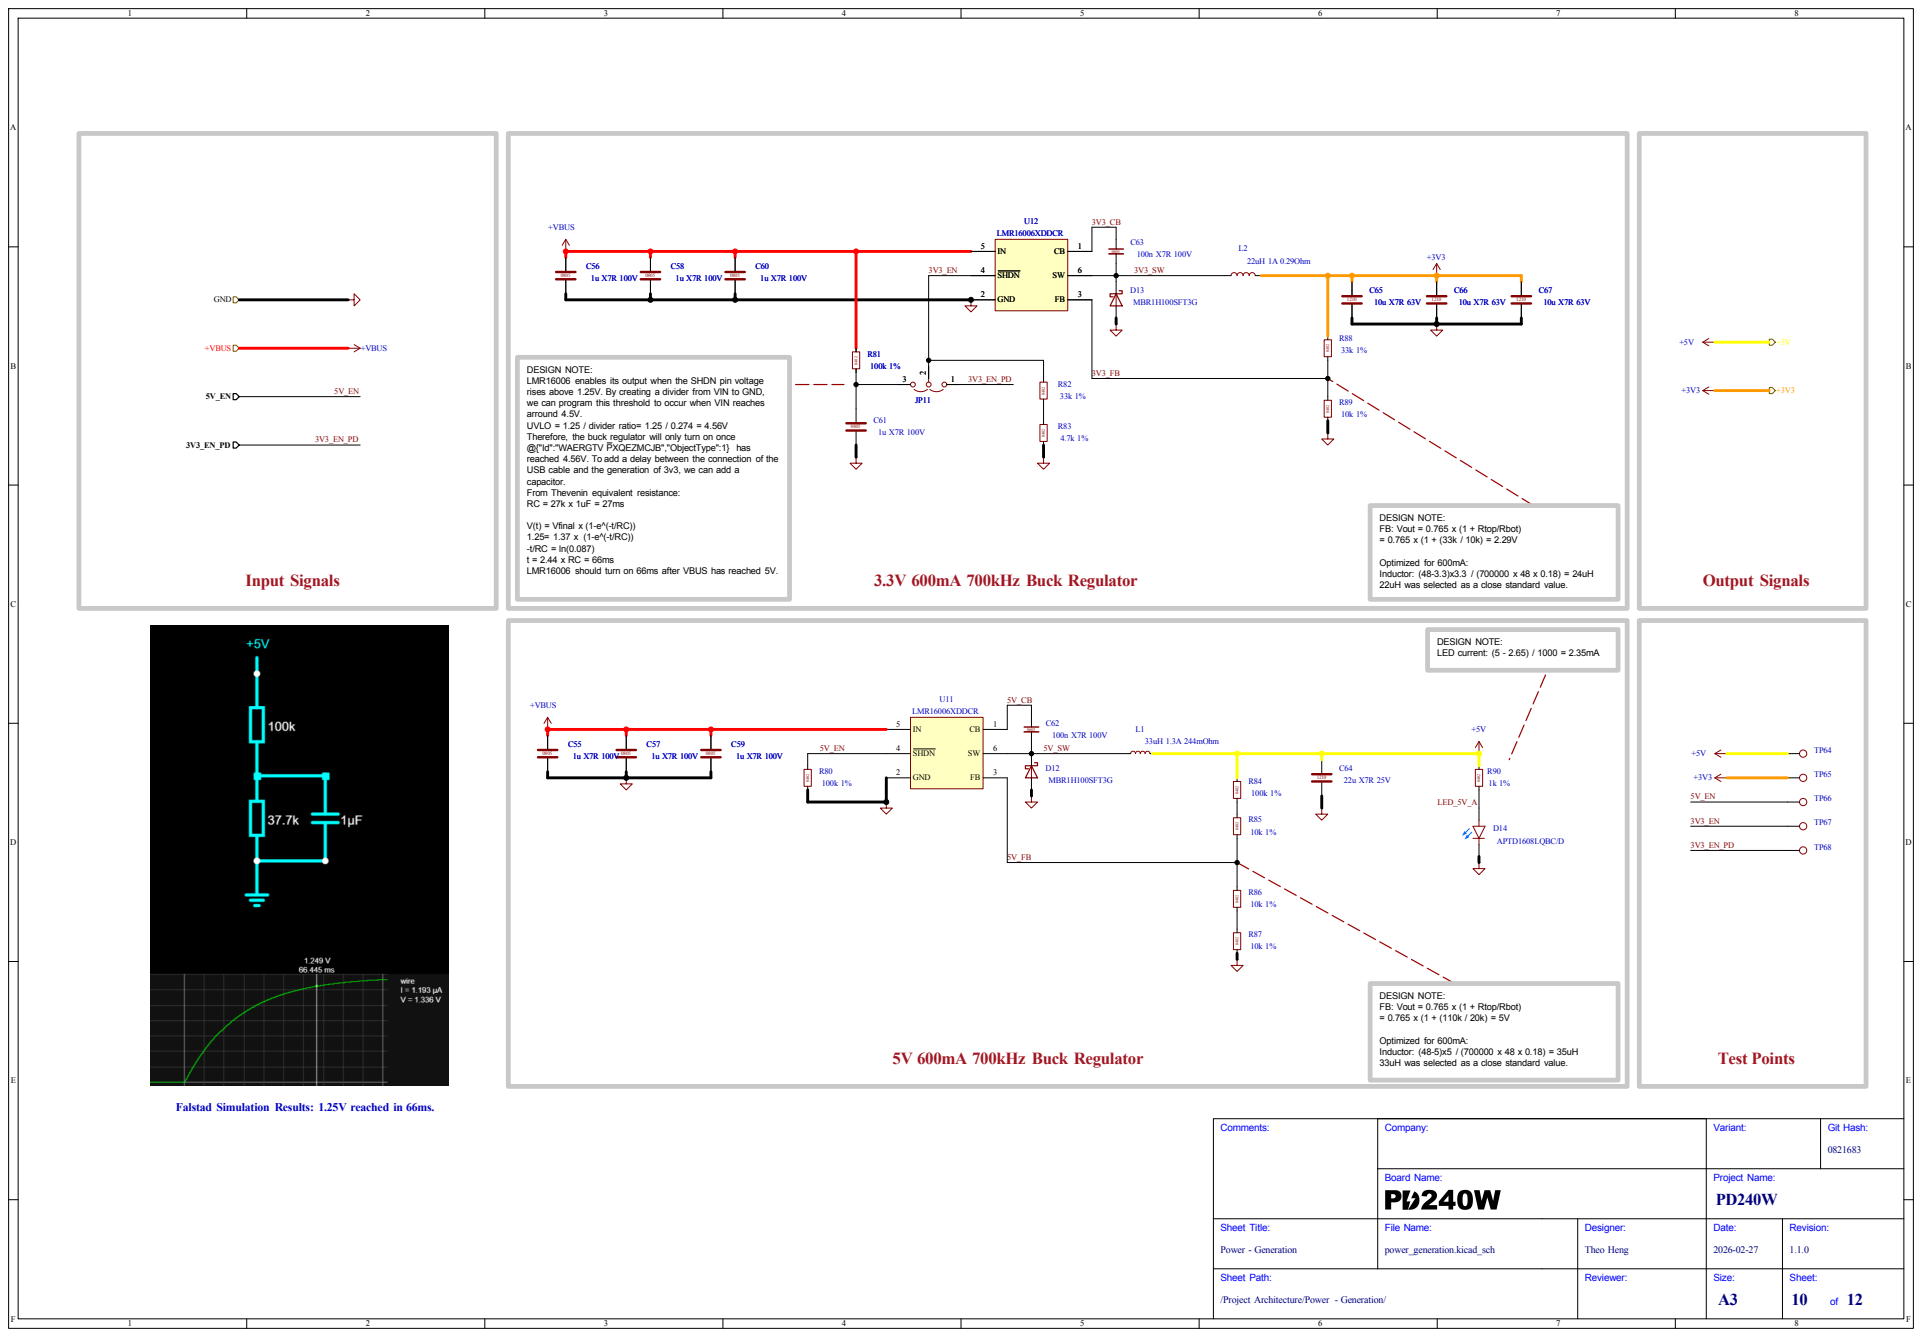
[picture p38: page 10]

22uH was selected as a close standard value. DESIGN NOTE: LED current: (5 - 2.65) / 1000 = 2.35mA DESIGN NOTE: LMR16006 enables its output when the SHDN pin voltage

rises above 1.25V. By creating a divider from VIN to GND, we can program this threshold to occur when VIN reaches arround 4.5V. UVLO = 1.25 / divider ratio= 1.25 / 0.274 = 4.56V

Therefore, the buck regulator will only turn on once @{"Id":"WAERGTV PXQEZMCJB","ObjectType":1} has

reached 4.56V. To add a delay between the connection of the USB cable and the generation of 3v3, we can add a

capacitor. From Thevenin equivalent resistance: RC = 27k x 1uF = 27ms V(t) = Vfinal x (1-e^(-t/RC)) 1.25= 1.37 x (1-e^(-t/RC))

Falstad Simulation Results: 1.25V reached in 66ms.

Revision: 1.1.0 Date: Project Name: 2026-02-27 Reviewer: Designer:

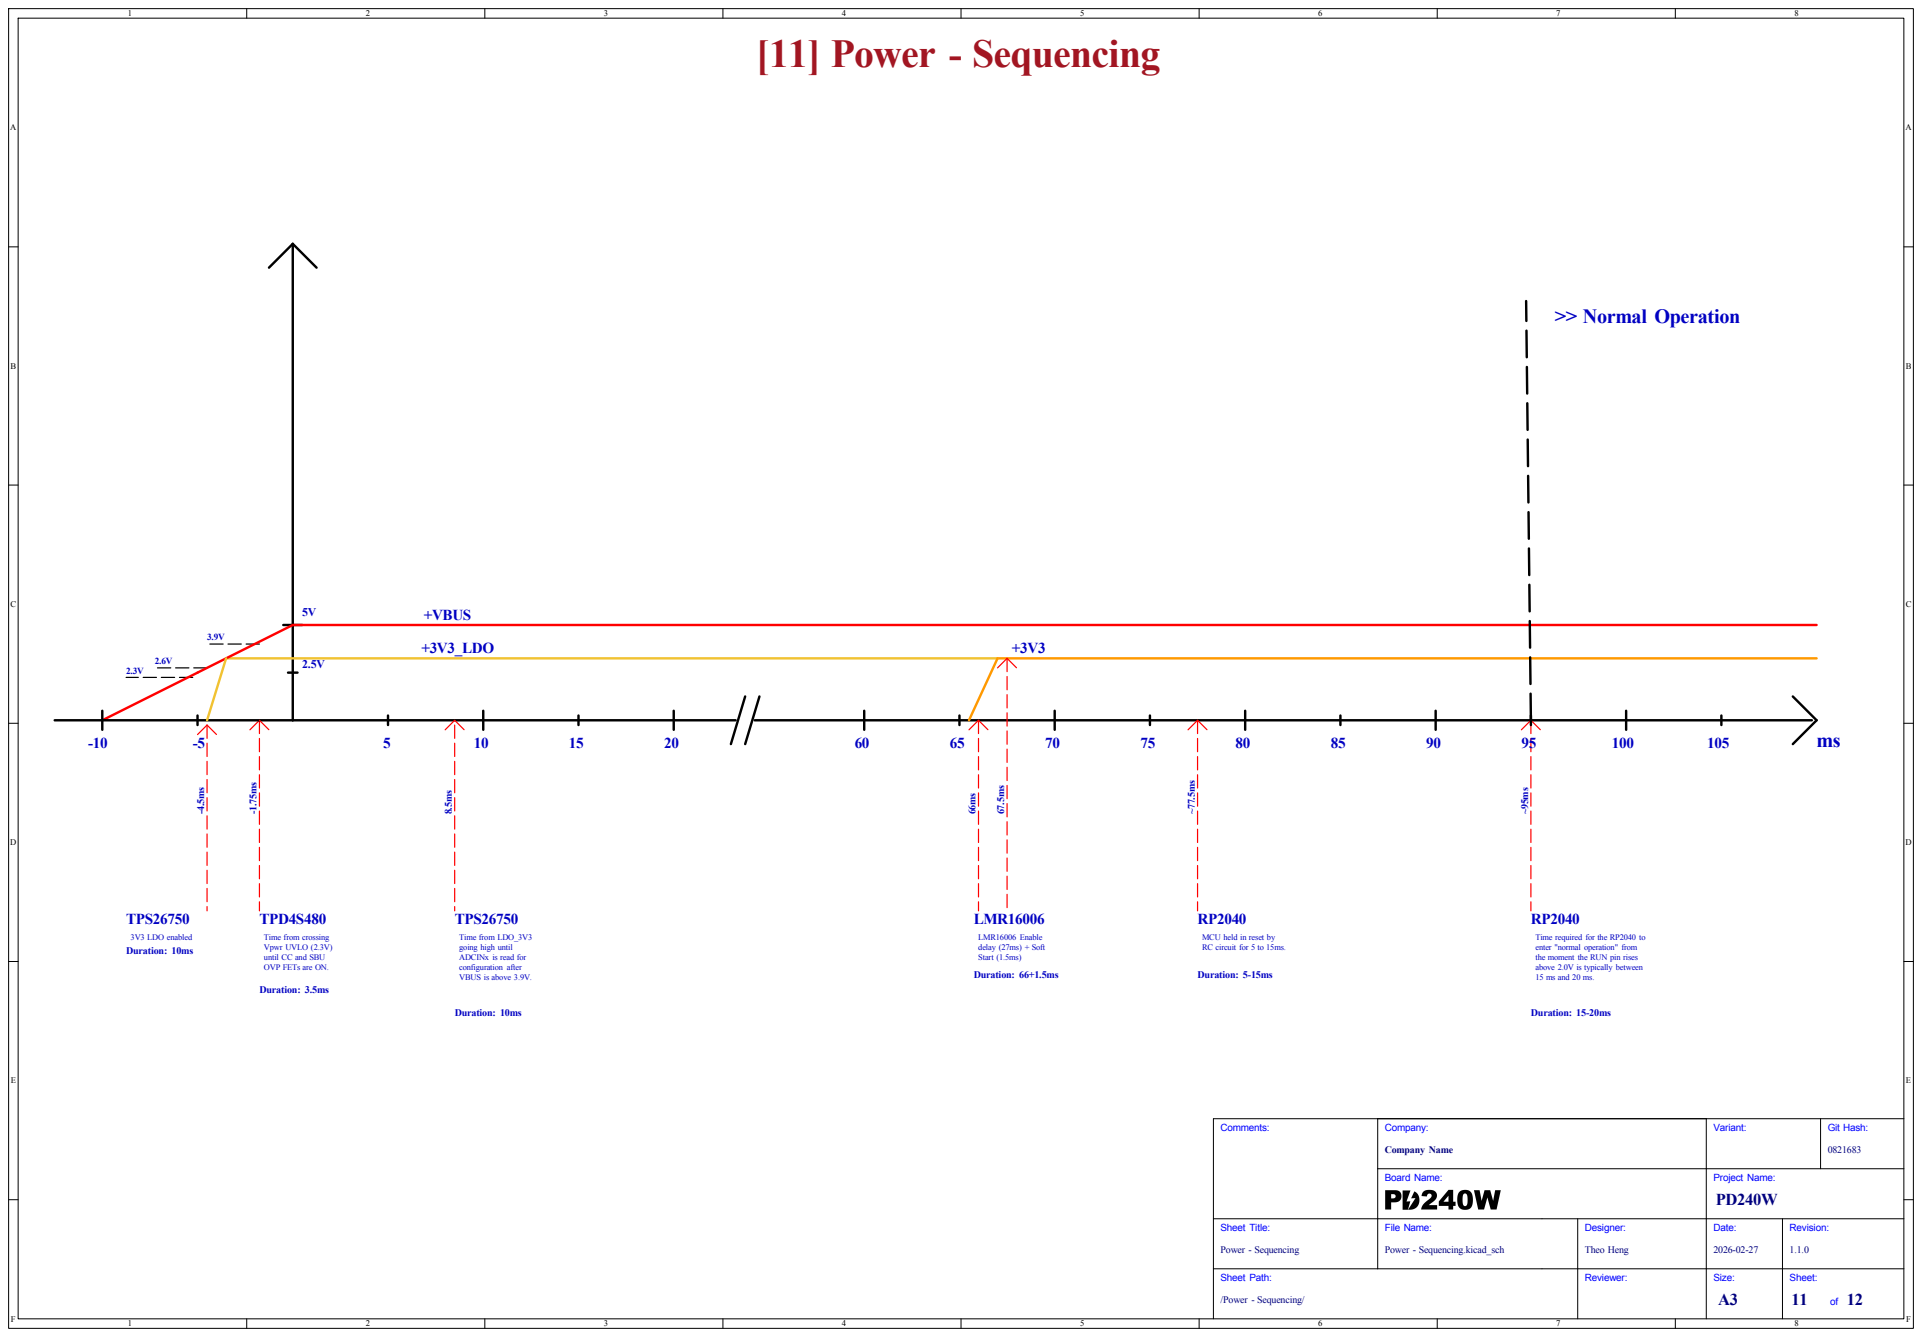
[picture p39: page 11]

Time from crossing Vpwr UVLO (2.3V) until CC and SBU

enter "normal operation" from
the moment the RUN pin rises above 2.0V is typically between

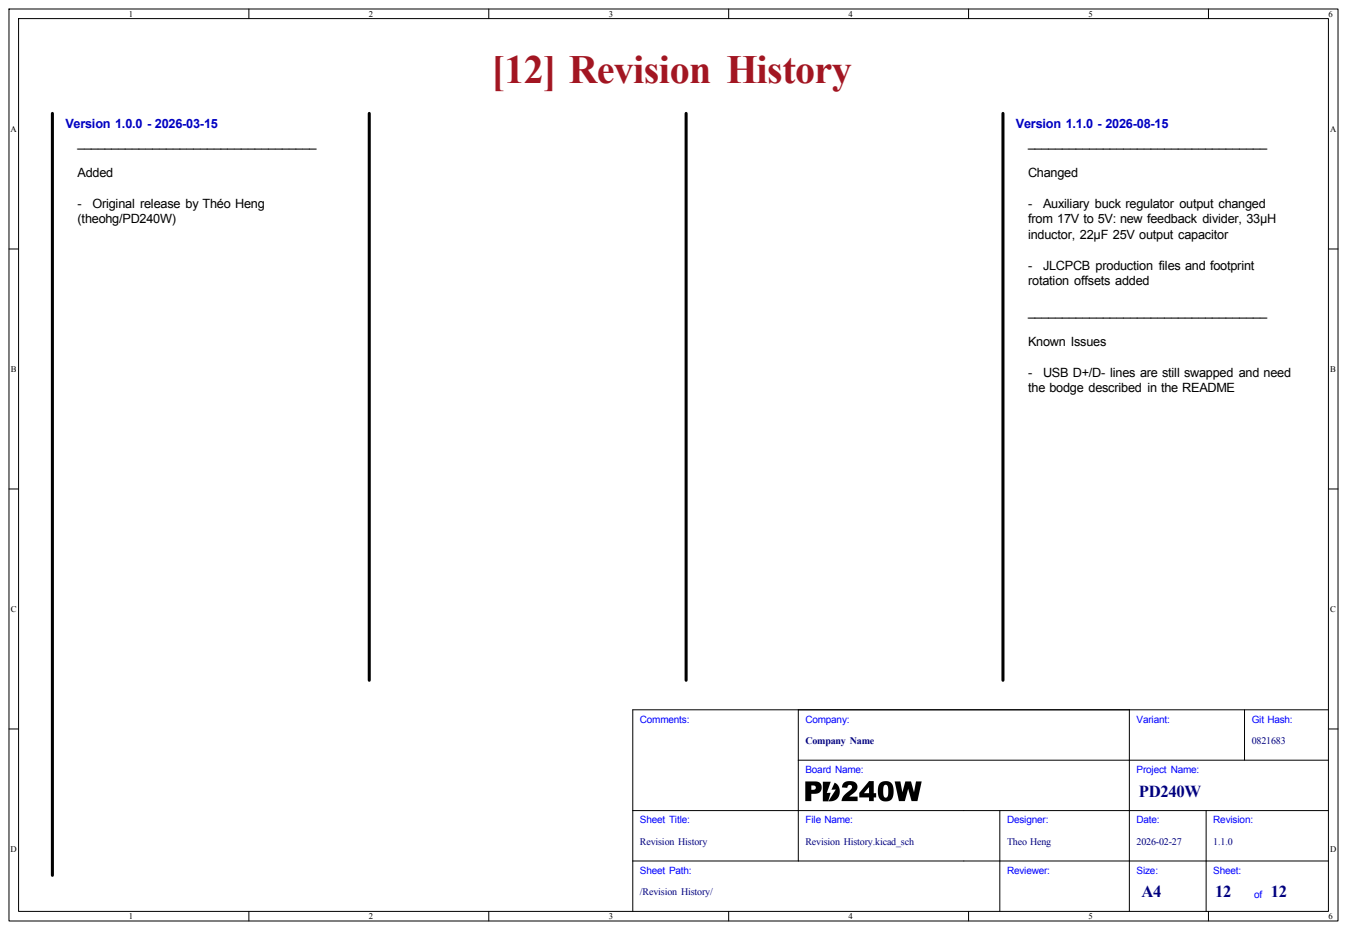
[picture p40: page 12]

- Original release by Théo Heng

- Auxiliary buck regulator output changed
from 17V to 5V: new feedback divider, 33µH
inductor, 22µF 25V output capacitor

- JLCPCB production files and footprint
rotation offsets added

- USB D+/D- lines are still swapped and need
the bodge described in the README
