RileyCornelius/PD240W/hardware/Manufacturing/Assembly/PD240W_kicad-assembly.pdf

# PD240W Assembly Document

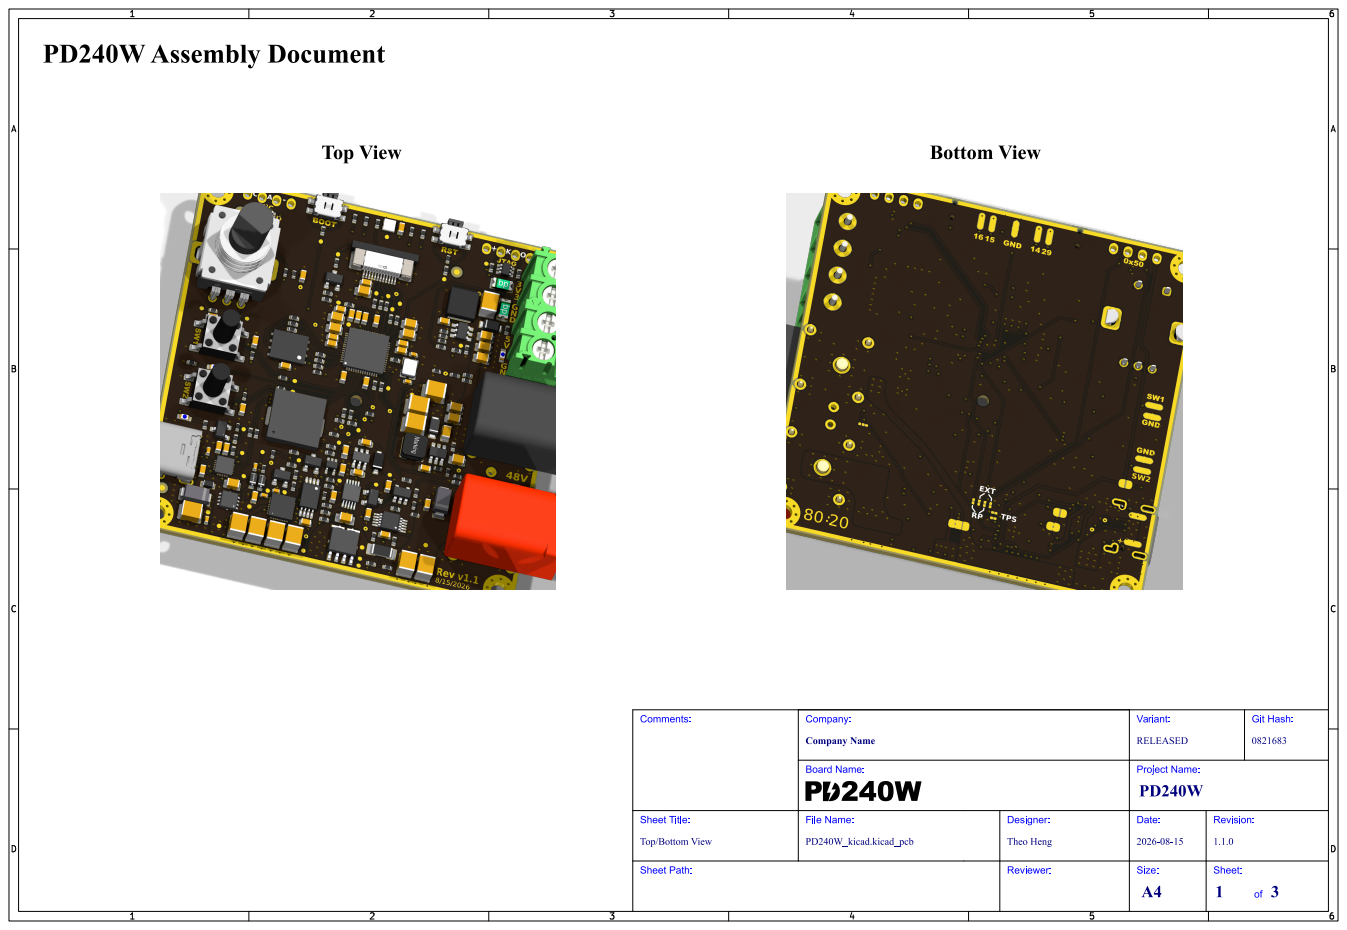
[picture p41: page 1]
Git; Hash:; Comments:; Sheet Path:; Sheet Title:; File Name:; Company Name; Company:; RELEASED; Variant:; Board Name:; PD240W_kicad.kicad_pcb; Theo Heng; Designer:; Reviewer:; Project Name:; Date:; Revision:; Size:; Sheet:

Top/Bottom View

# Top Assembly (Scale 1:1)

# PD240W Assembly Document

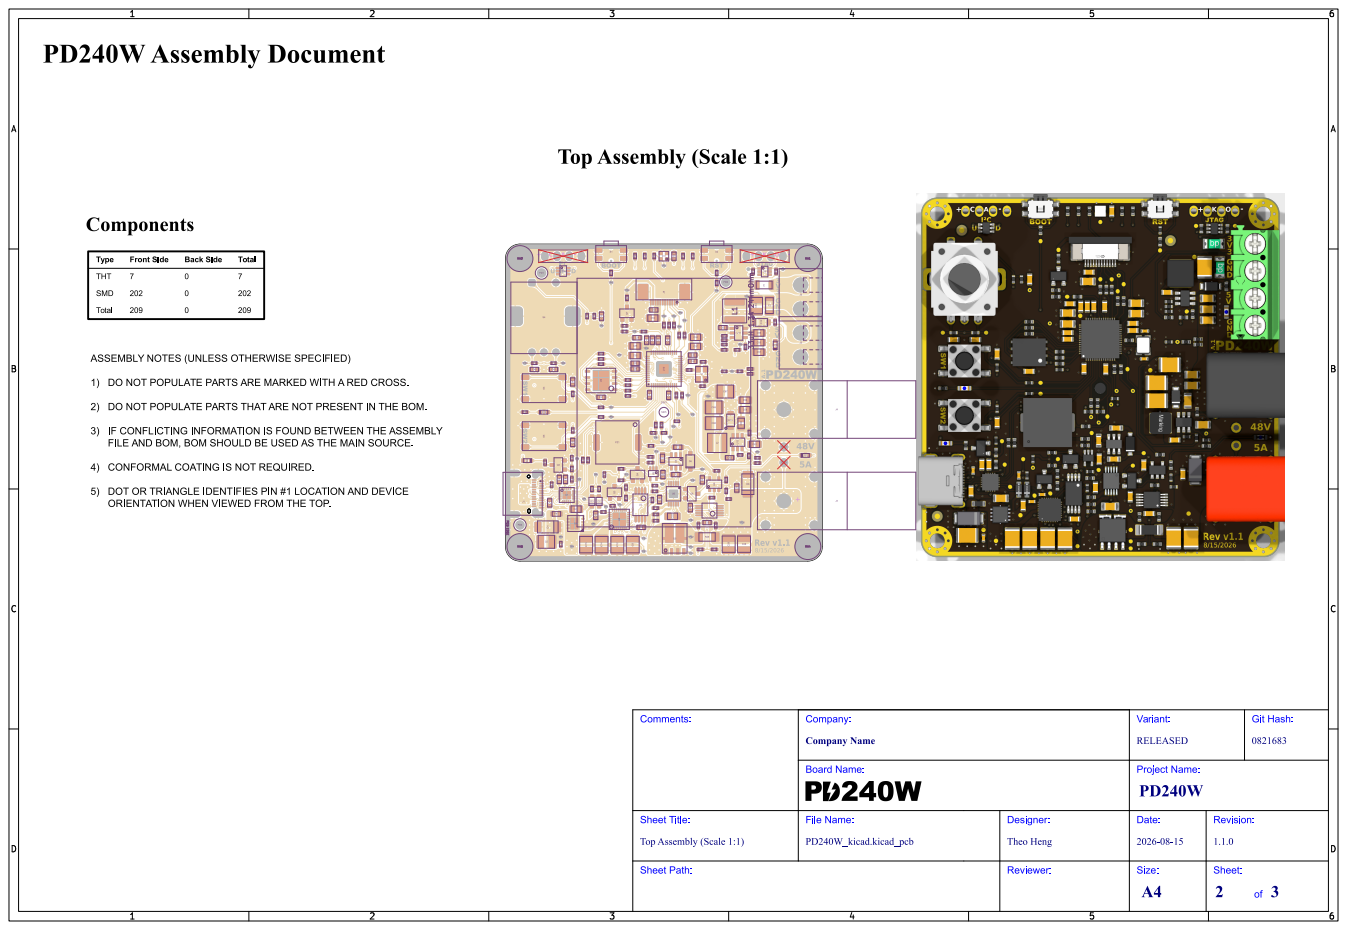
[picture p42: page 2]
Git Hash:; Comments:; Sheet Path:; Sheet Title:; File Name:; Company Name; Company:; RELEASED; Variant:; Board Name:; PD240W_kicad.kicad_pcb; Theo Heng; Designer:; Reviewer:; Project Name:; Date:; Revision:; Size:; Sheet:; PCB EDGE; 33uH 1.3A 244mOhm

Top Assembly (Scale 1:1)

# Bottom Assembly (Scale 1:1)

# PD240W Assembly Document

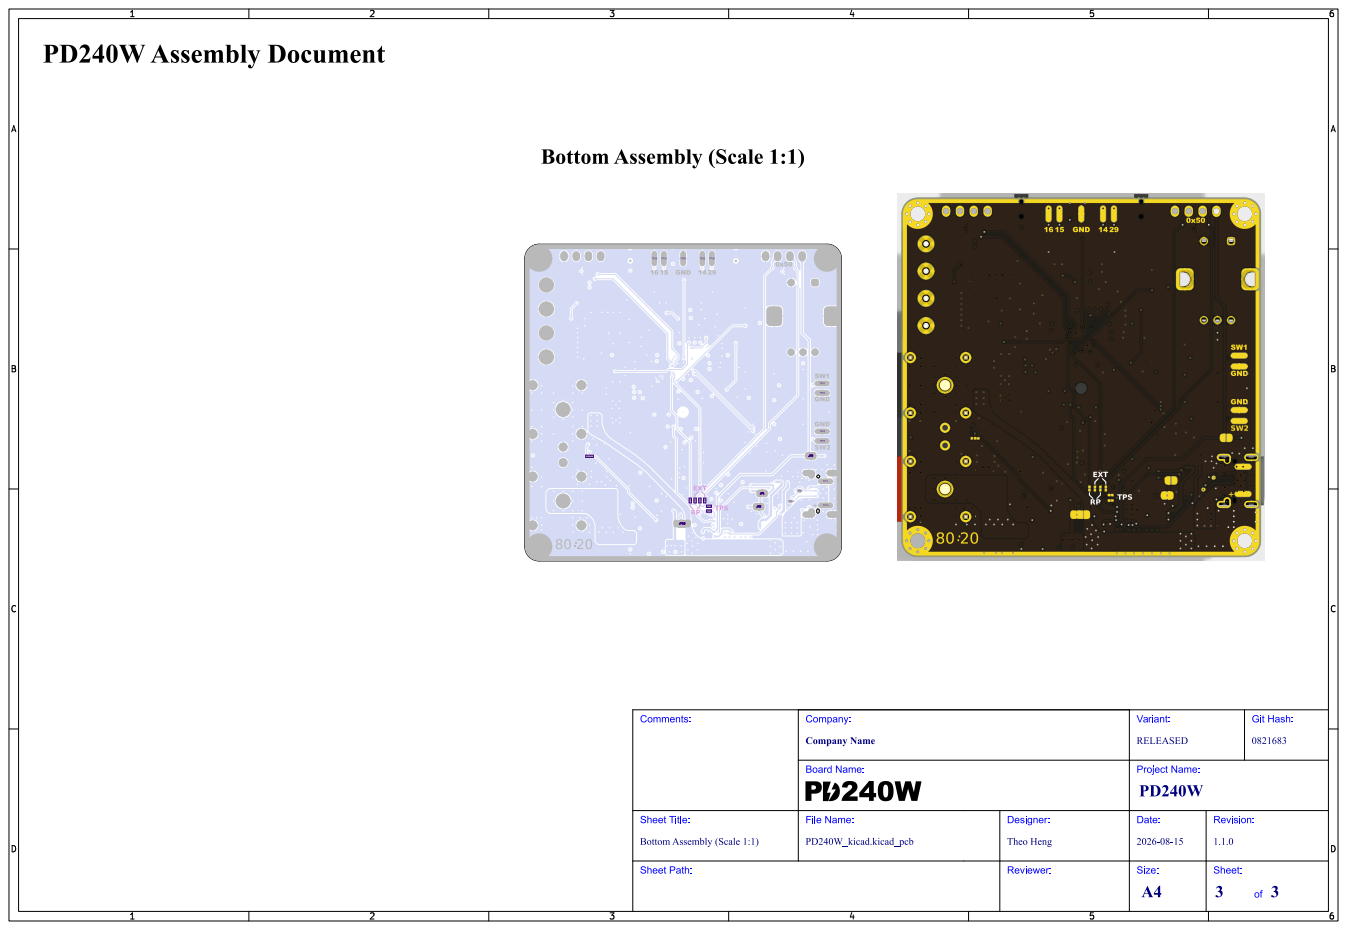
[picture p43: page 3]
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

Bottom Assembly (Scale 1:1)
