RileyCornelius/PD240W/hardware/Manufacturing/Fabrication/Gerbers/PD240W_kicad-NPTH_drill_map.pdf

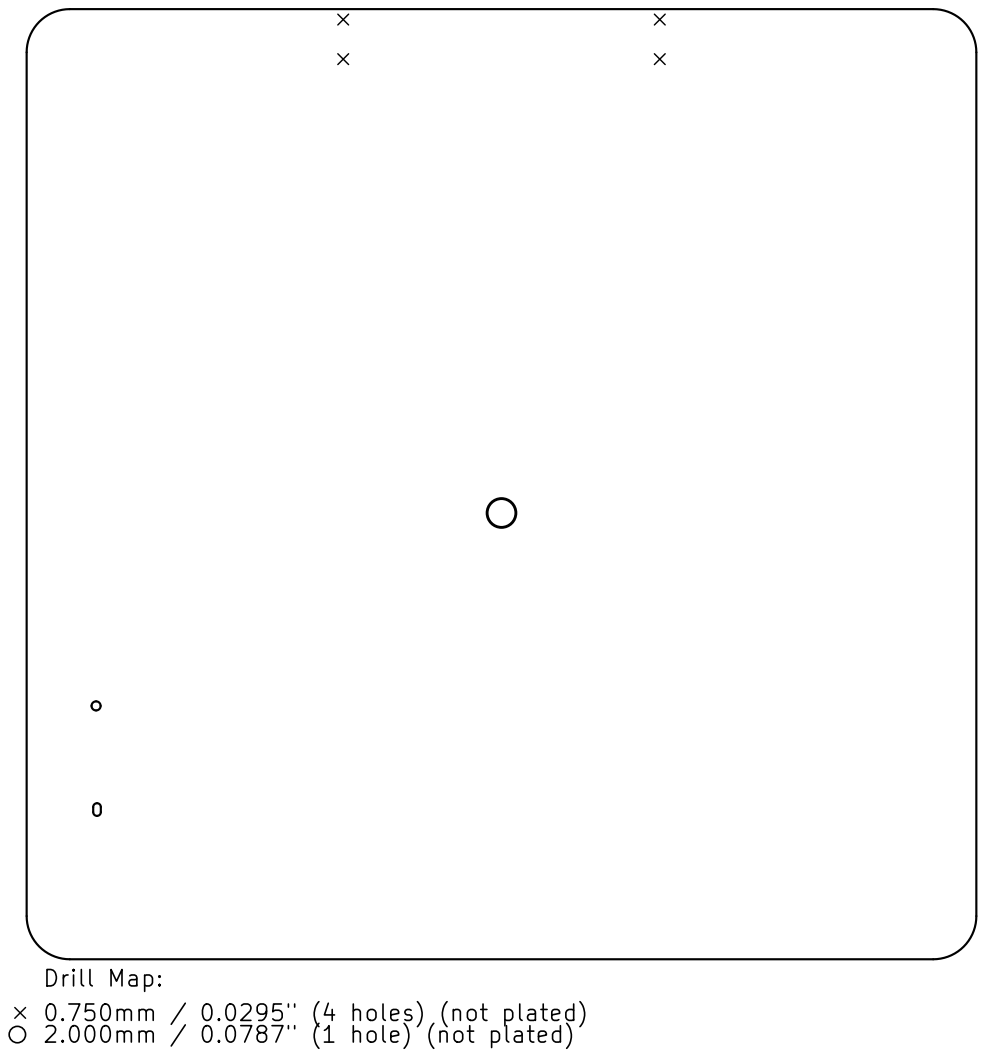
[picture p44: page 1]

Drill Map:
0.750mm / 0.0295" (4 holes) (not plated) 2.000mm / 0.0787" (1 hole) (not plated)
