RileyCornelius/PD240W/hardware/Manufacturing/Fabrication/Gerbers/PD240W_kicad-PTH_drill_map.pdf

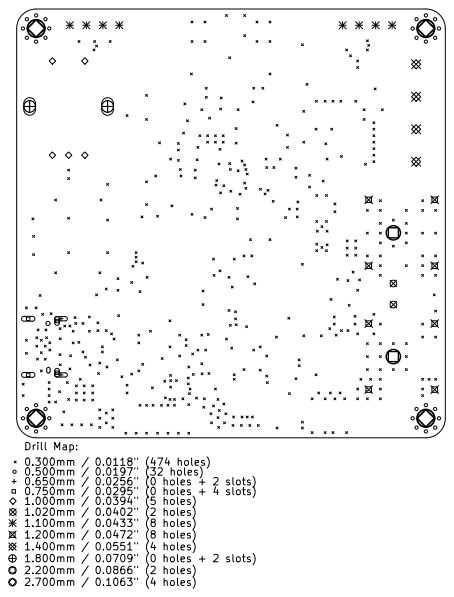
[picture p45: page 1]
