RileyCornelius/PD240W/PCB_files/PD240W_kicad.kicad_pcb

## KiCad design PCB_files/PD240W_kicad.kicad_pcb (continued)

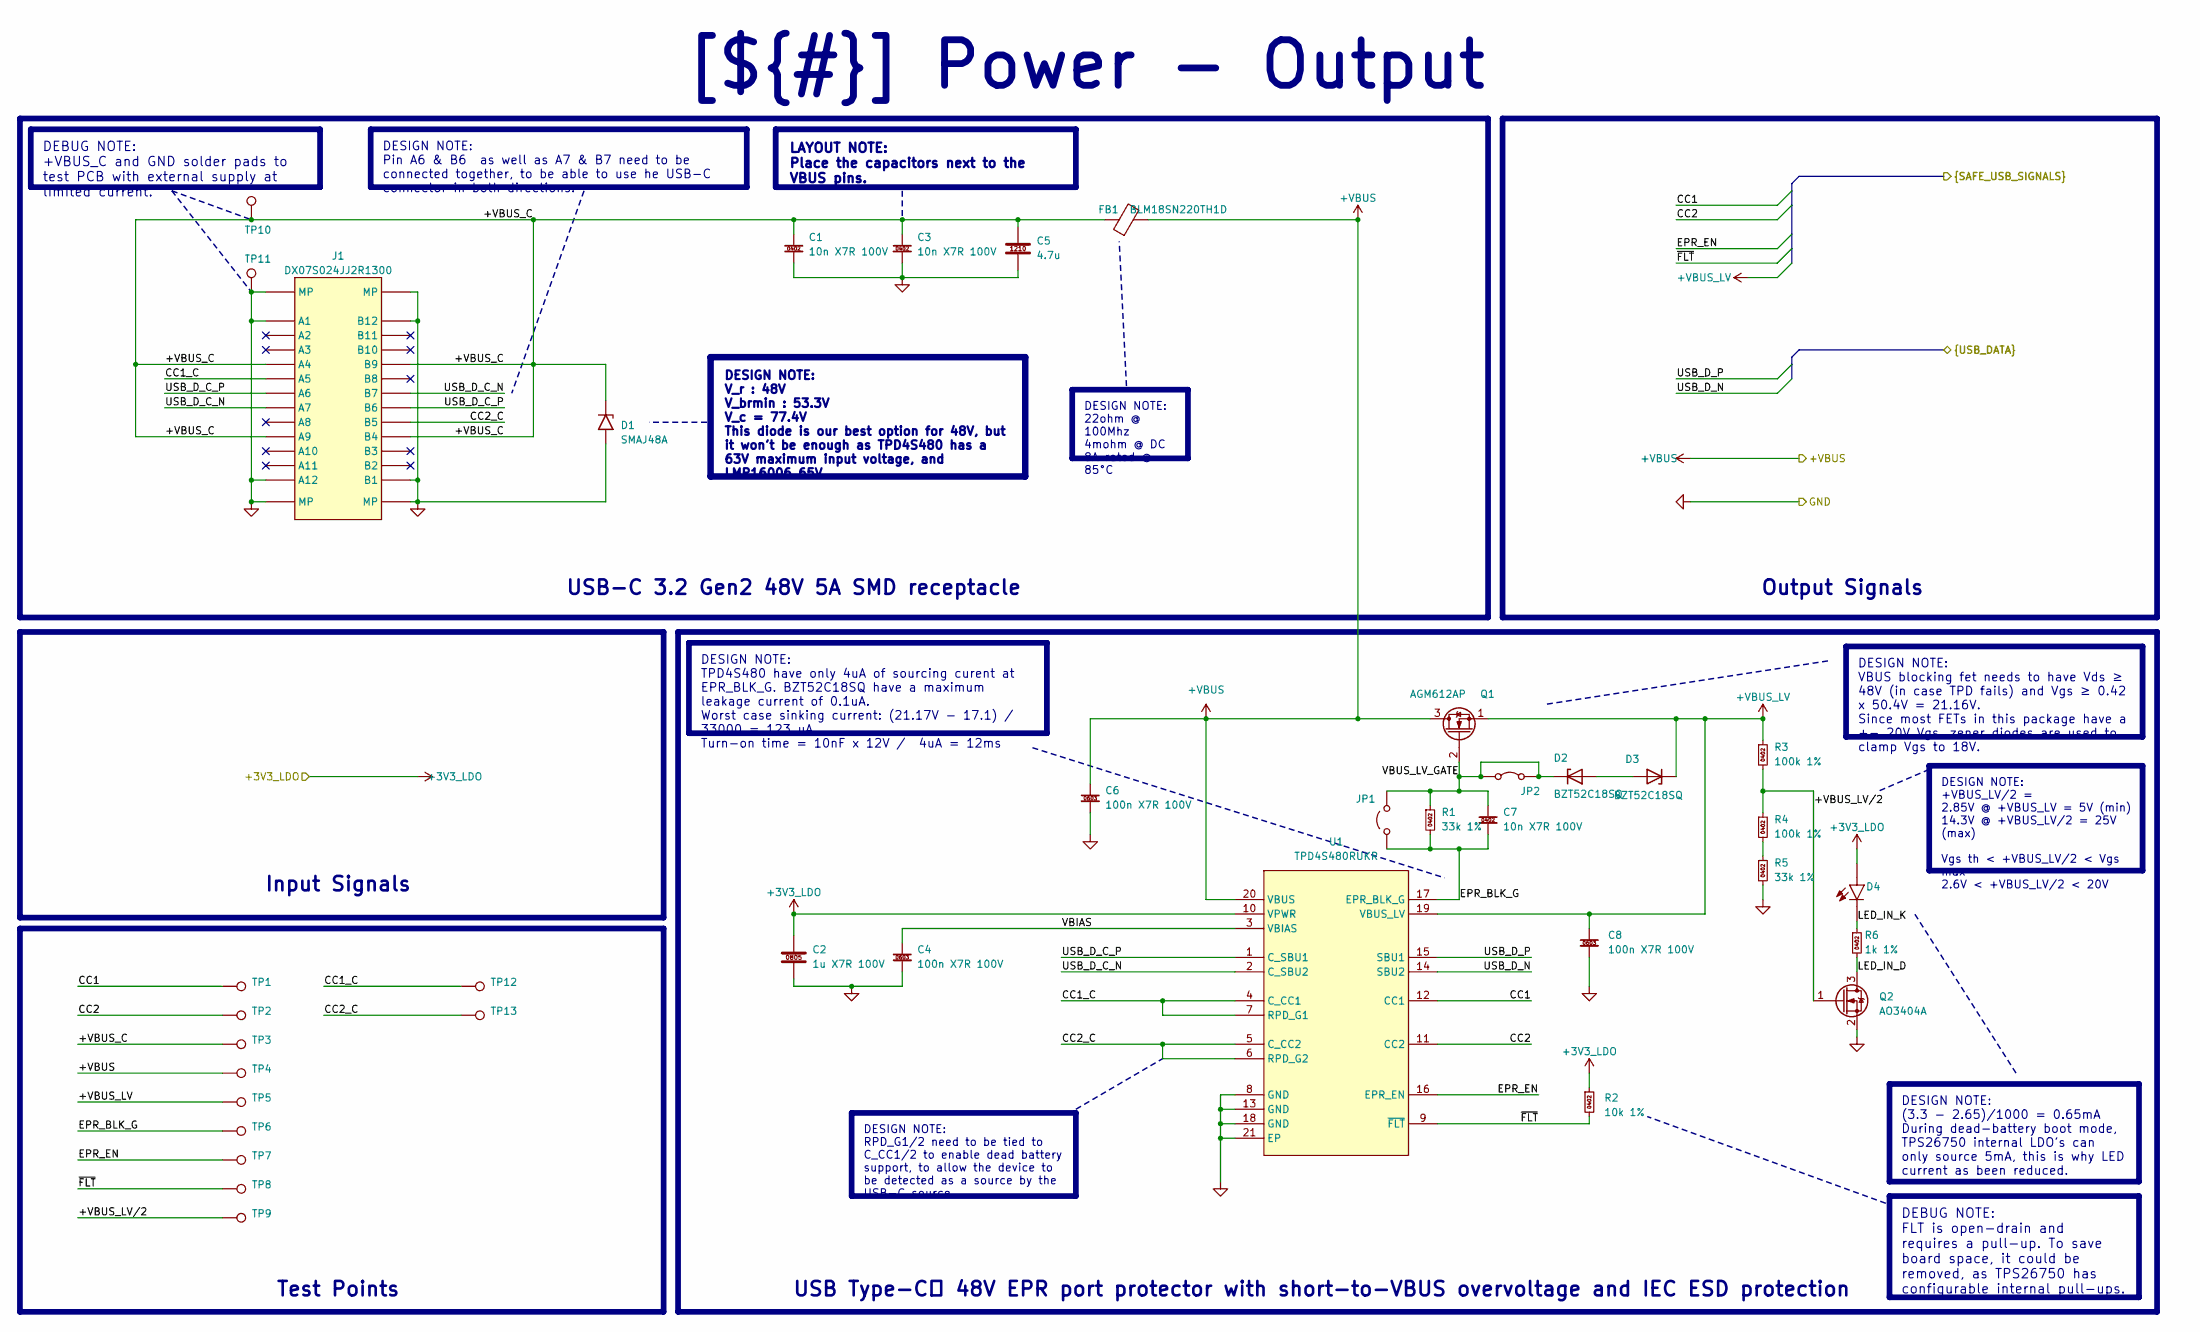
[picture p57: schematic power_usb_c_input.kicad_sch, Power - Output]

Parts:
C1, C3, C7: 10n X7R 100V; capc_1005_06_n; MFR Part # CC0402KRX7R0BB103; LCSC C527014
C2: 1u X7R 100V; capc_2012_14_n; MFR Part # CC0805KKX7R0BB105; LCSC C5370002
C4, C6, C8: 100n X7R 100V; capc_1608_09_l; MFR Part # CL10B104KC8NNNC; LCSC C15725
C5: 4.7u; capc_3225_22_n; MFR Part # GCM32DC72A475KE02; LCSC C913445
D1: SMAJ48A; do-214ac_440p_430x250x230_n_p; MFR Part # SMAJ48A; LCSC C41376401
D2, D3: BZT52C18SQ; sod-323_230p_170x125x100_n; MFR Part # BZT52C18SQ; LCSC C2857090
D4: APTD1608LQBC/D; kingbright_0603_blue; MFR Part # APTD1608LQBC/D; LCSC C5344742
FB1: BLM18SN220TH1D; fer_1608_09_n; MFR Part # BLM18SN220TH1D; LCSC C710392
J1: DX07S024JJ2R1300; MFR Part # DX07S024JJ2R1300; LCSC C2977282
JP1: jumper_solder_2pad_no; SolderJumper-2_P1.3mm_Open_RoundedPad1.0x1.5mm
JP2: jumper_solder_2pad_nc_kicad; SolderJumper-2_P1.3mm_Bridged2Bar_RoundedPad1.0x1.5mm
Q1: AGM612AP; vsonp8_65p_330x330x80_mfg; MFR Part # AGM612AP; LCSC C5349119
Q2: AO3404A; sot-23-3L_103p_300x130x110_n; MFR Part # AO3404A; LCSC C30010
R1, R5: 33k 1%; resc_1005_04_n; MFR Part # RC0402FR-0733KL; LCSC C138003
R2: 10k 1%; resc_1005_04_n; MFR Part # 0402WGF1002TCE; LCSC C25744
R3, R4: 100k 1%; resc_1005_04_m; MFR Part # 0402WGF1003TCE; LCSC C25741
R6: 1k 1%; resc_1005_04_m; MFR Part # 0402WGF1001TCE; LCSC C11702
TP1, TP2, TP3, TP4, TP5, TP6, TP7, TP8, TP9, TP12, TP13: tp_round_70
TP10, TP11: sp_oval_300x100
U1: TPD4S480RUKR; wqfn20_40p_300x300x80_tp_170x170_n; MFR Part # TPD4S480RUKR; LCSC C43131250

Connections:
+3V3_LDO: C2.1, D4.2 (A), R2.1, U1.10 (VPWR); also elsewhere on the board
+VBUS: C6.1, FB1.2, Q1.3 (D), TP4.1 (1_1), U1.20 (VBUS); also elsewhere on the board
+VBUS_LV: C8.1, D3.1 (K), Q1.1 (S), R3.1, TP5.1 (1_1), U1.19 (VBUS_LV); also elsewhere on the board
/Project Architecture/MCU - Unit/USB_D_N: U1.14 (SBU2); also elsewhere on the board
/Project Architecture/MCU - Unit/USB_D_P: U1.15 (SBU1); also elsewhere on the board
/Project Architecture/Power - PD Controller/CC1: TP1.1 (1_1), U1.12 (CC1); also elsewhere on the board
/Project Architecture/Power - PD Controller/CC2: TP2.1 (1_1), U1.11 (CC2); also elsewhere on the board
/Project Architecture/Power - PD Controller/EPR_EN: TP7.1 (1_1), U1.16 (EPR_EN); also elsewhere on the board
/Project Architecture/Power - PD Controller/~FLT: R2.2, TP8.1 (1_1), U1.9 (~FLT); also elsewhere on the board
/Project Architecture/Power - USB-C Input/+VBUS_C: C1.1, C3.1, C5.1, D1.1 (A1), FB1.1, J1.A4, J1.A9, J1.B4, J1.B9, TP3.1 (1_1), TP10.1 (1_1)
/Project Architecture/Power - USB-C Input/+VBUS_LV/2: Q2.1 (G), R3.2, R4.1, TP9.1 (1_1)
/Project Architecture/Power - USB-C Input/CC1_C: J1.A5, TP12.1 (1_1), U1.4 (C_CC1), U1.7 (RPD_G1)
/Project Architecture/Power - USB-C Input/CC2_C: J1.B5, TP13.1 (1_1), U1.5 (C_CC2), U1.6 (RPD_G2)
/Project Architecture/Power - USB-C Input/EPR_BLK_G: C7.2, JP1.1 (A), R1.2, TP6.1 (1_1), U1.17 (EPR_BLK_G)
/Project Architecture/Power - USB-C Input/LED_IN_D: Q2.3 (D), R6.2
/Project Architecture/Power - USB-C Input/LED_IN_K: D4.1 (C), R6.1
/Project Architecture/Power - USB-C Input/USB_D_C_N: J1.A7, J1.B7, U1.2 (C_SBU2)
/Project Architecture/Power - USB-C Input/USB_D_C_P: J1.A6, J1.B6, U1.1 (C_SBU1)
/Project Architecture/Power - USB-C Input/VBIAS: C4.1, U1.3 (VBIAS)
/Project Architecture/Power - USB-C Input/VBUS_LV_GATE: C7.1, D2.1 (K), JP1.2 (B), JP2.1 (A), JP2.2 (B), Q1.2 (G), R1.1
GND: C1.2, C2.2, C3.2, C4.2, C5.2, C6.2, C8.2, D1.2 (A2), J1.A1, J1.A12, J1.B1, J1.B12, J1.MP1 (MP), J1.MP2 (MP), J1.MP3 (MP), J1.MP4 (MP), Q2.2 (S), R5.2, TP11.1 (1_1), U1.8 (GND), U1.13 (GND), U1.18 (GND), U1.21 (EP); also elsewhere on the board
unnamed: D2.2 (A), D3.2 (A)
unnamed: R4.2, R5.1

Notes on the sheet:
USB Type-C™ 48V EPR port protector with short-to-VBUS overvoltage and IEC ESD protection
Test Points
Output Signals
Input Signals
USB-C 3.2 Gen2 48V 5A SMD receptacle
DEBUG NOTE: FLT is open-drain and requires a pull-up. To save board space, it could be removed, as TPS26750 has configurable internal pull-ups.
DESIGN NOTE: TPD4S480 have only 4uA of sourcing curent at EPR_BLK_G. BZT52C18SQ have a maximum leakage current of 0.1uA. Worst case sinking current: (21.17V - 17.1) / 33000 = 123 uA Turn-on time = 10nF x 12V / 4uA = 12ms
LAYOUT NOTE: Place the capacitors next to the VBUS pins.
DESIGN NOTE: 22ohm @ 100Mhz 4mohm @ DC 8A rated @ 85°C
[${#}] ${TITLE}
DESIGN NOTE: (3.3 - 2.65)/1000 = 0.65mA During dead-battery boot mode, TPS26750 internal LDO's can only source 5mA, this is why LED current as been reduced.
DESIGN NOTE: V_r : 48V V_brmin : 53.3V V_c = 77.4V This diode is our best option for 48V, but it won't be enough as TPD4S480 has a 63V maximum input voltage, and LMR16006 65V.
DEBUG NOTE: +VBUS_C and GND solder pads to test PCB with external supply at limited current.
DESIGN NOTE: +VBUS_LV/2 = 2.85V @ +VBUS_LV = 5V (min) 14.3V @ +VBUS_LV/2 = 25V (max) Vgs th < +VBUS_LV/2 < Vgs max 2.6V < +VBUS_LV/2 < 20V
DESIGN NOTE: VBUS blocking fet needs to have Vds ≥ 48V (in case TPD fails) and Vgs ≥ 0.42 x 50.4V = 21.16V. Since most FETs in this package have a +- 20V Vgs, zener diodes are used to clamp Vgs to 18V.
DESIGN NOTE: Pin A6 & B6 as well as A7 & B7 need to be connected together, to be able to use he USB-C connector in both directions.
DESIGN NOTE: RPD_G1/2 need to be tied to C_CC1/2 to enable dead battery support, to allow the device to be detected as a source by the USB-C source.

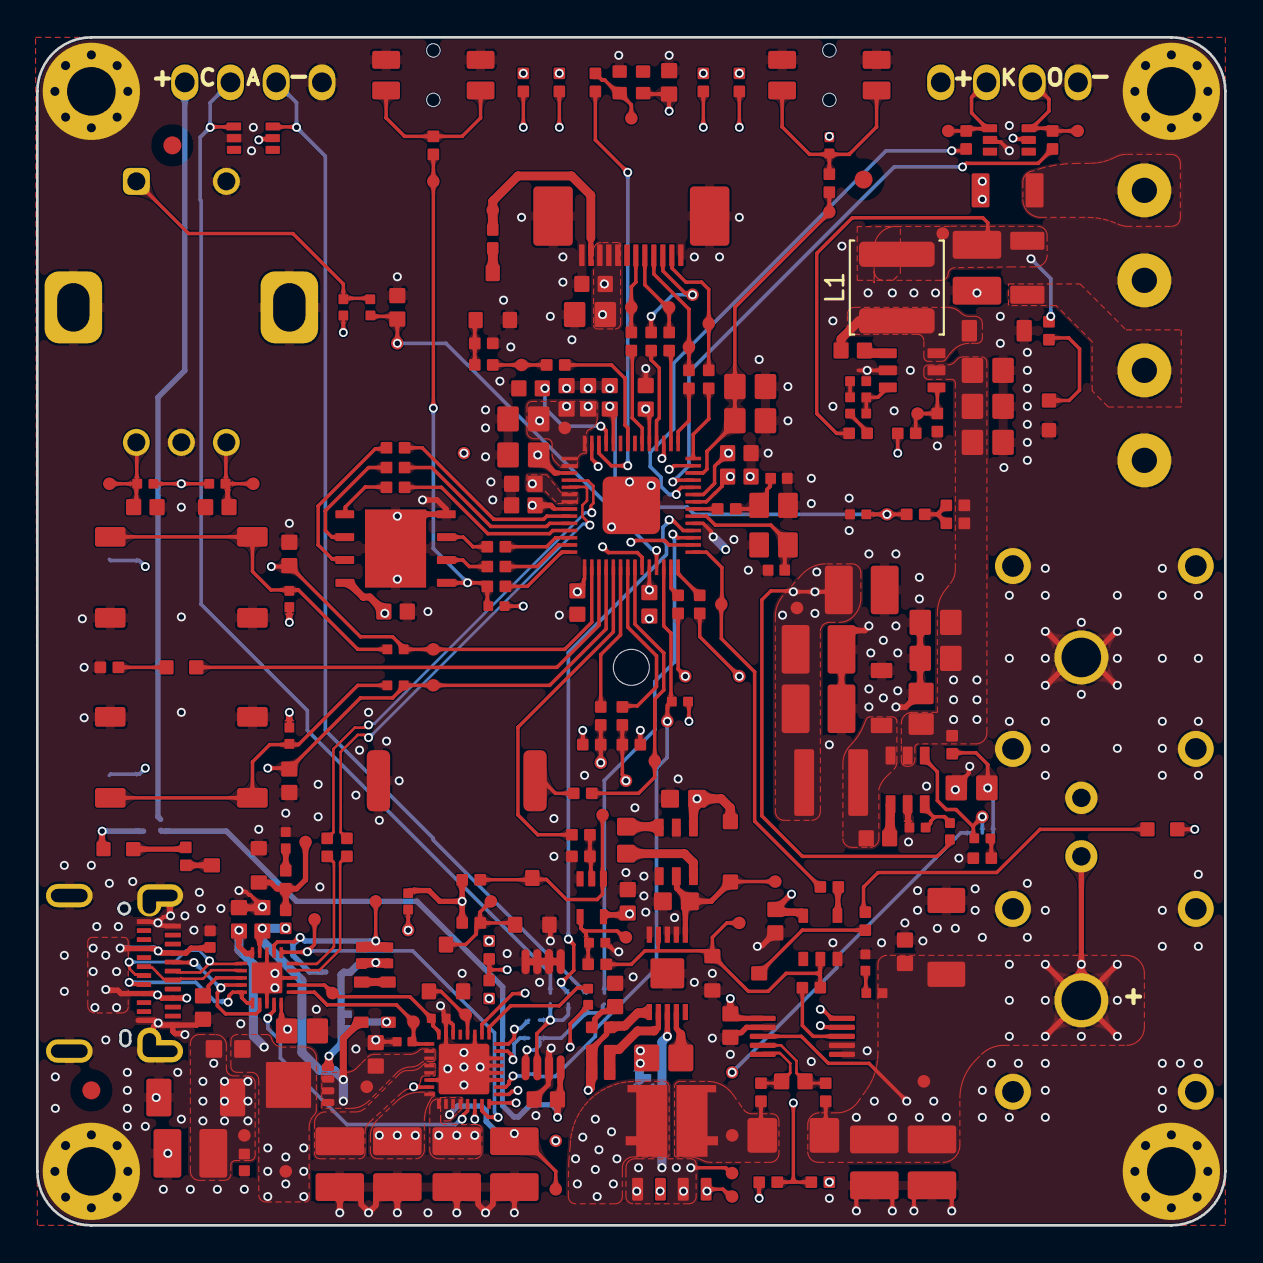
[picture p58: board PD240W_kicad.kicad_pcb from above]

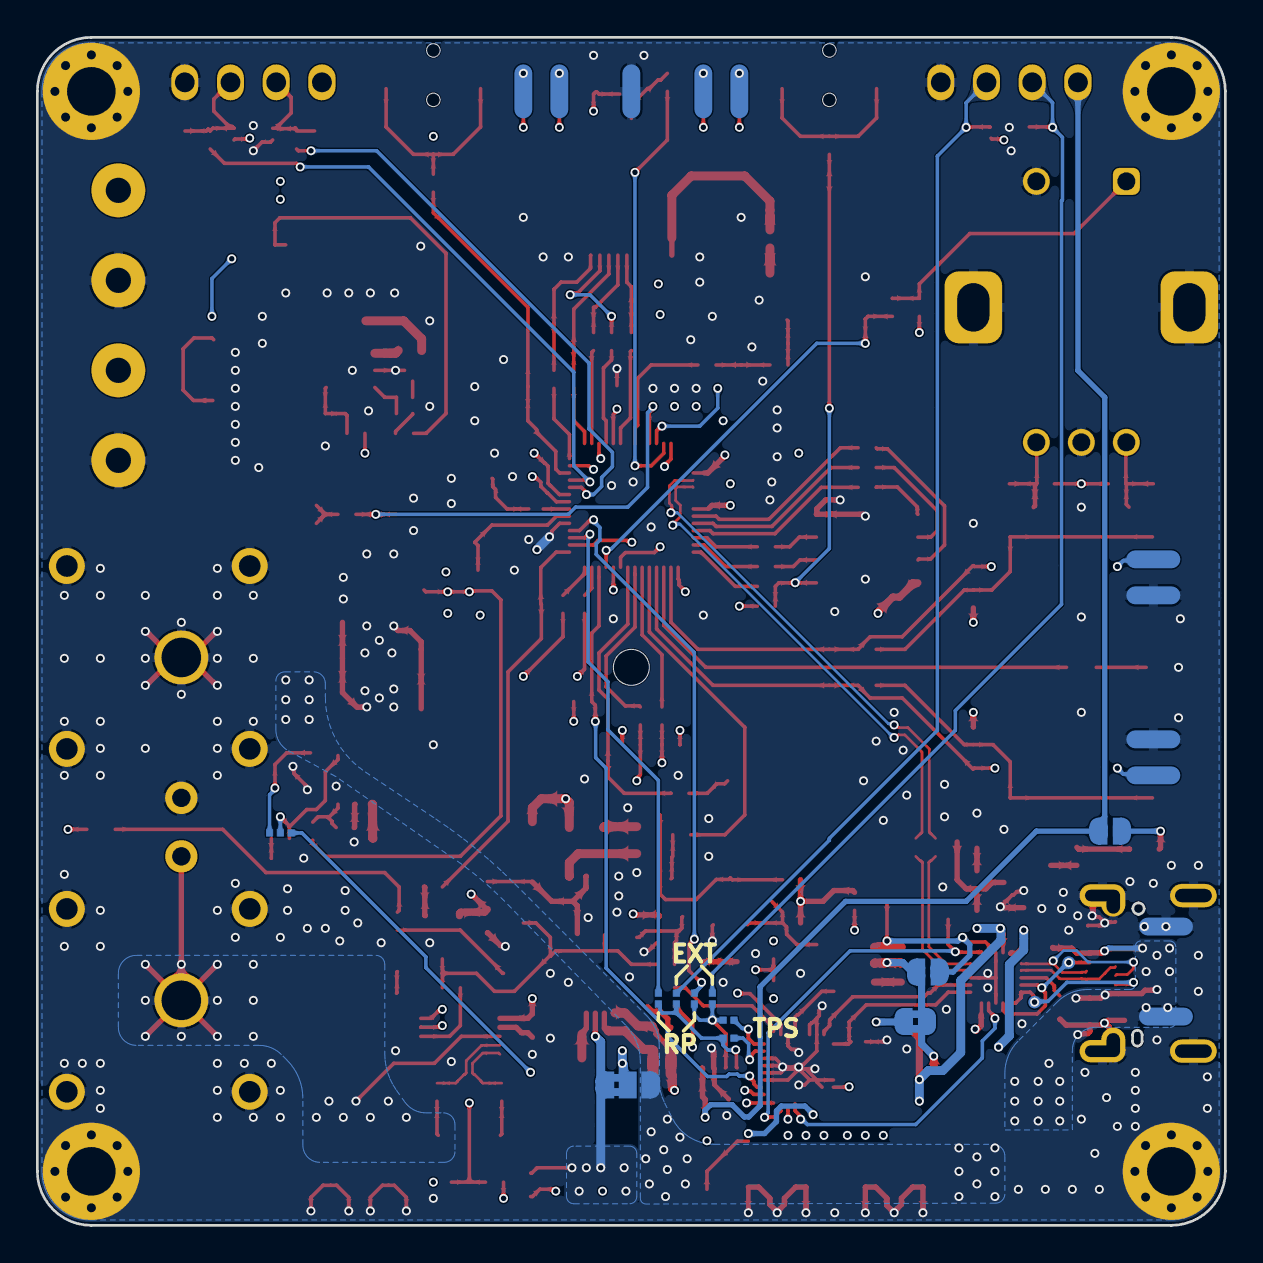
[picture p59: board PD240W_kicad.kicad_pcb from below]

Board: 6 copper layers, 66.0 x 66.0 mm, 299 parts (25 on the bottom side), 152 nets.
