RileyCornelius/PD240W/firmware/src/main.cpp

#include <Arduino.h>
#include "pico/stdlib.h"
#include "hardware/watchdog.h"
#include <stdio.h>
#include "hw/hardware.h"
#include "hw/interrupts.h"
#include "utils/logging.h"
#include "config/app_config.h"
#include "logic/state_machine.h"
#include "logic/settings.h"
#include "logic/safety.h"
#include "logic/pd_manager.h"
#include "logic/cc_controller.h"
#include "cli/cli.h"
#include "ui/display_manager.h"

// ============================================================================
// PD240W Power Supply - Main Application
// ============================================================================
// Phase 3: Application Logic with State Machine
//
// Architecture:
// - State machine controls application flow (BOOT -> MAIN <-> MENU <-> ADJUST, FAULT)
// - Safety module monitors temperature, voltage, current
// - PD manager handles USB-PD contract negotiation
// - Display manager renders screens based on state
// - All modules use non-blocking patterns
// ============================================================================

// Display refresh timing
static absolute_time_t next_display_update;

// The Arduino core owns main(): setup() runs once, then loop() is called
// forever. setup() holds the one-time init, loop() one superloop iteration.
void setup() {
    // =========================================================================
    // Phase 1: Hardware Initialization
    // =========================================================================

    // Initialize hardware (I2C, SPI, all drivers, EEPROM flash)
    hw.init();

    // Setup all GPIO interrupts (encoder, overcurrent, USB-PD)
    Interrupts::init();

    // =========================================================================
    // Phase 2: Module Initialization
    // =========================================================================

    // Initialize settings
    settings.init();

    // Reset INA228 energy/charge accumulators for energy tracking since boot
    hw.powerMonitor.setAccumulation(1); // Clear accumulators
    hw.powerMonitor.setAccumulation(0); // Resume normal accumulation

    // Initialize safety monitoring
    safety.init();

    // Initialize PD manager
    pdManager.init();

    // Initialize display manager
    displayManager.init();

    // Initialize state machine (starts in BOOT state)
    stateMachine.init();

    // Initialize CC controller (restores CC mode from settings)
    CcController::init();

    // Initialize serial CLI (command interface over UART/USB)
    Cli::init();

    // Setup display refresh timer
    next_display_update = get_absolute_time();

    LOG_SEPARATOR();

    // Arm the hardware watchdog now that one-time init is done. If a stuck I2C bus
    // (or any other fault) ever freezes the main loop, this reboots the device
    // instead of leaving safety/PD monitoring dead with the load switch possibly on.
    // The loop feeds it every iteration; the boot patch push feeds it between steps.
    watchdog_enable(AppConfig::WATCHDOG_TIMEOUT_MS, true);
}

// =========================================================================
// Main Event Loop
// =========================================================================

void loop() {
    // ---------------------------------------------------------------------
    // 1. Update State Machine
    // ---------------------------------------------------------------------
    // Handles encoder input, button events, and state transitions
    bool needs_display_update = stateMachine.update();

    // ---------------------------------------------------------------------
    // 2. Update Safety Module
    // ---------------------------------------------------------------------
    // Monitors temperature, voltage, and current
    SafetyStatus safety_status = safety.update();

    // Transition to FAULT state if safety issue detected
    // IMPORTANT: Skip fault transitions during BOOT state to allow boot sequence to complete
    if (safety_status == SafetyStatus::FAULT && stateMachine.getState() != AppState::BOOT) {
        if (safety.isOvertemperature()) {
            stateMachine.setFault(FaultType::OVERTEMPERATURE);
        } else if (!safety.isPdConnected()) {
            stateMachine.setFault(FaultType::PD_DISCONNECT);
        }
        needs_display_update = true;
    }

    // ---------------------------------------------------------------------
    // 3. Update PD Manager
    // ---------------------------------------------------------------------
    // Handles USB-PD interrupt processing and negotiation state
    pdManager.update();

    // ---------------------------------------------------------------------
    // 3b. Update CC Controller
    // ---------------------------------------------------------------------
    // Constant current regulation via PD voltage adjustment
    CcController::update();

    // ---------------------------------------------------------------------
    // 4. Update Settings (Debounced Flash Save)
    // ---------------------------------------------------------------------
    // Handles deferred flash saves to reduce wear
    settings.update();

    // ---------------------------------------------------------------------
    // 5. Update Display
    // ---------------------------------------------------------------------
    // Render at fixed rate (100ms) or when state changes
    if (needs_display_update || absolute_time_diff_us(next_display_update, get_absolute_time()) >= 0) {

        displayManager.render();
        next_display_update = make_timeout_time_ms(AppConfig::DISPLAY_UPDATE_MS);
    }

    // ---------------------------------------------------------------------
    // 6. Process Serial CLI
    // ---------------------------------------------------------------------
    // Non-blocking: reads available characters, dispatches complete commands
    Cli::update();

    // ---------------------------------------------------------------------
    // 7. Update Hardware
    // ---------------------------------------------------------------------
    // Required for RGB LED blinking and other timed operations
    hw.update();

    // ---------------------------------------------------------------------
    // 8. Feed the watchdog
    // ---------------------------------------------------------------------
    // Reaching here means a full loop iteration completed; keep the device
    // alive. A hung step (stuck bus) skips this and triggers a reboot.
    watchdog_update();
}
