RileyCornelius/PD240W/(commit log)

2026-08-15 Update 17V output to 5V output
2026-10-28 Remove old pico-sdk firmware
